myklemykle/tweacman/pcb/mykle-com-wble-tw-htm.png

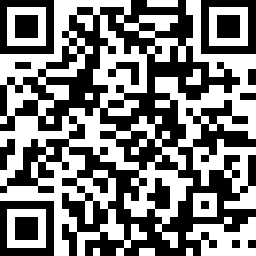
pcb/mykle-com-wble-tw-htm.png
