myklemykle/tweacman/pcb/cassette-carrier-bom.csv

References | Qty | Value | Buy (spec) | Manufacturer | MPN | Footprint | Notes | LCSC # | LCSC part | LCSC price (qty 1, USD) | LCSC stock | LCSC notes
C1, C2 | 2 | 6.8n | 6.8 nF, C0G/NP0 (or film), 50 V, radial, 5 mm lead pitch, 5% or better |  |  | C_Disc_D5.0mm_W2.5mm_P5.00mm | Sets the audio low-pass corner with R1/R2 (1k): tolerance and dielectric matter, avoid X7R here | C390177 | KYET PE682J2A0501 | 0.0437 | 2400 | Metallised polyester film 100 V 5%, 5 mm pitch. Only C0G found is C454391 (TORCH), stock 19, $0.454
C3, C4 | 2 | 2.2u | 2.2 uF non-polarised, film box (PET/PP) or radial MLCC, >=25 V, lead pitch 5.0-15.0 mm, under 10 mm tall |  |  | C_DCBlock_Dual | Audio DC blocker; the footprint takes 5.0/7.5/10.0/12.5/15.0 mm lead spacing. Film preferred for audio | C53070641 | DGCX MPE225J2AB070B200ZR | 0.35 | 750 | Polyester film 100 V 10%, 7.5 mm pitch. Alts: C3019042 KYET 5 mm $0.578; C46638925 WALSON 15 mm $0.203. Check height < 10 mm
C5, C6, C7, C8 | 4 | 100n | 100 nF, X7R, 50 V, radial, 5 mm lead pitch |  |  | C_Disc_D5.0mm_W2.5mm_P5.00mm | Pot wiper filter (4x) and general decoupling | C5632426 | KNSCHA 178MU0002 | 0.0138 | 5076 | X7R 50 V 10%, 5.08 mm pitch
C9 | 1 | 10u | 10 uF aluminium electrolytic, >=16 V, radial, 5 mm dia, 2.0 mm lead pitch |  |  | CP_Radial_D5.0mm_P2.00mm | Pot supply filter; watch the polarity (long lead = +) | C55265437 | TOPAZ ESS1V100M050700B | 0.0093 | 3244 | 35 V, 5 x 7 mm, 2 mm pitch
C10 | 1 | 10n | 10 nF, C0G/NP0 or X7R, 50 V, radial, 5 mm lead pitch, 10% or better |  |  | C_Disc_D5.0mm_W2.5mm_P5.00mm | CTSU TSCAP reference cap: needed for touch to work | C454414 | TORCH CC4-0805-CG-50V-0.01uF-J | 0.1285 | 6016 | C0G 5%, 5.08 mm pitch. Cheaper X7R: C5632432 KNSCHA $0.0196
J1 | 1 | STX-3120-3B | 3.5 mm stereo jack, right angle, all plastic | Kycon | STX-3120-3B | Kycon_STX-3120-3B | Colour variants exist; check the suffix at the vendor |  |  |  |  | not stocked at LCSC
J2 | 1 | LiPo JST-PH | JST PH 2-pin header, 2.0 mm, right angle (side entry), through hole | JST | S2B-PH-K-S(LF)(SN) | JST_PH_S2B-PH-K_1x02_P2.00mm_Horizontal | LiPo battery socket; rated 2 A | C173752 | JST S2B-PH-K-S(LF)(SN) | 0.0395 | 193766 | Looked up 2026-09-25
R1, R2 | 2 | 1k | 1 kOhm 1/8 W (or 1/4 W) axial, 1% metal film |  |  | R_Axial_DIN0204_L3.6mm_D1.6mm_P7.62mm_Horizontal | Audio low-pass resistor | C1371015 | YAGEO MFR-12FTF52-1K | 0.0045 | 3000 | 1% metal film, 1/6 W, 1.9 x 3.4 mm
R3 | 1 | 22 | 22 Ohm 1/8 W axial, 1% metal film |  |  | R_Axial_DIN0204_P7.62mm_CutJumper | Optional pot-supply filter resistor; the footprint's jumper shorts it until you cut it | C2848542 | VO MF1/8W-22R-1%-OT52 | 0.0066 | 2805 | 1% metal film, 1/8 W, 2.3 x 3.7 mm
R4, R5 | 2 | 560 | 560 Ohm 1/8 W (or 1/4 W) axial, 1% metal film |  |  | R_Axial_DIN0204_L3.6mm_D1.6mm_P7.62mm_Horizontal | Series resistor for each touch pad (CTSU) |  |  |  |  | No 1/8 W metal film in stock. 1/4 W bodies are ~6.3 mm long (tight on 7.62 pitch): C2848609 VO $0.0065, C1369978 YAGEO $0.0183
RV1, RV2 | 2 | RV112FF-40-25A-0B10K | Dual 10 kOhm endless rotary potentiometer, 25 mm plastic shaft | Taiwan Alpha | RV112FF-40-25A-0B10K | RV112FF-40 | Shaft length is in the part number; the footprint is the same for other lengths |  |  |  |  | not stocked at LCSC
SW1 | 1 | EG1224 | Slide switch, SPDT, right angle, 0.1 in pin pitch | E-Switch | EG1224 | SW_E-Switch_EG1224_SPDT_Angled | Power switch in the battery line (J2 to the Thing Plus's VBAT pin) | C273395 | E-Switch EG1224 | 1.7269 | 157
U1 | 1 | Thing Plus RA6M5 | SparkFun Thing Plus RA6M5, long variant, with male headers fitted | SparkFun |  | ThingPlus | The MCU board; not made by this project. Male-header pin tails must suit a 3 mm socket
XS1 | 1 | 1x12 socket | 1x12 female header, 2.54 mm, 3 mm insulation height (low profile), round-hole turned pin | HCTL | PM254-1-12-Z-3.0-C | None | LCSC C5156451; carries the Thing Plus left column | C5156451 | HCTL PM254-1-12-Z-3.0-C | 0.4265 | 496 | $0.3337 at 10+
XS2 | 1 | 1x16 socket | 1x16 female header, 2.54 mm, 3 mm insulation height (low profile), round-hole turned pin | HCTL | PM254-1-16-Z-3.0-C | None | LCSC C5159943; carries the Thing Plus right column | C5159943 | HCTL PM254-1-16-Z-3.0-C | 0.4704 | 223 | $0.3728 at 10+
RV1, RV2 | 2 |  | Knob, black, 24.1 mm dia x 10.3 mm tall, round, with a white indicator notch | Same Sky | SPK-013A |  | Check that the bore matches the RV112FF-40 shaft |  |  |  |  | not checked
U1 mounting | 4 |  | Screws + spacers/bushings for the Thing Plus mounting holes (3.05 mm holes), standoff about 5.5 mm |  |  |  | Your choice: spacer height = 3 mm socket + 2.5 mm header body
MH1-MH4 | 4 |  | M3 screws/standoffs for the case-mounting holes |  |  |  | Length depends on your case
