myklemykle/tweacman/hardware/scrub_knob.stl

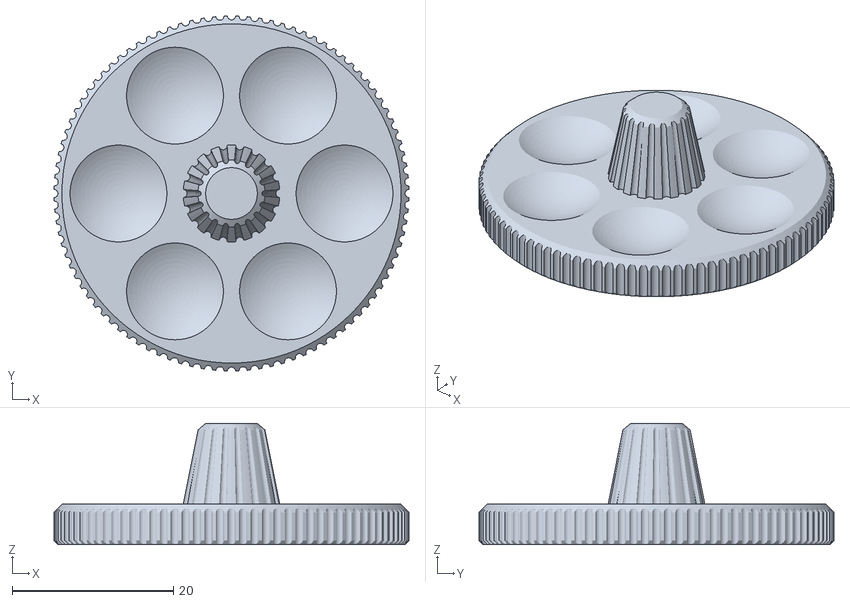
[picture p2: CAD file, 2026-10-06]
hardware/scrub_knob.stl
44.0 x 44.0 x 15.0
