myklemykle/tweacman/pcb/cassette-carrier.kicad_pcb

## KiCad design pcb/cassette-carrier.kicad_pcb (2026-10-10)

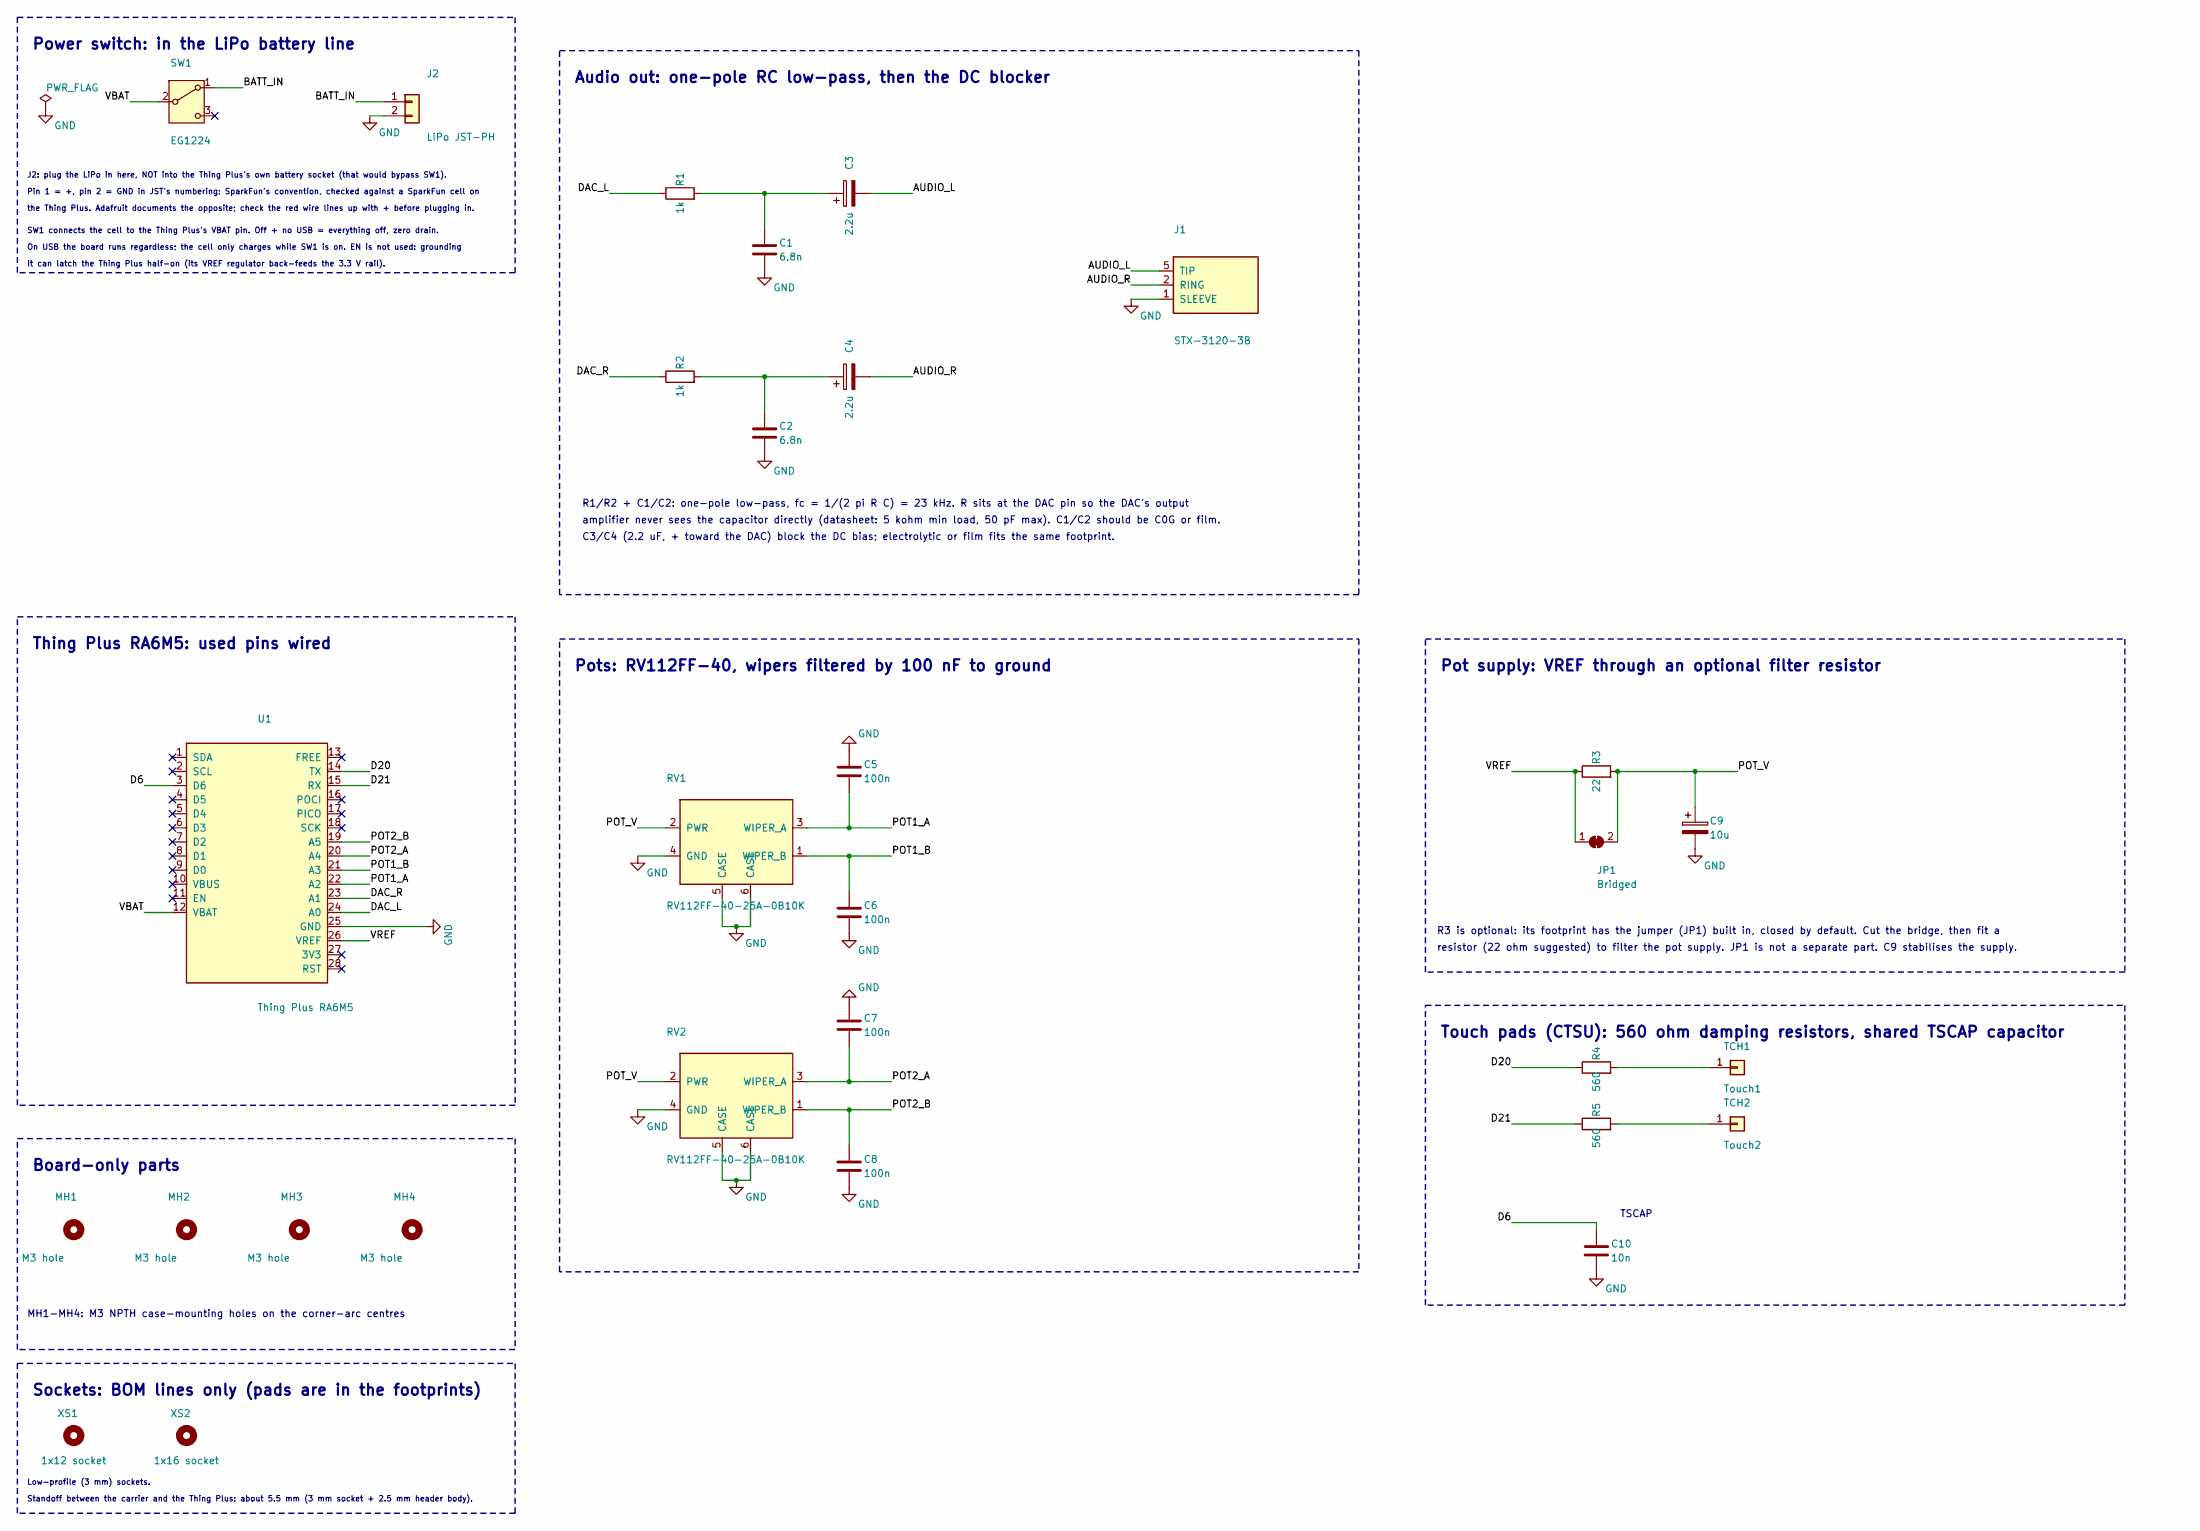
[picture p3: schematic cassette-carrier.kicad_sch, Cassette carrier]

Parts:
C1, C2: 6.8n; C_Disc_D5.0mm_W2.5mm_P5.00mm
C3, C4: 2.2u; C_DCBlock_Dual
C5, C6, C7, C8: 100n; C_Disc_D5.0mm_W2.5mm_P5.00mm
C9: 10u; CP_Radial_D5.0mm_P2.00mm
C10: 10n; C_Disc_D5.0mm_W2.5mm_P5.00mm
J1: STX-3120-3B; Kycon_STX-3120-3B
J2: LiPo JST-PH; JST_PH_S2B-PH-K_1x02_P2.00mm_Horizontal
JP1: Bridged; SolderJumper-2_P1.3mm_Bridged_RoundedPad1.0x1.5mm
MH1, MH2, MH3, MH4: M3 hole; MountingHole_M3_NPTH
R1, R2: 1k; R_Axial_DIN0204_L3.6mm_D1.6mm_P7.62mm_Horizontal
R3: 22; R_Axial_DIN0204_P7.62mm_CutJumper
R4, R5: 560; R_Axial_DIN0204_L3.6mm_D1.6mm_P7.62mm_Horizontal
RV1, RV2: RV112FF-40-25A-0B10K; RV112FF-40
SW1: EG1224; SW_E-Switch_EG1224_SPDT_Angled
TCH1: Touch1; TouchPad_33.6x16.8
TCH2: Touch2; TouchPad_33.6x16.8
U1: Thing Plus RA6M5; ThingPlus
XS1: 1x12 socket; MPN PM254-1-12-Z-3.0-C; LCSC C5156451
XS2: 1x16 socket; MPN PM254-1-16-Z-3.0-C; LCSC C5159943

Connections:
/AUDIO_L: C3.2, J1.5 (TIP)
/AUDIO_R: C4.2, J1.2 (RING)
/BATT_IN: J2.1, SW1.1 (A)
/D6: C10.1, U1.3 (D6)
/D20: R4.1, U1.14 (TX)
/D21: R5.1, U1.15 (RX)
/DAC_L: R1.1, U1.24 (A0)
/DAC_R: R2.1, U1.23 (A1)
/POT1_A: C5.1, RV1.3 (WIPER_A), U1.22 (A2)
/POT1_B: C6.1, RV1.1 (WIPER_B), U1.21 (A3)
/POT2_A: C7.1, RV2.3 (WIPER_A), U1.20 (A4)
/POT2_B: C8.1, RV2.1 (WIPER_B), U1.19 (A5)
/POT_V: C9.1, JP1.2 (B), R3.2, RV1.2 (PWR), RV2.2 (PWR)
/VBAT: SW1.2 (B), U1.12 (VBAT)
/VREF: JP1.1 (A), R3.1, U1.26 (VREF)
GND: C1.2, C2.2, C5.2, C6.2, C7.2, C8.2, C9.2, C10.2, J1.1 (SLEEVE), J2.2, RV1.4 (GND), RV1.5 (CASE), RV1.6 (CASE), RV2.4 (GND), RV2.5 (CASE), RV2.6 (CASE), U1.25 (GND)
unnamed: C1.1, C3.1, R1.2
unnamed: C2.1, C4.1, R2.2
unnamed: R4.2, TCH1.1
unnamed: R5.2, TCH2.1

Notes on the sheet:
Thing Plus RA6M5: used pins wired
Audio out: one-pole RC low-pass, then the DC blocker
R1/R2 + C1/C2: one-pole low-pass, fc = 1/(2 pi R C) = 23 kHz. R sits at the DAC pin so the DAC's output
amplifier never sees the capacitor directly (datasheet: 5 kohm min load, 50 pF max). C1/C2 should be C0G or film.
C3/C4 (2.2 uF, + toward the DAC) block the DC bias; electrolytic or film fits the same footprint.
Pots: RV112FF-40, wipers filtered by 100 nF to ground
Pot supply: VREF through an optional filter resistor
R3 is optional: its footprint has the jumper (JP1) built in, closed by default. Cut the bridge, then fit a
resistor (22 ohm suggested) to filter the pot supply. JP1 is not a separate part. C9 stabilises the supply.
Touch pads (CTSU): 560 ohm damping resistors, shared TSCAP capacitor
TSCAP
Power switch: in the LiPo battery line
J2: plug the LiPo in here, NOT into the Thing Plus's own battery socket (that would bypass SW1).
Pin 1 = +, pin 2 = GND in JST's numbering: SparkFun's convention, checked against a SparkFun cell on
the Thing Plus. Adafruit documents the opposite; check the red wire lines up with + before plugging in.
SW1 connects the cell to the Thing Plus's VBAT pin. Off + no USB = everything off, zero drain.
On USB the board runs regardless; the cell only charges while SW1 is on. EN is not used: grounding
it can latch the Thing Plus half-on (its VREF regulator back-feeds the 3.3 V rail).
Sockets: BOM lines only (pads are in the footprints)
Low-profile (3 mm) sockets.
Standoff between the carrier and the Thing Plus: about 5.5 mm (3 mm socket + 2.5 mm header body).
Board-only parts
MH1-MH4: M3 NPTH case-mounting holes on the corner-arc centres

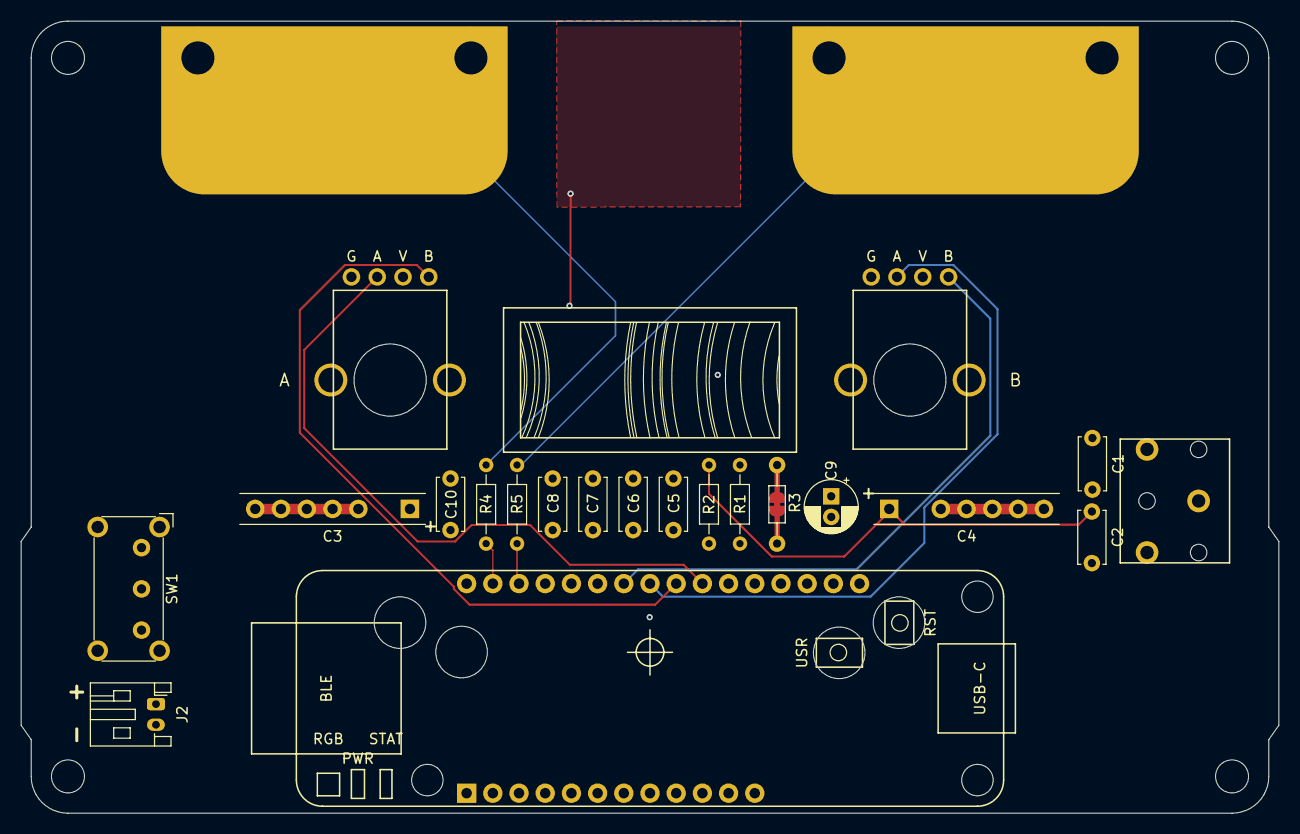
[picture p4: board cassette-carrier.kicad_pcb from above]

Board: 4 copper layers, 122.0 x 76.8 mm, 27 parts (0 on the bottom side), 20 nets.
