myklemykle/tweacman/RV112FF/src/RV112FF.h

// SPDX-License-Identifier: LGPL-3.0-or-later
// Copyright (C) 2026 Mykle Hansen
// Specified by Mykle Hansen, implemented by Claude (Anthropic).

/*
  RV112FF.h - Taiwan Alpha RV112FF-40 dual 360-degree potentiometer

  The RV112FF-40 is a single-turn potentiometer with two independent
  wipers, mechanically offset 90 degrees from each other on the same
  shaft. Wire its two track ends to a supply and ground, and its two
  wipers to two analog input pins: as the shaft turns, each wiper's
  voltage traces a triangle wave, and the two waves are 90 degrees out
  of phase with each other - like a pair of quadrature signals, just
  triangular rather than sinusoidal. That's enough to reconstruct an
  absolute shaft angle with plain trigonometry, no moving reference
  point and no interrupts required.

  API style follows PJRC's Encoder library - read() returns the current
  position, polled from loop() rather than interrupt-driven - with two
  differences that follow from the hardware itself rather than taste:

    - read() returns a float in degrees [0, 360), not an accumulating
      integer count. This pot has no multi-turn memory: it's a single-
      turn absolute sensor, so "position" means "where the shaft is
      right now," not "how far it's been turned since power-on."

    - There's no write(). An encoder's count is arbitrary and needs an
      external reference to mean anything, so write() lets you set that
      reference. This pot's angle is read directly off where the shaft
      physically is; there's nothing meaningful to set it to.

  Self-calibrating: each wiper's real-world voltage range varies with
  the individual pot and its wiring, so this tracks the observed
  min/max of each wiper as the shaft turns and uses that instead of
  assuming a fixed range. read() returns -1 until calibration is
  complete: the shaft has turned one full revolution since either
  wiper's observed range last grew. A full turn carries each wiper
  through both of its extremes, so a turn that finds nothing new means
  the whole range has been seen - in practice, about two turns from
  power-on. To skip that at every boot, save the calibration once with
  getCalibration() and restore it in setup() with setCalibration().

  Takes every bit the board's ADC has: on first use it calls
  analogReadResolution(16), regardless of what the rest of the sketch
  has set it to - that setting is board-wide, so other analogRead()s
  get 16-bit values too. Arduino's convention is that this only scales
  the result, padding a 12-bit reading with zeros, so it's right
  whatever the ADC's real resolution: exact on a 12-bit ADC, all 14
  bits of a 14-bit one. Two exceptions are handled below
  (RV112FF_ADC_BITS): Teensy 4 stays at 12 bits if asked for more, and
  classic AVR boards (Uno R3, Mega, Teensy 2) have no
  analogReadResolution() at all - their ADC is always 10 bits. On AVR,
  expect each read() to take about half a millisecond: two or more
  ~112us conversions, and atan2() and exp() in software floating point.
  AVR support compiles but is untested on real hardware.

  A note on NVM wear, if you're persisting getCalibration()'s result
  (e.g. with the EEPROM library, which on many boards is emulated in
  flash): that storage often doesn't wear-level, and EEPROM.put() only
  skips a write when the new bytes are byte-for-byte identical to
  what's already there. That's no help here, since the calibration
  envelope legitimately changes a little on almost every read() while a
  shaft is actively being calibrated. Call getCalibration() and save its result
  deliberately - once calibration completes, on a button press, rate-
  limited - not on every read().
*/

#ifndef RV112FF_h
#define RV112FF_h

#include <Arduino.h>

// The resolution this library asks analogReadResolution() for, and so the
// full scale it divides each reading by - see the class comment.
#if defined(__AVR__)
#define RV112FF_ADC_BITS 10  // classic AVR: always 10 bits, can't be set (untested)
#define RV112FF_FIXED_ADC_RESOLUTION
#elif defined(__IMXRT1062__)
#define RV112FF_ADC_BITS 12  // Teensy 4: stays at 12 bits if asked for more
#else
#define RV112FF_ADC_BITS 16
#endif

// Snapshot of a pot's calibration state, for storing in NVM (e.g. via
// EEPROM.put()/EEPROM.get() - see getCalibration()/setCalibration() below)
// and restoring after a reboot, so the sketch doesn't need the user to
// sweep the shaft through a full rotation again every power-on.
//
// magic and version aren't meant to be inspected by sketches - they let
// setCalibration() tell "this really is calibration data, written by a
// version of this library that laid it out the way I expect" apart from
// "this is erased flash, garbage, or an incompatible version" and refuse
// it rather than trust something it can't verify. checksum catches a
// write that got interrupted partway (e.g. power loss mid-save) -
// deliberately a plain byte sum rather than a real CRC, since the
// failure modes worth guarding against here are "garbage" and "partial
// write," not subtle single-bit corruption.
struct RV112FFCalibration {
  uint32_t magic;
  uint8_t version;
  uint8_t checksum;
  uint8_t complete;  // 1 if this snapshot was taken after calibration completed
  float minVal[2];
  float maxVal[2];
};

class RV112FF {
  public:
    // wiperPinA, wiperPinB: the two analog pins wired to the pot's wipers.
    // smoothTau: time constant (seconds) of the lowpass filter smoothing
    //   each wiper's raw reading - the main defense against ADC noise.
    // rpmSmoothTau: time constant (seconds) of rpm()'s own separate
    //   smoothing filter (see that method's comment). The default
    //   (0.15s) was tuned for using this pot as a position control,
    //   where rpm() is a secondary signal - a use that's read directly
    //   as an audio-rate control input (e.g. a tape-scrub effect) will
    //   likely want this much smaller, since a 150ms decay reads as
    //   noticeable "momentum" once rpm() itself is driving something
    //   audibly in real time.
    RV112FF(uint8_t wiperPinA, uint8_t wiperPinB,
            float smoothTau = 0.02, float rpmSmoothTau = 0.15);

    // Samples both wipers, updates calibration and the speed estimate,
    // and returns the current shaft angle in degrees [0, 360). Returns
    // -1 if not yet calibrated (see the class comment above). Call this
    // once per loop() pass; rpm() reports the speed computed as of the
    // most recent call here rather than sampling on its own.
    float read();

    // Rotational speed in RPM, signed: positive and negative indicate
    // opposite directions of rotation. Reflects the state as of the
    // last read() call. Lightly smoothed on its own, separately from
    // the position filter - speed is a derivative and amplifies noise
    // more than position does. Returns 0 before calibration.
    float rpm();

    // One wiper's reading as of the last read(), 0.0 to 1.0 of the ADC's
    // range: channel 0 is wiperPinA, 1 is wiperPinB. These are the
    // smoothed values the angle is decoded from, available even before
    // calibration completes - handy for plotting, to see what the pot
    // itself is doing.
    float wiper(uint8_t channel) const { return _smooth[channel ? 1 : 0]; }

    // True once calibration is complete - the shaft has turned a full
    // revolution since either wiper's observed range last grew (see the
    // class comment) - or a complete calibration has been restored with
    // setCalibration(). Until then read() returns -1 and rpm() returns 0.
    // Once true it stays true until resetCalibration(). The observed
    // range can still widen a little after that, and read() uses it.
    bool isCalibrated() const { return _calibrated; }

    // Forgets the observed min/max range and starts calibrating again
    // from the next read(). Not needed in normal use - the shaft only
    // has one range to learn - but useful if you suspect a bad reading
    // latched into the envelope before the pot had settled (e.g. right
    // after a noisy power-on).
    void resetCalibration();

    // Returns a snapshot of the current calibration, ready to hand to
    // something like EEPROM.put() for storage across a reboot. Save it
    // once isCalibrated() is true. A snapshot taken earlier is still
    // valid, but restoring it just resumes calibrating from that point,
    // with read() returning -1 until another full turn completes it.
    RV112FFCalibration getCalibration() const;

    // Restores a previously-saved calibration (see getCalibration()).
    // Returns true and adopts it if it passes validation (magic, version,
    // checksum, and a basic sanity check on the ranges); otherwise leaves
    // the current calibration state untouched and returns false. Safe to
    // call with anything - freshly-erased flash, a different pot's data,
    // data from an incompatible future version of this library - it will
    // simply refuse rather than trust something it can't verify. Deciding
    // *when* to call this, and when to call getCalibration() to persist
    // one, is left to the sketch - see the class comment's note on NVM
    // wear if you're saving what this returns.
    bool setCalibration(const RV112FFCalibration &cal);

    // How many extra conversions to make, and throw away, before each
    // wiper reading that counts. Default 1.
    //
    // Why: most microcontrollers' ADCs measure a pin by charging one small
    // internal capacitor shared by every analog pin, and a pot's wiper is a
    // high-impedance source that charges it slowly - so a reading can come
    // out pulled toward whichever pin was measured just before it. With
    // two pots on neighbouring pins, turning one then makes the other seem
    // to move. A throwaway conversion first is the standard portable
    // remedy, and costs a few microseconds per wiper.
    //
    // Set it to 0 if your board fixes this properly in hardware - e.g. by
    // lengthening the ADC's sampling time, on chips that allow it, which
    // can remove it outright and make the extra conversion pure overhead.
    // Raise it if you measure crosstalk left over on a board without such
    // an option.
    void setSettlingReads(uint8_t reads) { _settlingReads = reads; }
    uint8_t getSettlingReads() const { return _settlingReads; }

    // How many readings of each wiper to average into one, taken back to
    // back. Default 1 (no averaging). Averaging N readings cuts fast,
    // random ADC noise by about the square root of N - 4 halves it - at
    // the cost of N conversions instead of one, a few microseconds each on
    // most boards. It adds no lag, since all N are taken at once: unlike
    // raising smoothTau, it doesn't make the knob respond more slowly.
    // It can't reduce slow noise such as mains hum, which looks the same
    // in all N readings. Worth raising when rpm() drives something that
    // needs to sit perfectly still at rest.
    void setOversampling(uint8_t readings) { _oversampling = (readings < 1) ? 1 : readings; }
    uint8_t getOversampling() const { return _oversampling; }

    // How much of the ADC's full scale (0.0-1.0) each wiper must have swept
    // before the pot starts working out an angle at all. Default 0.15.
    //
    // Why: the angle comes from each wiper's reading as a fraction of the
    // range it has swept so far. Over a tiny range, ADC noise alone would
    // turn into wild swings of angle, and spoil the count of the full turn
    // that completes calibration (see isCalibrated()) - so nothing is
    // decoded until the range is big enough to trust. It doesn't set when
    // calibration completes; that's the full turn. setCalibration() also
    // refuses a saved range smaller than this, as bad data.
    //
    // You'd only lower it if a wiper can't swing that far on your wiring -
    // say a series resistor in the track, or track ends on a voltage well
    // below the ADC's reference. Then the pot never calibrates at all, and
    // nothing says why: plot each wiper() while turning the knob to see
    // its real swing, and set this comfortably below it. Set it before
    // setCalibration(), which checks against it.
    void setMinCalibrationRange(float fraction) { _minCalibrationRange = fraction; }
    float getMinCalibrationRange() const { return _minCalibrationRange; }

  private:
    uint8_t _pinA, _pinB;
    float _smoothTau;
    float _minCalibrationRange = 0.15;
    float _rpmSmoothTau;
    uint8_t _settlingReads = 1;
    uint8_t _oversampling = 1;

    float _smooth[2];
    float _minVal[2];
    float _maxVal[2];

    float _angle = -1;
    float _prevAngle = -1;
    float _rpm = 0;
    bool _calibrated = false;

    // Progress toward a complete calibration: the observed range as it
    // stood when the current turn started counting, and the lowest and
    // highest unwrapped angle reached since then. See read().
    float _markMin[2];
    float _markMax[2];
    float _turnPos = 0;
    float _turnLow = 0;
    float _turnHigh = 0;

    // How far, as a fraction of full scale, a wiper's observed range may
    // grow without restarting the turn count. The smoothed signal creeps
    // up on a peak in tiny steps, and noise can nudge it, so any growth
    // at all would make a turn that finds nothing new hard to finish.
    static constexpr float RANGE_GROWTH_TOLERANCE = 0.005;
    bool _begun = false;
    unsigned long _lastMicros = 0;

    static constexpr float ADC_MAX_VALUE = (1UL << RV112FF_ADC_BITS) - 1;

    static constexpr uint32_t CALIBRATION_MAGIC = 0x52563132;  // ASCII "RV12"
    static constexpr uint8_t CALIBRATION_VERSION = 2;

    float readWiper(uint8_t pin, uint8_t channel, float dtSeconds);
    bool rangeGrewSinceMark() const;
    void restartTurnCount();

    static uint8_t sumBytes(const void *data, size_t len, uint8_t sum);
    uint8_t calibrationChecksum(const RV112FFCalibration &cal) const;
};

#endif
