myklemykle/tweacman/SDResampleDemo/SDResampleDemo.ino

// SPDX-License-Identifier: GPL-3.0-or-later
// Copyright (C) 2026 Mykle Hansen
// Specified by Mykle Hansen, implemented by Claude (Anthropic).

/*
  SDResampleDemo - SparkFun Thing Plus RA6M5

  Streams a WAV file off the onboard SD card and plays it out the DAC,
  with one pot controlling a completely smooth, arbitrary, BIDIRECTIONAL
  playback-speed ratio - not discrete multiples, and slowing down (in
  either direction) genuinely interpolates new sample values rather than
  just repeating or stepping through existing ones. The pot sweeps from
  -MAX_RATIO smoothly through zero at the middle up to +MAX_RATIO;
  negative plays the file backward. A second pot scrubs, like a hand
  on the reel - see "Tape scrub" below. A phone/browser can also pick
  which file plays and watch the same live stats over BLE - see "BLE
  control" below.

  Wiring: an SD card (FAT32, any SDHC card - see the SD note in
  CLAUDE.md, this board's slot is wired to the RA6M5's native SDHI
  peripheral, not SPI) with WAV files on it - at its root, or sorted into
  folders, one per set (see "Sets" below) - use
  tools/make_test_wav.py to generate a simple one, a slow sine sweep
  that makes speed changes and any resampling artifacts obvious by ear.
  Otherwise same as DACAudioTest (3.5mm jack on A0/A1/GND) plus two pots
  (RV112FF wipers on A2/A3 for speed or pitch, A4/A5 for tape scrub or
  time-stretch, both pots' track ends on 3.3V/GND) and two CapTouch pads
  (D20 steps through the knob modes, and chorded with D21 latches the
  transport;
  D21 is the transport itself - hold it to run, release to stop; both
  share the TSCAP capacitor on D6 - see RA6M5CapTouch.h). The onboard WS2812
  on D13 shows the knob mode and the blue STAT LED the transport - no extra
  wiring. The DA14531MOD Bluetooth
  module used for BLE control is already onboard -
  no extra wiring for that part.

  Why the DAC runs at a fixed 48kHz: an earlier version of this idea
  just changed the DAC's own output clock to change speed, tape-style -
  simple, but it directly couples "how fast can we go" to the DAC
  hardware's own conversion-time ceiling (~333kHz per the RA6M5
  datasheet, Table 53.48). This version fixes the DAC at a constant,
  comfortable 48kHz always, and does real-time resampling from whatever
  rate the source is actually being read at. That decouples the speed
  knob from the DAC entirely.

  How the resampling works: RingBuffer.h holds raw samples read from SD,
  as a window that can slide in EITHER direction; Resampler.h tracks a
  signed fractional read position into that window and advances it by a
  continuously-variable, signed amount (`step`) once per 48kHz tick,
  interpolating a fresh output value with a windowed-sinc kernel each
  time (SincInterpolator.h) - one that low-passes as it goes when reading
  faster than real time, so speeding up never aliases. The same mechanism handles speeding up, slowing down,
  reversing direction, and pausing (step == 0, which freezes the
  position exactly with no special-casing needed) with no separate code
  path for any of them - see both of those files' own comments for more
  detail, and loop()'s refill comment for how the SD-reading side stays
  in sync with whichever direction is currently active.

  Very high speeds - cached copies: the speed range runs to MAX_RATIO,
  1024x, which is enough to sweep a 20Hz tone right up past 20kHz. Read
  straight from the WAV, that would be hopeless on two counts. The card
  can't deliver it - reading a 44.1kHz file at 20x already means reading
  20 seconds of audio every second, and that's where this demo used to
  hit its wall (~20x forward, ~13x backward). And it would sound wrong
  long before that: content pushed above what the DAC can reproduce
  doesn't vanish, it folds back down as aliasing - tones that move the
  wrong way as the speed rises, with a ring-modulator sound to them.

  So MipCache.h builds a ladder of filtered copies of each file on the
  card, in a cache/ folder - at 1/2, 1/4 ... 1/1024 of its sample rate,
  each holding only what will still be audible at the speeds it serves.
  At any speed, playback reads whichever copy keeps it stepping through
  about one sample per output sample (see chooseLevel()), so the card is
  never asked for much more than real time, whatever the speed, and
  aliasing stays out of the way. Changing copies is a straight swap
  between two playback voices, one playing while the other is readied
  (see "Playback voices" below, and startLevelChange()). Copies are built in the background the first time
  a file is cued - a few seconds for a short sample - and until they're
  ready the fastest speeds are capped; the Serial status and the BLE
  CACHE: field show progress. The copies live as long as their WAV and
  are rebuilt if it changes - see "BLE control" below for what happens to
  them when the web page uploads, renames or deletes a file.

  The copies alone don't make changing between them seamless, though.
  Each copy is free of aliasing only up to one sample per tick, so reading
  one any faster - which happens just below every switch - used to alias,
  and the switch made it suddenly vanish. What fixes that is the interpolator: it
  low-passes as it reads (SincInterpolator.h), so every copy is band-
  limited the same way on both sides of a switch. That costs CPU in the
  audio interrupt - the Serial status line reports how much ("isr avg/max",
  roughly 20-30% for mono and 30-40% for stereo normally, up to about 45%
  and 60% with the pitch shifter on, and about 12% more while the filter
  is in use - see "Filter"), along with "dropped", a count of audio ticks that never ran because
  something held interrupts off for longer than a tick (it restarts at
  each file load and transport start, which pause the audio on purpose).
  It should stay at zero; if it climbs, something is blocking too long.

  Tape scrub: turning the second pot takes over the playback cursor
  outright, like grabbing the reel - the transport waits underneath, and
  when the knob has been still for SCRUB_RELEASE_MS (150ms) playback
  carries on from wherever the knob left the tape. It works the same
  whether the transport runs or not. The knob's change in angle, not its
  speed, sets where the cursor should be, and the cursor is steered onto
  that target - so the knob's position maps exactly onto the file, and a
  small backlash (SCRUB_BACKLASH_DEGREES) keeps a resting knob silent
  without losing any of a long turn. How much of the file a turn covers
  is fitted to each file as it loads: about one second of audio, moved
  to the nearest power-of-two fraction or multiple of the file's length,
  so whole turns line up with the file's loop - see
  SCRUB_SECONDS_PER_TURN and scrubKnob().

  Relative speed control: the first pot is RELATIVE (like a DJ jog wheel
  or a DAW's jog control), not ABSOLUTE (like a normal volume knob, where
  a given shaft position always means the same value). Each file starts
  at its own saved speed - native (1.0x) for a file played for the first
  time, see "Per-file settings" below - regardless of wherever the
  physical pot happens to be sitting; only turning the pot moves speed
  from there, and by however much you turn it, not to wherever the pot's
  absolute position would otherwise map. This matters because the pot
  has no mechanical center detent or home position (see RV112FF.h - it's
  an endless-rotation part with no absolute "zero" a hobbyist could
  return it to), so an absolute mapping would make "start every file at
  native speed" impossible to hit reliably by hand. See knobForSpeed()/resetVirtualKnobToNative() and
  the control-rate block in loop() for the implementation - a small
  virtual position that starts anchored at native speed and accumulates
  the pot's own physical deltas from then on, the same idea as a
  relative/incremental encoder even though the underlying sensor is an
  absolute one.

  Per-file settings: each WAV keeps its own speed, pitch, window (see
  "Start and end points"), echo and filter, in a small text file under the card's settings/ folder (see FileSettings.h), so
  picking it again - or rebooting - brings them back. They're saved two
  seconds after the last change, and at once when another file is picked.
  The same folder remembers which file was cued, and the board cues it
  again at boot instead of the first file on the card. Settings follow a
  file when it's renamed, go when it's deleted, and survive uploading a
  new version of it.

  Underrun policy: if the ring buffer can't supply what the resampler
  needs, the DAC ISR holds the last good sample rather than dropping to
  silence - that's what a real buffer-starved device actually sounds
  like (a stuck stutter), and it avoids an extra click on both entering
  and leaving the underrun. The resampler's position is frozen too, so
  playback resumes exactly where it left off with no skipped content.
  underrunTicks (printed periodically over Serial, along with live ring
  buffer occupancy) should stay at zero at any speed once a file's
  copies are built - if it climbs, something is starving playback. It counts underruns for the *current file only*, resetting on every
  load, and does not tick at all while no file is loaded: with nothing
  playing there is no producer to fall behind, so idling is not an
  underrun. Before that distinction existed the counter accumulated
  48000 phantom underruns a second while the board sat idle at boot,
  which made the real figure meaningless.

  BLE control: connect with web/wav-remote.html (self-hosted with real
  HTTPS - can't be a Claude Artifact, see CLAUDE.md's Bluetooth section)
  to list the WAV files on the card, pick one, see and change everything
  the knobs set (a card per knob mode, the current one highlighted), and
  watch the same buffer/underrun stats live instead of over USB Serial.
  Reuses the
  CodeLess Binary mode/DSPS bidirectional protocol already validated in
  AudioKnobsWebBLEDemo - see that sketch and the codeless-binary-mode-
  dsps-protocol memory for the handshake itself. On top of that
  transport, this sketch speaks a small plain-text line protocol:
  `LIST` requests a `SETS:BEGIN`/one-`<set>|<gap>`-per-line/`SETS:END`
  block - the card's sets, see "Sets" below, "/" being the WAVs at its
  root - and then a `FILES:BEGIN:<set>`/one-name-per-line/`FILES:END:<n>`
  block (n being how many names were sent) for the current file's set, in the order the file knob steps
  through them (natural, case-blind - see WavList.h), so a client shows
  them as they come; `LIST:<set>` is the same with another set's names.
  A file is named everywhere else by its path, `<set>/<name>` (just
  `<name>` at the root). `PLAY:<path>` requests a switch, answered with `PLAYING:<name>` on
  success or `ERR:<name>:<reason>` on failure - a bad or unsupported
  file is a normal, reported failure, not a hang. The periodic stats line
  carries `RUN:0|1` alongside `SPD:`/`BUF:`/`UND:`, so a client can show
  whether the transport is running. `SPD:` is the effective ratio, so it
  reads 0.00 while stopped and follows the scrub knob while it's turning; `REQ:` is the
  speed knob's requested ratio, which survives being stopped, so a client
  can show what the transport *would* run at; `PIT:` is the pitch ratio,
  1.000 meaning unshifted; `ECT:` and `ECA:` are the echo's delay in seconds
  and its amount; `FLC:` and `FLW:` the filter's centre in Hz and its width
  in octaves, 0 to 10 (10.00 is wide open, no filter; see setFilterBand()); `LAT:0|1` is whether the transport is latched;
  `LVL:` is which copy is playing (0 the original, k the cached copy at
  1/2^k its rate); `CACHE:` is how far building those copies has got, in
  percent. For the page's tweaks tab there are also `MODE:`, the knob mode
  (0 for the first row of MODES); `HRD:`, the pitch you hear (the shift
  times the speed, which is what the pitch knob sets); and `WS:`, `WE:` and
  `LEN:`, the window's start and end and the file's length, in seconds, and
  `CUR:`, where the cursor is. For the page's set tab, `SET:0|1` is whether
  a set is playing through; `GAP:`, the current set's gap in seconds;
  `GL:`, only during a gap, the seconds left in it; and `PREP:<n>/<total>`,
  only while a set is being prepared, how far that's got; and `HLD:1`,
  only while the setlist's track is looping, latched by hand.
  If the board's fuel gauge answers (see FuelGauge.h) there are also
  `BAT:`, the battery's charge in percent; `BV:`, its voltage; and `BCR:`,
  the rate the charge is changing in percent per hour, negative while
  discharging - the page divides one by the other for the time left.

  The page can also drive the transport and manage the card:
    `LATCH:<name>`       load a file and latch the transport on - plays from
                         the top and keeps playing, answered like PLAY:
    `STOP`               clear the latch, as a touch2 press would
    `SETPLAY:<path>`     start the setlist of the set that file is in,
                         from that file - see "Sets"; `SETSTOP` turns it off
    `SETNEXT`, `SETPREV` the set's next track, or the one before, now
    `GAP:<set>|<s>`      set a set's gap between tracks, in seconds
    `PREP:<set>`         build the cached copies of every file in a set,
                         in the background - see "Preparing a set"
    `RESET:SPEED`        speed back to 1.0x
    `RESET:ALL`          everything saved per file back to its default, as
                         the triple tap does - see "Reset"
    `MODE:<n>`           select a knob mode, 0 for the first, as stepping
                         to it with D20 would
    `HEARD:<ratio>`      set the pitch you hear, as the pitch knob does:
                         the shift becomes whatever makes the current
                         speed sound at it
    `STRETCH:<ratio>`    set the speed with the pitch you hear held, as
                         the time-stretch knob does
    `TAPE:<ratio>`       set the speed and let the pitch follow, as the
                         speed knob does. (`SPEED:` is one or the other,
                         depending on the knob mode; these two say which.)
    `RESET:PITCH`        pitch back to unshifted
    `SPEED:<ratio>`      jump to an exact speed (negative is backward, 0
                         pauses); the knob carries on from there
    `PITCH:<ratio>`      set an exact pitch ratio (1 is unshifted)
    `WINDOW:<s>,<e>`     play only from <s> to <e> seconds into the file -
                         see "Start and end points"; `RESET:WINDOW` goes
                         back to the whole file
    `ECHO:<s>,<amount>`  set the echo: a delay of <s> seconds, and an amount
                         from 0 (none) to 0.95 - see "Echo"; `RESET:ECHO`
                         turns it off
    `FILTER:<low>,<high>` set the filter's bottom and top cutoffs, in Hz,
                         from 20 to 20480 (both at the ends is wide open,
                         no filter; both together, it screams) - see
                         "Filter"; `RESET:FILTER` opens it
    `BAND:<centre>,<oct>` the same, as the knobs set it: the band's centre
                         in Hz and its width in octaves, 0 to 10 (10 is
                         wide open)
    `RESET:CACHE`        throw away the current file's cached copies and
                         build them again - for a copy suspected of being
                         damaged, since they're otherwise kept up to date
                         on their own
    `PROFILE`            print, over USB Serial, how often each stage of
                         loop() did work since the last PROFILE and how long
                         it took - see "loop() profiling" further down
    `PUT:<bytes>:<name>` upload a file, creating or replacing <name> -
                         answered `READY:<name>`, then raw data flows with
                         `ACK:<bytes so far>` coming back, then
                         `SAVED:<name>`; see startUpload() for the flow
                         control, which is the tricky part
    `REN:<old>|<new>`    rename, answered `RENAMED:<old>|<new>` - into
                         another set, if the new path says so
    `DEL:<name>`         delete, answered `DELETED:<name>`
    `CAL`                print, over USB Serial, each knob's saved and live
                         calibration - see "Knob calibration" further down
    `RECAL`              forget both knobs' saved calibration and learn it
                         again
    `DISK:ON`            make the card a USB disk on the computer the board
                         is plugged into - answered `DISKMODE:ON`, repeated
                         in place of the status line until it's ejected
                         there, then `DISKMODE:OFF`; see "USB disk mode".
                         (Not DISK:ON back: in command mode the module
                         echoes everything, and the board would take its
                         own reply for the command again)
    `DISK:OFF`           take the card back without waiting for the eject -
                         an emergency exit only: the computer isn't told,
                         keeps the disk mounted with its own (soon stale)
                         copy of the file table, and could corrupt the card
                         with it the next time DISK:ON opens it up. Eject
                         it on the computer first, or unplug the cable
  Any of them can fail with the same `ERR:<name>:<reason>` as PLAY:. Names
  the page creates must end in .WAV, since those are the only files LIST
  shows. A command can arrive in several Bluetooth writes - the page splits
  one naming a long path - see pumpBLEInput(). Touching the file that is playing closes it first (FatFs can't
  change an open file) and then reloads it, or cues the next playable file
  if it's gone, restarting playback from the top. Each also keeps the
  file's cached copies in step: an upload that replaces a file deletes its
  old copies (they're rebuilt when it's next cued), a rename moves them to
  the new name rather than rebuilding, and a delete removes them. Copies
  whose WAV has vanished some other way - deleted from a computer, say -
  are cleared out at boot, and if the cache/ folder is deleted outright it
  is simply rebuilt.

  Every one of these commands also works typed into the USB serial
  monitor, one per line, which makes for easy testing without a phone:
  LATCH:<name> then SPEED:500, for instance.

  Transport: touch pad D21 held runs the tape, released stops it. Pressing
  D20 while D21 is held - or D21 while D20 is held, the chord works in
  either order - latches it on, so playback continues after the fingers
  lift; the next press of D21 on its own clears the latch, without interrupting
  playback, since that press is holding the transport up by itself. Starting
  rewinds to the top of the file, so each start plays from the beginning
  rather than resuming where scrubbing left off - engaging or clearing the
  latch mid-playback does not rewind, because playback never stops. Scrubbing
  still works while stopped - that is the point of expressing "stopped" as a
  speed of zero.

  Sets: each folder at the card's root is a set, and the WAVs at the root
  itself are one more, the default set - so a card is organised for a
  performance by dragging files into folders on a computer. Only one level
  deep: folders inside a set are ignored, as are the sketch's own cache/
  and settings/. A set's tracks are in the same order as everywhere else,
  so number the names to choose it ("01 - intro.wav"). The file knob steps
  through the current file's set only.

  The web page's Set tab plays a set through (SETPLAY:). Two things are
  going on then, named the same here and on the page: the deck - the
  transport, which plays the cued track - and the setlist, which waits its
  turn and cues the next. Each track plays once, from the start of its
  window to the end (or end to start, if its speed is backward), and the
  deck stops. Whenever the deck is stopped and nobody is playing - no pad
  touched, nothing being scrubbed - the setlist counts down its gap (10
  seconds unless changed, saved per set, see FileSettings.h), and when it
  runs out the next track starts, latched. Playing - the deck running,
  latched or looping, a pad touched, a scrub - has the setlist stand by
  and start its count over. After the last track the setlist is off. Each
  track keeps its own saved speed, pitch, window, echo and filter, and the
  knobs and pads work as ever meanwhile: scrubbing never ends a track, nor
  does holding D21 - pressing it takes the deck from the setlist's latch,
  and the track goes round for as long as the finger stays - and pressing
  D21 after a track has played out plays it again from the top.
  Latching by hand - the D20+D21 chord, or the page's play button on the
  cued track - sets the track looping: round its window, as outside a set,
  until it's stopped (D21, or the page's stop). Next and Prev on the page
  change track straight away, whatever's happening. The Set tab's Stop
  setlist (SETSTOP), or picking a single file, turns the setlist off. The
  echo and filter ring out into the gap, since the next file isn't loaded
  until the gap is over. The end of a track is caught in the audio
  interrupt, so not a sample of its start is heard again - see setlistOn.

  Reset: tapping both pads together three times in a row puts the current
  file's speed, pitch, start and end points, echo and filter back to their
  defaults, and the RGB LED flashes white to say so. The first of the
  three taps latches the transport like any other chord, and it stays
  latched. The taps have to be taps - each under 0.4 seconds, and no more
  than that apart - so latching and holding never counts toward one. See
  "Triple tap" in the code.

  Knob modes: tapping D20 on its own (not chorded with D21, which latches)
  steps to the next knob mode, round and round. Holding it turns the knobs
  into selectors: knob1 steps through the modes, forward or back, one every
  60 degrees, so any mode is one gesture away; knob2 steps through the WAVs
  in the current file's set, one every 30 degrees, and plays each one it lands on from
  its start, until D20 is released - or on past that, if the transport was
  already latched on. Each mode gives the two
  knobs a different job, and is one row of the MODES table - see "Knob
  modes" further down. Five are built so far. In speed mode knob1 sets the
  speed, tape-style (any pitch shift stays a ratio on top), and knob2
  scrubs. In pitch mode knob1 sets the pitch you hear and knob2 stretches
  time - see below. Switching never changes the sound by itself. Pitch is saved per file, like
  speed (see "Per-file settings"). The pitch knob is relative, at
  PITCH_OCTAVES_PER_TURN octaves per turn from wherever the pitch is, out to
  PITCH_OCTAVE_LIMIT octaves either way, where it stops. Speed
  and pitch are genuinely independent: the nominal playback position still
  advances at the speed ratio alone - which is what the SD refill is built
  around - while a two-tap granular shifter reads around it at speed * pitch.
  See the pitch shifting comment further down for how that works and what
  it costs.

  Time-stretch: in pitch mode, knob2 turns the same speed dial knob1 does in
  speed mode - the full range, through zero and backward - while the pitch
  you hear stays where knob1 set it. The pitch shifter's grains read at that
  pitch whatever the speed (see grainTapRate), which also works at a speed of
  zero: the grains keep playing in place, a granular freeze. To keep the
  treble, the cached copy is chosen by the grains' read rate rather than the
  speed (see the copy change in loop()), which keeps full quality up to about
  8x; beyond that the copies take over and the treble drops away. Expect a
  sound rather than a studio stretcher: clean around 0.5x-2x, more grainy
  further out.

  Start and end points: in the third mode (purple), knob1 moves the start of
  the stretch of file that plays and knob2 its end - the "window". The other
  modes then treat the window as the whole tape: it loops, the transport
  rewinds to its start (so tapping D21 auditions the start point), and the
  scrub goes round it. Both knobs are relative, at the scrub knob's rate.
  The two ends can't come closer than WINDOW_MIN_SECONDS (20ms): push one
  into the other and both move, so at that width either knob slides the
  window along the file. An end stops at the end of the file, rather than
  carrying on round it. The join from the window's end back to its start is
  crossfaded over a few milliseconds, so it doesn't click (the whole file,
  with nothing either side to fade with, loops as it always did). If an end
  is moved past the playing position,
  playback carries on from the window's start. Moving the window never
  interrupts the sound - see "The window" further down for how, given that
  audio is read from the card well ahead of where it's playing.

  Echo: in the fourth mode (pink), knob1 sets an echo's delay time and
  knob2 how much of it there is - one amount for both its level and its
  feedback, so more means louder repeats and more of them. It's off until
  knob2 is turned up. The delay runs from a millisecond (not an echo at that
  length but a metallic ring) to 2.7 seconds, three octaves per turn, and
  turning it bends the pitch of the echoes already on their way, as moving
  the head of a tape echo would. The echoes are mono and duller than the
  sound itself, increasingly so as they repeat: the delay is kept in RAM,
  and making 2.7 seconds of it fit meant keeping less of the signal - see
  EchoDelay.h, which explains all of this. The echo applies to whatever
  comes out, in every mode. When the transport stops, the echoes neither
  ring on for ever nor are cut dead: they carry on repeating while fading
  out smoothly over three delay times (half a second at least), and then the
  feedback is taken away. Scrubbing a stopped tape brings the echo back for
  as long as the knob keeps moving, and it fades the same way when the knob
  comes to rest. Both settings are saved per file.

  Filter: in the fifth mode (orange), the knobs play a resonant band-pass
  filter, in the spirit of a Korg MS-20's: knob1 sets the band's width, from
  ten octaves - wide open, the whole audible range, no filter at all - down
  to nothing, and knob2 its centre - five octaves per turn round the
  middle, 640Hz, faster further out, two turns each way. Wide open is the
  top of a hill for knob1: turning either way from it narrows the band,
  quickly at first, so a quarter turn
  is plain to hear, then more slowly, over a turn and a half in all;
  turning back stops at wide open. Narrowing the band, the sound thins to
  it, with a bump at each edge, and over the last couple of octaves the
  resonance rises until the filter screams by itself, as an analog one
  does - and knob2 then plays the scream's pitch. Moving the centre slides
  both edges of the band together, keeping the width; even wide open, that
  brings one edge into hearing. At the ends of its travel the whole band
  has slid out past what you can hear - which a digital filter can't
  really do, so the sound is faded instead as the filter's own slope would
  fade it - and it's silent - see setFilterBand() and BandFilter.h. The
  scream is kept in
  hand by soft clipping, as the MS-20's is by diodes, so it settles at a
  steady level rather than running away. When the transport stops it fades
  out with the echo, over three echo delay times - otherwise someone outside
  filter mode could be left with a scream they couldn't find the knob for -
  and it comes back when the tape plays again. The filter comes before the
  echo, so the echoes are filtered too. It costs about 12% of the audio
  interrupt's time while in use, and nothing wide open. See BandFilter.h,
  which explains how, and tools/filter_render.cpp, which runs the same
  filter on a computer for measuring and listening. Both settings are saved
  per file.

  Two LEDs show the state. The onboard WS2812 on D13 is always lit, in the
  colour of the knob mode: green for speed mode, aqua for pitch mode, purple
  for the window, pink for the echo, orange for the filter (no red or blue, which the board's other LEDs already use) - at RGBLED_BRIGHTNESS or a little
  less, 10% of what the LED can actually do, since it is startlingly bright
  otherwise. The blue STAT LED shows the transport: dark when stopped,
  blinking while running from a held finger, steady when latched. (One LED used to do both jobs, by colour and by blinking, which
  left the mode invisible whenever the transport was stopped.)

  USB disk mode: DISK:ON (the web page's "USB disk" button) hands the SD
  card to the computer at the other end of the USB cable, where it appears
  as a drive - far quicker than uploading over BLE for moving WAVs on and
  off. The board stops playing, saves the file's settings, unmounts the
  card and then opens UsbDiskGate (UsbDiskGate.h), which until then has
  told the computer there's no card in the drive. Ejecting the drive on the
  computer, or unplugging the cable (or the computer going to sleep - see
  watchUsbHost()), closes the gate again; the sketch
  mounts the card, tidies up after any files deleted or renamed there (as
  at boot) and cues the remembered file. (DISK:OFF also takes it back, but
  the computer isn't told, so it's an emergency exit only. Dropping off USB
  and reconnecting, to make the computer look again, was tried - with
  tud_disconnect()/tud_connect() - and hung the board.) Only one side may
  ever have the card: each keeps its own copy of the file table in memory,
  and two writers would corrupt it. The USB serial port keeps working
  throughout. It needs the core's UsbMsd
  library plus a workaround for a bug in it on this board's full-speed USB
  port, without which the board doesn't come up on USB at all - see
  fixUsbDiskPacketSize(). macOS leaves a hidden "._" file beside every file
  it copies onto a FAT card; names starting with a dot are never listed.

  File formats: mono or stereo, at any sample rate, in 8-, 16-, 24- or
  32-bit PCM or 32- or 64-bit float, with plain or WAVE_FORMAT_EXTENSIBLE
  headers - see WavReader.h, which converts each to the 16 bits everything
  else here works in. Stereo plays left out of A0 (the jack's tip) and right
  out of A1 (its ring); mono plays the same signal out of both. Files with
  more channels, and compressed ones (ADPCM, A-law...), are refused with a
  clear ERR: over BLE. tools/make_format_test_wavs.py writes a set of test
  files covering all of it, each playing the same three notes (an octave
  lower on the right, for the stereo ones), so at 1x they should all sound
  alike.

  Nothing is loaded or played until a BLE PLAY: command asks for it -
  the board boots silent, with no SD reads happening in loop() at all.
  At boot the first playable file on the card is cued automatically, so the
  board works standing on its own: hold the transport pad and it makes a
  sound, with no phone or BLE connection involved. Files this demo cannot
  open are skipped rather than stopping the search, which matters on a real
  sample card. Nothing is read from the card after that until the transport
  actually runs.

  This started as a fix for a bug it turned out not to cause. Inbound BLE
  commands were never reaching the board, and loop()'s greedy, unthrottled
  SD refill was the prime suspect - the one thing structurally different
  from AudioKnobsWebBLEDemo, which never touches SD. The theory was that a
  `wav.readSamples()` call could take long enough to let Serial2's RX
  buffer overflow before the next ble.available() check, silently dropping
  exactly this kind of small, rare inbound write.

  The handshake described as "confirmed clean" at the time was not clean.
  The sketch set its Binary mode flag on faith, while the module was still
  in AT-command mode for the whole session - so inbound data was being fed
  to a command parser rather than a pipe, and outbound data was echoed
  straight back. See the BLE section below and AudioKnobsWebBLEDemo.ino's
  header comment for what was actually happening.

  Staying off the SD card until a file is wanted is kept anyway: it is
  still the right shape for a demo whose whole point is to measure the
  card's sustained throughput honestly, and it removes one variable from
  the always-important connect/LIST moment. It just isn't a bug fix.

  Switching files: audioCallback() runs on a hardware interrupt totally
  independent of loop(), so swapping the WavReader/ring buffer/resampler
  state under it isn't safe to do casually. loadFile() below validates
  a candidate file completely (into a throwaway WavReader) before
  touching anything shared - a bad PLAY: request never disturbs whatever
  is already playing - then masks just the audio timer's own interrupt
  vector (FspTimer::disable_overflow_irq(), confirmed to touch nothing
  but that one NVIC vector) for the brief swap, rather than a checked
  flag the ISR has to branch around. The DAC output freezes for that
  handful of milliseconds - a deliberate, acceptable click on switch,
  not a bug.

  How to test: bring this up in stages rather than expecting it to work
  end-to-end on the first try.
    1. Flash the stock Storage/examples/TestSDCARD sketch from the core
       first, unmodified, to confirm the card mounts and lists files at
       all before any of this sketch's code is involved.
    2. With this sketch, confirm the board boots silent and idle - it no
       longer auto-loads anything at boot (see "BLE control" below for
       why); it just sits there doing no SD reads at all until a BLE
       PLAY: command picks a file. A WAV file not being exactly 48000Hz
       already means the resampler is doing real, non-trivial
       interpolation from the very first sample, even before the knob
       is touched.
    3. Turn the pot slowly across its full range once a file is playing;
       confirm smooth, continuous pitch/tempo tracking with no
       zippering or clicks, symmetric behavior above/below 1x forward,
       and that touching the pad switches between fast/coarse and
       slow/fine sweep rates.
    4. Turn the pot slowly through the middle of its range - confirm the
       speed slows smoothly right down to a standstill, with no jump to
       silence, and that continuing past it carries on smoothly in
       reverse, from the same place in the file, with no gap or glitch. Then spin the pot past either
       physical extreme - confirm an instant speed/direction hop there
       (not a slow fold-back through the range) - that seam is the only
       place a discontinuity is expected.
    5. Cue a file and watch Serial: "Cache: building ... copies" then
       "ready ... built in Nms". While it builds, speed is capped; once
       it's ready, push the ratio hard in both directions, all the way
       to 1024x - underrunTicks should stay at zero, and "Switched to
       copy N" lines should appear as the speed passes each power of two.
       Listen at those moments for anything untoward.
       Then reboot and confirm the copies are reused ("building" doesn't
       appear again), and delete the card's cache/ folder from a computer
       to confirm it's rebuilt.
    6. Open web/wav-remote.html, connect, confirm LIST populates real
       filenames from the card, PLAY: on a supported file switches
       cleanly, and PLAY: on anything else (a stereo file, say) returns a
       clean ERR: instead of hanging. Play each of the
       make_format_test_wavs.py files at 1x and confirm they all sound
       the same - the same notes, at the same tempo - and that the stereo
       ones (t2_...) are an octave lower in the right ear.
    7. With the transport stopped (pad released), twist the second pot
       back and forth - confirm it sounds like manually scrubbing tape
       (pitch and direction tracking the twist, silent when you stop), and
       that a knob left alone makes no sound at all. Serial says how much
       of the file one turn covers ("Scrub: one turn = ..."); turn that
       many turns and confirm you land back on the same sound. Then play
       at some steady speed and twist it again: it takes over completely,
       and playback carries on from where you left the tape once the knob
       has been still for a moment.
    8. Confirm relative control: with the first pot sitting anywhere at
       all, load a file that has never been played and confirm playback
       starts at native (1.0x) speed regardless of the pot's physical
       position. Then turn the pot a small amount
       and confirm speed changes by a correspondingly small amount from
       wherever it just was - not by jumping to whatever an absolute
       mapping of the pot's new position would imply.
    9. From the page: play a file with its play button and confirm it
       latches (steady STAT LED, keeps playing with no pad touched), and
       that Stop releases it; the status line says which, with the file's
       name. On the Tweaks tab, tap each mode's card and confirm the RGB
       LED changes colour to match, then step the mode with D20 and
       confirm the page's highlight follows. Drag each slider and confirm
       you hear it (and that Speed bends the pitch where Stretch doesn't);
       turn a knob and confirm its slider follows. Tap a value, type a
       number, and confirm it's set. Reset all tweaks (two taps) puts
       everything back.
    10. Upload a short WAV, then upload it again to confirm the overwrite
       prompt, rename it, and delete it - each time checking the list
       updates. Repeat the overwrite, rename and delete on the file that is
       playing, and cancel an upload halfway to confirm the old file
       survives. Watch the underrun count while uploading during playback.
       Check the card's cache/ folder follows along: the renamed file's
       folder renamed, the deleted file's gone, and the overwritten
       file's copies rebuilt (Serial says so) the next time it's cued.
    11. Knob calibration: send RECAL, then reset the board. Serial says
       neither knob has a saved calibration, and neither knob does
       anything yet. Turn each about two full turns until it responds,
       then play and stop - Serial reports each calibration saved. Reset
       again: Serial says both were loaded, and the knobs respond at once.
       CAL shows the saved ranges alongside the live ones.
    12. Per-file settings: set a file's speed and pitch with the knobs,
       wait two seconds (Serial says "Settings saved"), pick another file
       and then the first again - its speed and pitch come back. Reboot:
       the same file is cued, with the same settings. In pitch mode, turn
       knob 1 and confirm pitch carries on from the restored value rather
       than jumping back to unshifted.
    13. Time-stretch: play a file, switch to pitch mode (D20), and turn
       knob 2 - the tempo changes and the pitch doesn't. Through zero it
       freezes into a granular drone, and past it plays backward, still at
       the same pitch. Turn knob 1 meanwhile: pitch moves, tempo doesn't,
       at two octaves per turn from wherever it is - even at hundreds of
       times real speed, where the pitch you hear starts octaves up.
       Switch back to speed mode: nothing changes until a knob is turned.
    14. Start and end points: latch a file playing, press D20 until the LED
       is purple, and turn knob 2 - the loop gets shorter from its end.
       Turn knob 1 - it gets shorter from its start. Push either end into
       the other and the 20ms window slides along the file as a buzz.
       None of it should click or drop out beyond the loop's own seam, and
       the underrun count should stay put. Serial prints the window on
       entering the mode; WINDOW:1,2 sets one exactly and RESET:WINDOW
       gives the whole file back. Tap D21 unlatched: it plays from the
       window's start each time. In speed mode the scrub stays inside the
       window. Pick another file and come back, or reboot: the window is
       restored.
    15. Selecting with the knobs: tap D20 - the mode steps on as the finger
       lifts. Hold D20 alone and turn knob 1 - the LED steps through the
       mode colours, one every 60 degrees, forward and back, and letting go
       doesn't step it again. Still holding it, turn knob 2 - each 30
       degrees cues the next or previous WAV on the card and plays it
       (Serial says "Loaded"). Holding D20 without turning plays nothing.
       Release it: playback stops, and both knobs do their jobs in the mode
       shown, with no jump. Latch the transport first and do the same: the
       file picked keeps playing after D20 is released.
    16. Echo: latch a file playing, press D20 until the LED is pink, and
       turn knob 2 forward - echoes appear and, further round, take longer
       to die away, without ever building up. Turn knob 1: the echoes move
       apart or together, bending in pitch as they go. All the way back on
       knob 1 they close up into a metallic ring. Stop the transport: the
       echoes keep repeating as they fade smoothly away over three delay
       times, and the output doesn't thump or stick. Back in speed mode,
       scrub the stopped tape with knob 2: it echoes in full, and when the
       knob comes to rest the echoes fade away the same way.
       ECHO:0.5,0.6 sets one exactly (Serial prints it, and the status line
       shows it) and RESET:ECHO turns it off. The "isr" figures on the
       status line should be only a few percent higher than before. Pick
       another file and come back, or reboot: the echo is restored.
    17. Reset: change the speed, pitch, window, echo and filter of a test file,
       then tap both pads together three times, about as fast as knocking
       on a door. The RGB LED flashes white, Serial prints "Reset: ...",
       the file plays as it did when new, and the transport is latched.
       Then confirm what doesn't reset: two taps; three slow ones (a
       second apart); three presses each held for a second; and a chord
       held while the other hand does anything at all. RESET:ALL does the
       same from Serial.
    18. Filter: latch a file playing, press D20 until the LED is orange,
       and turn knob 1 a quarter turn either way - the bass and treble go,
       leaving a band around 640Hz (PINK.WAV, from tools/make_test_wav.py
       --pink, makes it easiest to hear). Turn knob 2 either way and the
       band moves; the width the page shows doesn't change. Turn knob 2 two
       turns either way and the sound fades away to nothing; bring it back
       to 640Hz (RESET:FILTER, or tap Centre's reset on the page). Keep turning
       knob 1 the same way: the band rings, then screams by itself, and knob
       2 plays the scream's pitch.
       Stop the transport: the scream fades away over three
       echo delay times (with the echo off, its delay is still set: 0.3
       seconds by default, so about a second); play again and it comes
       back. Turn knob 1 back until it stops at wide open and the sound is
       untouched, wherever knob 2 is. FILTER:500,1000 sets one exactly and RESET:FILTER opens
       it again; the "isr" figures
       rise about 12% while the filter is narrowed, and drop back a moment
       after it's wide open. Pick another file and come back, or reboot:
       the filter is restored.
    19. USB disk mode: with the board's USB cable in a computer, tap "USB
       disk" on the web page's Files tab (or type DISK:ON in the Serial
       Monitor). Playback stops, the LED goes a dim white, and within a
       few seconds the card appears as a drive. Copy a WAV onto it and
       eject it: the LED comes back in the mode's colour, the remembered
       file is cued again, and the new WAV is in the page's file list
       (but no "._" twin of it). Do it again and unplug the cable instead
       of ejecting: about two seconds later the board comes back the
       same way. DISK:ON with no
       computer on the USB port is refused.
    20. Sets: make a TEST folder on the card with a few short WAVs in it
       (tools/make_test_wav.py --sine 440 --seconds 3, --pink --seconds 4
       and so on). The page's set picker lists it, and the default set if
       there are WAVs at the root. On the Set tab, set the gap to 2 and
       Start setlist: each file plays once and stops dead at its end, with no
       blip of its start; the panel counts the gap down, and the next file
       starts by itself. Release nothing and touch nothing: after the last
       file the setlist turns off. Start it again and press Next mid-file: the next
       one starts at once. Stop a file partway with D21 (press it once to
       clear the deck's latch, and lift): the gap counts down from there.
       Keep a finger on a pad: the count waits, and starts over when you
       let go. Chord D20+D21 mid-file: it loops on past its end (the
       panel says Deck looping); press D21
       and lift, and the gap counts down to the next. In the
       gap, press D21: the file that ended plays again. Set SPEED:-1 on one
       and start the setlist from there: it plays once backward, end to start.
       Prepare builds every file's copies while PREP: counts up; then each
       one plays at 1000x straight away.
*/

#include <RV112FF.h>
#include <MultiTurnKnob.h>
#include <RA6M5AnalogTuning.h>
#include <RA6M5CapTouch.h>
#include <FastLED.h>
#include <codelessBLEPeripheral.h>
#include <EEPROM.h>       // the Data Flash, for saving the knobs' calibration
#include <RA6M5FastSD.h>  // the core's SD driver, but reading and writing many sectors per command
#include "FATFileSystem.h"
#include "UsbMsd.h"
#include "tusb.h"  // tud_mounted(), tud_suspended()
#include "UsbDiskGate.h"
#include "bsp_api.h"   // for R_DAC - the audio ISR writes it directly, same as DACAudioTest
#include "FspTimer.h"  // for the audio-rate interrupt driving that ISR
#include "RingBuffer.h"
#include "Resampler.h"
#include "WavReader.h"
#include "MipCache.h"
#include "FileSettings.h"
#include "Voice.h"
#include "SincInterpolator.h"
#include "EchoDelay.h"
#include "BandFilter.h"
#include "WavList.h"  // the card's WAVs, in the order the page and the file knob share
#include "FuelGauge.h"  // the board's MAX17048, for the battery readout
#include <utility>  // for std::move in loadFile()

// -- Speed range and knob mapping ----------------------------------------
// The speed dial: a virtual dial the speed knob turns (see "Relative speed
// control" in the header comment), running from +MAX_RATIO at one end,
// smoothly through zero (stopped) in the middle, to -MAX_RATIO (full speed
// backward) at the other. It's a loop - turning on past either end hops
// straight to the other - which is the only discontinuity anywhere on it.
// Positions on it are measured in degrees of knob rotation out from the
// middle: positive forward, negative backward.

const float MAX_RATIO = 1024.0f;  // magnitude at both extremes - enough to sweep a 20Hz tone up
                                  // past 20kHz, which the cached copies make possible (MipCache.h)

// The curve has two pieces, meeting at 1x.
//
// Above 1x the speed doubles every SPEED_DEGREES_PER_DOUBLING of rotation:
// from 1x, half a turn reaches 2x, a turn 4x, two turns 16x, and five turns
// MAX_RATIO. It used to climb about three and a half times as steeply
// (roughly 7 octaves a turn, so one turn from 1x was already about 140x),
// which was confirmed live to be too twitchy at high speeds.
//
// Below 1x: ratio = SPEED_CURVE_R0 * (e^(SPEED_CURVE_K * degrees) - 1).
// Mostly exponential - a linear version was tried and confirmed live to
// feel too twitchy below 1x, since a linear mapping spends the same
// rotation on every equal-sized ratio step, leaving only a sliver of the
// knob's travel for everything under 1x. An exponential spends equal
// rotation on equal *ratios* instead, which is what fine control at low
// speed needs.
//
// But a pure exponential never reaches zero, which is why this used to need
// a dead band in the middle: a flat "paused" stretch filling the gap between
// -0.1x and +0.1x, with a jump from 0 straight to 0.1x at its edges. The
// "- 1" fixes that: near the middle the curve flattens into a straight line
// through zero, so the speed slows smoothly through 0.05x, 0.01x, 0.001x...
// to exactly 0 in the middle and on into reverse, with no jump anywhere.
// (Stopping outright is the transport's job now - release the touch pad.)
// SPEED_CURVE_K sets how sharply it bends (it's the value an older,
// single-curve dial used, kept because it felt right); SPEED_CURVE_R0 is
// whatever puts 1x at NATIVE_SPEED_DEGREES, worked out by initSpeedCurve().
const float NATIVE_SPEED_DEGREES = 194.4f;       // how far out from the middle 1x sits
const float SPEED_DEGREES_PER_DOUBLING = 180.0f;
const float SPEED_CURVE_K = 0.01303f;            // per degree
float SPEED_CURVE_R0 = 1.0f;
// How far out from the middle each end of the dial is, also worked out by
// initSpeedCurve(): 194.4 + 10 doublings * 180 = 1994.4 degrees, about 5.5
// turns.
float speedDialEndDegrees = 1.0f;

void initSpeedCurve() {
  SPEED_CURVE_R0 = 1.0f / (expf(SPEED_CURVE_K * NATIVE_SPEED_DEGREES) - 1.0f);
  speedDialEndDegrees = NATIVE_SPEED_DEGREES + log2f(MAX_RATIO) * SPEED_DEGREES_PER_DOUBLING;
}

// The speed at a position on the dial, in degrees from the middle.
float speedForDial(float degrees) {
  float d = fabsf(degrees);
  float magnitude = (d <= NATIVE_SPEED_DEGREES)
      ? SPEED_CURVE_R0 * (expf(SPEED_CURVE_K * d) - 1.0f)
      : exp2f((d - NATIVE_SPEED_DEGREES) / SPEED_DEGREES_PER_DOUBLING);
  return copysignf(fminf(magnitude, MAX_RATIO), degrees);
}

// The inverse - where a given speed lives on the dial, so the virtual knob
// below can (re-)anchor itself there: native speed on every file load, or
// whatever SPEED: asked for.
float dialForSpeed(float ratio) {
  float r = fminf(fabsf(ratio), MAX_RATIO);
  float d = (r <= 1.0f)
      ? logf(1.0f + r / SPEED_CURVE_R0) / SPEED_CURVE_K
      : NATIVE_SPEED_DEGREES + log2f(r) * SPEED_DEGREES_PER_DOUBLING;
  return copysignf(d, ratio);
}

// The virtual knob below keeps an unbounded running total of degrees turned;
// this folds that onto the dial's loop. A total of 0 is the +MAX_RATIO end,
// and turning the knob up (a growing total) lowers the speed - confirmed
// live that the opposite sense spun the wrong way.
float dialForKnob(float knobDegrees) {
  float loop = 2.0f * speedDialEndDegrees;
  float wrapped = fmodf(knobDegrees, loop);
  if (wrapped < 0) wrapped += loop;
  return speedDialEndDegrees - wrapped;
}

// The knob total that puts the dial at a given speed.
float knobForSpeed(float ratio) {
  return speedDialEndDegrees - dialForSpeed(ratio);
}

// The pitch knob is relative, like the speed and scrub knobs: each turn
// moves the pitch you hear by PITCH_OCTAVES_PER_TURN octaves from wherever
// it is, in whatever range. It used to be a dial covering 5 octaves either
// side of the file's own pitch, at one octave per turn - but at high speeds
// the pitch you hear is far outside that (200x is 7.6 octaves up), so the
// dial anchored at its end, snapped there on the first turn, and took many
// turns to come back.
const float PITCH_OCTAVES_PER_TURN = 2.0f;

// How far the pitch you hear can go, either way, in octaves from the file's
// own - as far as the speed dial goes (1024x is 10 octaves). Nothing in the
// signal path limits it: both grain taps trail the cursor by at most a
// grain, whatever the pitch, so the buffer, the card and the CPU don't care.
// What changes is the character: shifting far up moves most of the sound
// above hearing (the copy is chosen to suit the grains' rate, so it's
// filtered out rather than aliased - see levelRateFor()), and as the shift
// grows the grains splice faster, until the crossfade seam is audible and
// it behaves like a ring modulator. That's a musical effect rather than a
// malfunction, so the limit is taste.
const float PITCH_OCTAVE_LIMIT = 10.0f;

// -- Relative ("virtual knob") speed control -------------------------------
// The physical knob is absolute (its position directly maps to a
// point on the dial) but the speed control is relative: pot1's
// MOVEMENT, not its position, is what moves a separate virtual dial
// position - speedKnobDegrees below - through the speed dial above.
// This means the real knob's physical position at any moment is
// meaningless on its own; only how far it's turned since the last tick
// matters. speedKnobAnchored tracks "no baseline yet" explicitly,
// rather than reading it off lastPhysicalKnobDegrees - unlike a
// single-turn [0,360) reading, MultiTurnKnob::read()'s accumulated
// multi-turn position legitimately goes negative during perfectly
// ordinary counterclockwise turns, so no value of it can mean "none yet"
// (a real bug caught on the bench: testing its sign silently froze the
// ratio the moment the accumulator crossed zero). "No baseline yet" is true at boot
// before pot1 first calibrates, and again briefly after every
// resetVirtualKnobToNative() call (see loadFile()), which is what makes
// native speed on every fresh sample and at boot come for free: the
// control-rate block below establishes the virtual knob fresh, right at
// the ratio-1.0 point, the moment it next finds no baseline to diff
// against.
// One virtual knob per mode, so switching between speed and pitch leaves
// each setting exactly where it was. lastPhysicalKnobDegrees is shared and
// updated every tick regardless of mode, which is what makes a mode switch
// seamless: the first delta after switching is measured from the knob's
// position now, not from wherever it was when this mode was last active, so
// nothing jumps.
float speedKnobDegrees = 0.0f;
bool speedKnobAnchored = false;
// In pitch mode, the pitch you hear (relative to the file's own), which
// knob1 sets and knob2's time-stretch holds steady - see "Time-stretch" in
// the header comment. Kept in step with pitchRatio and the speed by
// holdPitch() and syncHeldPitch().
float heldPitch = 1.0f;
float lastPhysicalKnobDegrees = 0.0f;

// knob1's position after a small backlash - see the control-rate block.
float knob1Degrees = 0.0f;
const float KNOB1_BACKLASH_DEGREES = 0.3f;

// The ratio the speed knob re-anchors at the next time it finds no
// baseline - native speed, except after a SPEED: command picks another.
float speedAnchorRatio = 1.0f;

// Doesn't touch speedKnobDegrees directly - just clears the baseline
// so the control-rate block re-anchors it at native speed on its very
// next tick. Safe to call from anywhere, at any time.
void resetVirtualKnobToNative() {
  // Speed only. Pitch deliberately survives a file change: it is a setting
  // the player has dialled in, not a property of the file.
  speedAnchorRatio = 1.0f;
  speedKnobAnchored = false;
}

// -- SD card and WAV source -----------------------------------------------
// Declared at file scope, not inside setup(): FATFileSystem keeps a
// reference to the block device for as long as any file on it stays
// open, which for this sketch is the entire runtime.

// The faster drop-in for the core's SDCardBlockDevice - see RA6M5FastSD.h.
// What this sketch mostly needs it for is writing the cached copies (see
// MipCache.cpp): the core writes one sector per command, which made building
// a file's copies take about as long as the file plays.
FastSDCardBlockDevice sdBlockDevice(PIN_SDHI_CLK, PIN_SDHI_CMD, PIN_SDHI_D0, PIN_SDHI_D1,
                                    PIN_SDHI_D2, PIN_SDHI_D3, PIN_SDHI_CD, PIN_SDHI_WP);
FATFileSystem sdFs("sd");

// The card as a USB disk, behind a gate that keeps it hidden from the
// computer except in USB disk mode - see "USB disk mode" and UsbDiskGate.h.
// (The list form of USBMSD's constructor: its single-device one writes past
// the end of a zero-length array.)
UsbDiskGate usbDiskGate(sdBlockDevice);
USBMSD usbDisk({&usbDiskGate});
// Runs fixUsbDiskPacketSize() before main() starts USB - see UsbDiskGate.h.
struct UsbDiskPacketSizeFix {
  UsbDiskPacketSizeFix() { fixUsbDiskPacketSize(); }
} usbDiskPacketSizeFix;
bool usbDiskMode = false;
volatile bool usbDiskEjected = false;  // set by the USB interrupt
MipCache cache;  // builds and tracks the current file's lower-rate copies - see MipCache.h

// volatile because audioCallback() reads it - see the idle branch there.
// Only ever written by loadFile() and unloadFile(), which both disable the
// audio interrupt around the whole state swap, so no further guarding is
// needed.
volatile bool fileLoaded = false;
String currentFilename = "NONE";
float rateFactor = 1.0f;  // wav's native sample rate / 48000 - recomputed on every file load
uint32_t fileFrames = 1;  // the WAV's length in frames, at its own rate - set on every file load
uint32_t nativeRate = 0;  // the WAV's own sample rate, in Hz

// The window: the stretch of the file that plays, round and round, in
// frames of the WAV - the whole file unless mode 3's knobs have moved its
// ends. See "The window" further down. Fractional, so that slow turns of a
// knob add up.
double windowStart = 0.0;
double windowEnd = 1.0;  // one past the last frame played
uint8_t fileChannels = 1; // 1 for mono, 2 for stereo

// -- Playback voices ----------------------------------------------------------
// A voice plays one copy of the current file - the WAV itself, or one of the
// filtered, lower-rate copies MipCache keeps on the card - through its own
// ring buffer, at its own position. Only one ever plays. When the speed moves
// far enough that a different copy would serve better, the idle voice is
// opened on that copy and primed at the matching position while the active
// one keeps playing, and then the two simply swap - see chooseLevel() and
// startLevelChange().
//
// The swap is a hard cut, no crossfade. It used to be a 20ms crossfade, back
// when each copy was read in a way that aliased just below a change and not
// just above it, so the change was audible and needed smoothing over. Now
// both sides of a change are filtered the same way (SincInterpolator.h), and
// measured on the board the two copies differ by -60dB or less at the
// moment of a change - and no artifact was audible with a hard cut on pure
// tones, a bright sawtooth, a sine sweep or a drum loop. Dropping the fade
// means the audio interrupt only ever renders one voice, which roughly
// halves its worst case.
//
// Positions are kept per voice, in that voice's own copy's samples rather
// than the original file's. That's not just tidiness: at 1000x, a position
// counted in the original file's samples would overflow a 32-bit counter in
// under a minute, but a voice only ever steps through its own copy at
// around one sample per tick, so its counter lasts for hours.

// The Voice struct itself lives in Voice.h - only so Arduino's automatic
// function prototypes, which land near the top of this file, can name it.
const size_t CHUNK_FRAMES = 1024;      // frames per SD read when refilling a voice

// Where each chunk lands on its way from the card into a ring buffer -
// room for a stereo chunk. Static rather than on the stack, which a 4KB
// buffer would strain; only loop() ever reads the card, one chunk at a time.
alignas(4) int16_t chunkBuffer[CHUNK_FRAMES * 2];
const int32_t REVERSAL_MARGIN = 4096;  // frames, ~93ms at 44.1kHz; must stay well under
                                       // a ring's frameCapacity()

Voice voices[2];

// Which voice is playing. loop() changes it only with interrupts masked.
volatile uint8_t activeVoice = 0;

// The step the audio interrupt is using right now, in samples of the
// original file per output tick. loop() works out a new step 100 times a
// second, at control rate. While the scrub knob is driving, the interrupt
// glides to each new step in a straight line over the next control
// interval rather than jumping: targetStep is where it's headed and
// stepSlope how far it moves each tick. Jumping made a scrub a staircase of
// tiny pitch steps a hundred times a second, heard as a warble. The glide
// costs at most one control interval (10ms, about 5ms on average) before a
// change fully arrives - noticeable as lag on the speed knob, which didn't
// warble to begin with, so its steps still jump. Set through rampStepTo()
// or setStepNow(), never directly, so the three always agree.
volatile float currentStep = 1.0f;
volatile float targetStep = 1.0f;
volatile float stepSlope = 0.0f;
const float STEP_RAMP_TICKS = 480.0f;  // one control interval, CONTROL_INTERVAL, at 48kHz
volatile int16_t lastGoodLeft = 0;   // the last frame played, held through an underrun
volatile int16_t lastGoodRight = 0;

// Rounds toward zero and clips to the 16-bit range.
AUDIO_HOT inline int16_t clampToSample(float x) {
  if (x > 32767.0f) return 32767;
  if (x < -32768.0f) return -32768;
  return (int16_t)x;
}
volatile uint32_t underrunTicks = 0;

// -- Pitch shifting -------------------------------------------------------
//
// Speed and pitch are coupled by resampling alone: play a file faster and it
// gets higher, exactly like a tape. Decoupling them needs one extra
// primitive, time-stretching, and then:
//
//   pitch shift = resample by r  +  time-stretch by 1/r
//   speed change = time-stretch alone
//
// The resampler already does the first half. What is added here is the
// second: a two-tap crossfading granular shifter, the cheapest useful
// time-stretcher there is. No FFT, no correlation search - the read position
// is simply held at a slowly-ramping offset behind the nominal playback
// position, and when that offset has ramped a whole grain it wraps, with a
// second tap half a grain out of phase crossfading over the seam.
//
// Effective read rate = speed * pitchRatio, while the nominal position (and
// so the duration, and so everything the SD refill is built around) still
// advances at speed alone. Concretely, with offset o and nominal rate v:
//
//   d(read)/dt = v - d(o)/dt  ==>  d(o)/dt = (1 - pitchRatio) * |v|
//
// Both taps therefore read *behind* the nominal position in the direction of
// travel, never ahead, whichever way the tape is running - which matters,
// because it means the shifter needs history the ring buffer already keeps
// (REVERSAL_MARGIN) and no lookahead the refill would have to be taught.
//
// The artifact is a periodic warble, worst on sustained tones, getting more
// obvious the further pitchRatio is from 1. That is the price of skipping
// the correlation search; WSOLA is the upgrade path if it grates.
const float PITCH_MIN_RATIO = 0.5f;   // one octave down
const float PITCH_MAX_RATIO = 2.0f;   // one octave up

// Grain length, in source samples. ~46ms at 44.1kHz: long enough that the
// grain rate stays below the audible range at moderate shifts, short enough
// to avoid obvious flanging. MUST stay well under REVERSAL_MARGIN (4096 in
// loop()), since that is what guarantees the samples a tap reaches back for
// are still in the ring.
const float GRAIN_LENGTH_SAMPLES = 2048.0f;

// Below this distance from unity the shifter is bypassed entirely and the
// single-tap path runs instead. Not just an optimisation: with the offset
// ramp stopped, the two taps sit at fixed different delays and sum into a
// comb filter, so unity pitch has to be a special case rather than a limit.
const float PITCH_BYPASS_EPSILON = 0.001f;

// The shifter doesn't switch in and out of that bypass instantly: the grains
// trail the cursor while the single tap reads right at it, so an instant
// switch jumps the sound back or forward by up to a grain - a glitch heard
// every time a time-stretch passed through the held pitch (1x, unless the
// pitch knob has moved it). shiftMix glides between the two over
// SHIFT_FADE_TICKS instead - 0 the single tap, 1 the grains - reading both
// only while it's in between.
const float SHIFT_FADE_TICKS = 480.0f;  // 10ms at 48kHz
float shiftMix = 0.0f;                  // ISR-owned

volatile float pitchRatio = 1.0f;   // written by loop(), read by the audio ISR

// For time-stretch: when zero or more, the grains read at exactly this many
// source samples per tick - a fixed pitch - whatever the step is, instead
// of at pitchRatio times the step. -1 when not time-stretching. Written by
// loop() each control tick.
volatile float grainTapRate = -1.0f;
volatile float grainOffset = 0.0f;  // ISR-owned; source samples behind nominal

// Hann window, precomputed. At 50% overlap two Hann windows sum to exactly
// 1.0, so the crossfade is unity-gain with no correction term - and each tap
// is silent exactly where its own grain wraps, which is what hides the seam.
const uint16_t HANN_LUT_SIZE = 512;  // power of two, so the index masks
float hannLut[HANN_LUT_SIZE];

inline float hannAt(float phase01) {
  uint16_t i = (uint16_t)(phase01 * (float)HANN_LUT_SIZE) & (HANN_LUT_SIZE - 1);
  return hannLut[i];
}

// Which knob mode is selected: a row of MODES - see "Knob modes". Advanced
// by touch1 (pressed on its own - chorded with touch2 it latches the
// transport instead).
uint8_t knobMode = 0;

// Transport state, as of the last control tick. Only loop() touches it -
// the audio ISR has no opinion about it, since stopping is expressed purely
// as a step of zero. Reported over BLE as RUN: so the web page can show it.
bool transportRunning = false;

// Latched transport. Set by pressing touch1 while touch2 is held (or by a
// BLE LATCH: command), cleared by the next press of touch2 (or BLE STOP) -
// at which point playback carries on uninterrupted if touch2 is what cleared
// it, because that same press is also holding the transport up. So the latch
// is engaged and released without playback ever stopping, which is the point.
bool transportLatched = false;

// The setlist - see "Sets". While setlistOn, each track plays once, from
// one end of its window to the other, and then the deck stops; and
// whenever the deck has been stopped and left alone for the set's gap, the
// next one starts. loop() arms stopAtTrackEnd whenever
// the tape is running under the transport (not scrubbed), and the audio
// interrupt stops it right at the window's edge and says so in
// reachedTrackEnd - not loop(), which only looks every CONTROL_INTERVAL and
// would hear the start of the track again first.
bool setlistOn = false;
volatile bool stopAtTrackEnd = false;
volatile bool reachedTrackEnd = false;
bool trackEnded = false;          // the track played out, and stays stopped
bool looping = false;             // latched by hand: loops until stopped, then the gap
unsigned long gapStartMillis = 0;
bool gapCounting = false;
float setGapSeconds = FileSettings::DEFAULT_GAP_SECONDS;  // the current file's set's gap
String gapSet = "-";              // which set that was loaded for ("-": none yet)

// The knob-requested ratio as of the last control-rate tick, kept
// outside that block too: loadFile() runs on its own schedule (whenever
// a BLE PLAY: command arrives, not at CONTROL_INTERVAL), and needs this
// to recompute currentStep for the newly-loaded file's rateFactor
// without waiting for the next knob tick.
float lastKnownRatio = 1.0f;

// Diagnostic only: the min/max ratio actually computed at control rate
// since the last status print, to check whether currentStep is
// spiking between prints (which only show a single 500ms snapshot) or
// whether the buffer wobble seen at "steady" knob positions has some
// other cause entirely.
float minRatioSeen = 1e9f;
float maxRatioSeen = -1e9f;

// -- Audio-rate interrupt ---------------------------------------------

FspTimer audioTimer;

// The interpolation kernel's lookup table - see SincInterpolator.h.
float sincTable[SINC_TABLE_LEN];

// The fastest read the kernel stretches itself to filter properly for, in
// samples per tick. Normal playback never reads a copy much faster than
// LEVEL_UP_STEP (2), but for the few milliseconds after a sudden jump in
// speed, before the right copy has faded in, it can be asked for up to
// MAX_VOICE_RATE; past this it aliases rather than grow ever more taps
// and run the audio interrupt out of time.
const float MAX_KERNEL_STRETCH = 3.0f;

// The fastest a voice is allowed to step through its copy - see the comment
// where it's applied in audioCallback().
const float MAX_VOICE_RATE = 8.0f;

// The bandwidth to read at when moving through a copy at `samplesPerTick`:
// the full band at or below one sample per tick, 1/s of it above - see
// SincInterpolator.h for why.
AUDIO_HOT inline float bandwidthFor(float samplesPerTick) {
  float s = __builtin_fabsf(samplesPerTick);
  if (s <= 1.0f) return 1.0f;
  if (s >= MAX_KERNEL_STRETCH) return 1.0f / MAX_KERNEL_STRETCH;
  return 1.0f / s;
}

// Reads one interpolated frame from a voice - out[0] left, out[1] right,
// the same for mono - at whole frame idx plus fraction frac of its copy,
// plus an offset in frames (which may be fractional or negative). Kept as a
// whole/fraction pair rather than one float position, since a float can't
// hold a large frame index exactly.
AUDIO_HOT inline bool readAt(Voice &v, int32_t idx, float frac, float offset, float bandwidth,
                             float out[2]) {
  float rel = frac + offset;
  float whole = __builtin_floorf(rel);
  return readSinc(v.ring, idx + (int32_t)whole, rel - whole, bandwidth, out);
}

// Two-tap granular read - see the pitch shifting comment above for the
// derivation. Both taps sit behind the nominal position in the direction of
// travel; their Hann envelopes are driven by the same ramp that moves them,
// so each tap is silent exactly where its own grain wraps. grainOffset is
// counted in the original file's samples, so it's scaled into this voice's
// copy - which keeps the grains in step when playback moves to another copy.
AUDIO_HOT inline bool readGrains(Voice &v, int32_t idx, float frac, float step, float bandwidth,
                                 float out[2]) {
  float dir = (step < 0.0f) ? -1.0f : 1.0f;

  float offsetA = grainOffset;
  float offsetB = offsetA + GRAIN_LENGTH_SAMPLES * 0.5f;
  if (offsetB >= GRAIN_LENGTH_SAMPLES) offsetB -= GRAIN_LENGTH_SAMPLES;

  float a[2], b[2];
  if (!readAt(v, idx, frac, -dir * offsetA * v.levelScale, bandwidth, a)) return false;
  if (!readAt(v, idx, frac, -dir * offsetB * v.levelScale, bandwidth, b)) return false;

  float gainA = hannAt(offsetA / GRAIN_LENGTH_SAMPLES);
  float gainB = hannAt(offsetB / GRAIN_LENGTH_SAMPLES);
  out[0] = a[0] * gainA + b[0] * gainB;
  out[1] = a[1] * gainA + b[1] * gainB;
  return true;
}

// One voice's output for this tick: the single tap, the pitch shifter's
// grains, or a blend of the two by `mix` while gliding between them (see
// shiftMix).
//
// The pitch shifter's grain taps move through the copy at speed x pitch,
// but they're read at full bandwidth regardless. The copy is chosen to keep
// that rate under about 2 samples per tick (see levelRateFor()), so only
// the top octave can alias, between 1 and 2. Band-limiting them properly
// would mean two stretched-kernel reads a tick, each up to twice the cost of
// an ordinary one - and the audio interrupt's budget is being kept free for
// other processing. The shifter is a lo-fi effect with its own warble anyway.
AUDIO_HOT inline bool renderVoice(Voice &v, float step, float mix, float out[2]) {
  int32_t idx = v.resampler.index;
  float frac = v.resampler.frac;
  float rate = step * v.levelScale;  // samples of this copy per tick
  if (mix <= 0.0f) return readAt(v, idx, frac, 0.0f, bandwidthFor(rate), out);

  // A tap can reach past the start of the buffer in the moments right
  // after a rewind, when there is little history behind position 0 yet.
  // Falling back to the unpitched read costs a brief pitch glitch there
  // and nothing else, which beats reporting an underrun that isn't one.
  if (!readGrains(v, idx, frac, step, 1.0f, out)) {
    return readAt(v, idx, frac, 0.0f, bandwidthFor(rate), out);
  }
  if (mix >= 1.0f) return true;

  float plain[2];
  if (!readAt(v, idx, frac, 0.0f, bandwidthFor(rate), plain)) return true;
  out[0] = plain[0] + mix * (out[0] - plain[0]);
  out[1] = plain[1] + mix * (out[1] - plain[1]);
  return true;
}

// -- Echo --------------------------------------------------------------------
// A feedback echo on the output, set by the fourth knob mode - see
// EchoDelay.h for how it works and why it sounds as it does. It runs in the
// audio interrupt on every tick, whatever the mode and whether or not
// anything is playing. With the amount at zero, as it is until that knob is
// turned, it adds nothing to the sound.
//
// When the sound stops, the tail doesn't ring on for ever: loop() fades it
// out (EchoDelay's setFade()) over a few delay times (ECHO_TAIL_REPEATS) -
// long enough for the last thing played to come round that many times, each
// quieter - and then damps it (setDamped()), taking the feedback away. The
// fade follows (1 - t) cubed rather than a straight line: a straight line
// in level is only 30dB down at 97% of the way, and drops to nothing over
// the last 3% - which is heard as a cut. The cube is 60dB down by 90% and
// arrives at nothing gently. "The sound" is the transport running, or the scrub
// knob moving a stopped tape; the fade starts when the transport stops or
// that knob comes to rest. A very short delay still gets
// ECHO_TAIL_MIN_SECONDS, so a stop is never an abrupt cut.
EchoDelay echo;
float echoSeconds = 0.3f;  // the delay time; loop()'s copy of what `echo` was told
float echoAmount = 0.0f;   // level and feedback, 0 (off) to ECHO_MAX_AMOUNT
const float ECHO_TAIL_REPEATS = 3.0f;
const float ECHO_TAIL_MIN_SECONDS = 0.5f;
bool echoTailing = false;            // whether the echo is fading out after the sound...
unsigned long soundStoppedMillis = 0;  // ...and when that sound was last heard

// The delay knob is relative and exponential, like the pitch knob: a turn
// multiplies or divides the delay by 2 to the power of this, wherever it
// is. All the way from ECHO_MIN_SECONDS to ECHO_MAX_SECONDS is a little
// under four turns.
const float ECHO_OCTAVES_PER_TURN = 3.0f;
// The amount knob goes from nothing to ECHO_MAX_AMOUNT in this many turns.
const float ECHO_AMOUNT_TURNS = 1.0f;

// -- Filter ------------------------------------------------------------------
// A resonant band-pass filter, set by the fifth knob mode - see BandFilter.h
// for how it works and how it's played. It runs in the audio interrupt just
// before the echo, so the echoes are of the filtered sound. Wide open, as it
// is until a knob is turned, it's out of the circuit and costs nothing.
//
// Narrowed far enough it oscillates by itself, and an oscillating filter
// would carry on screaming when the sound stops - hard to silence for anyone
// not in filter mode. So loop() fades it out along with the echo's tail,
// over a few echo delay times - see "Echo". Playing again brings the scream
// back.
//
// How the knobs play it was settled by trying the alternatives on the bench:
//   - Width and centre, not bottom and top. The first version had one knob
//     per cutoff, as the MiniKorg 700's Traveler does, each pushing the
//     other along where they met. Width on knob1 and centre on knob2 plays
//     better: one knob for how much you hear, one for where - and with the
//     band narrowed to a scream, the centre knob plays its pitch.
//   - Two shelves with a space between. The band is half its width either
//     side of the centre, and the centre slides both edges together. The
//     width is a setting of its own, kept as set, shown as set and saved as
//     set - even when the centre has pushed an edge out of hearing. Tried
//     and dropped: showing the band's real width once an edge had stopped
//     at the end of the range (the reading changed under the centre knob,
//     which was confusing), and having each edge cover the same fraction
//     of the way to its end (the band went lopsided round the centre).
//   - The width knob is the top of a hill at wide open, closing either way
//     and stopping there on the way back - so wide open is always one easy
//     place to find, whichever way the knob was turned last. And it's on a
//     squared curve: in a straight line it took most of a turn before
//     narrowing could be heard, where now a quarter turn does it.
//   - The centre goes far past hearing both ways, on a curve, so even the
//     widest band can be slid right out of hearing to silence. A digital
//     filter can't put a cutoff out there; the filter fades the sound as
//     its own slope would instead - see BandFilter.h. In the middle the
//     curve keeps the plain five octaves a turn, for playing the scream.
BandFilter filter;
float filterLowHz = FILTER_MIN_HZ;   // the band's bottom; loop()'s copy of what `filter` was told
float filterHighHz = FILTER_MAX_HZ;  // and its top: both at the ends is wide open, no filter

// The knobs play the band by its centre and width - see setFilterBand().
// The centre starts in the middle of the range, in octaves: 640Hz.
const float FILTER_CENTRE_HZ = 640.0f;
float filterCentreHz = FILTER_CENTRE_HZ;
float filterWidthOctaves = FILTER_OPEN_OCTAVES;  // 0 to 10, and 10 is wide open

// The centre reaches this many octaves either way from FILTER_CENTRE_HZ:
// far enough that even the widest band slides out past the end of what you
// can hear, and fades away to silence - see BandFilter.h. That's from a
// fiftieth of a Hz to 21MHz, which only means anything as a place to put
// the band where it can't be heard.
const float FILTER_CENTRE_REACH_OCTAVES = 15.0f;
const float FILTER_CENTRE_LOWEST_HZ = FILTER_CENTRE_HZ / 32768.0f;   // 2^15
const float FILTER_CENTRE_HIGHEST_HZ = FILTER_CENTRE_HZ * 32768.0f;

// The centre knob is relative, on a curve: FILTER_OCTAVES_PER_TURN in the
// middle, speeding up toward the ends, so the reach takes
// FILTER_CENTRE_REACH_TURNS either way - see filterCentreOctaves().
const float FILTER_OCTAVES_PER_TURN = 5.0f;
const float FILTER_CENTRE_REACH_TURNS = 2.0f;

// The width knob runs from wide open to closed in this many turns, either
// way from open, on a curve - see turnFilterWidth().
const float FILTER_WIDTH_TURNS = 1.5f;
int8_t filterWidthSide = 1;  // which way from open the width knob was last turned

// -- Audio interrupt timing (diagnostic) -------------------------------------
// The audio interrupt should fire every 1/48000s exactly. If anything keeps
// interrupts masked for longer than a tick, a tick is skipped outright and
// the DAC holds one sample twice - a tiny click. The Serial status line
// reports how many ticks have been dropped, and how much of each tick the
// interrupt itself takes.
//
// Dropped ticks are found by counting: the interrupt counts every tick it
// runs, and loop() compares that with how many there should have been by
// now according to micros(). Timing each gap from inside the interrupt
// doesn't work here, for two reasons found the hard way: FastLED's driver
// for this chip zeroes the CPU's cycle counter on every LED update, and
// micros() itself depends on a lower-priority interrupt, so read from
// inside this one it occasionally jumps by a millisecond. (The interrupt's
// own run time is still safe on the cycle counter - nothing can reset it
// partway through an interrupt.)
uint32_t cyclesPerTick = 0;          // set in setup()
volatile uint32_t audioTicks = 0;    // every tick the interrupt has run
uint32_t dropCountTicks = 0;         // audioTicks when counting (re)started
uint32_t dropCountMicros = 0;        // micros() then
uint64_t dropCountElapsed = 0;       // microseconds counted since
uint32_t dropCountLastMicros = 0;
// The timer's real rate is its clock divided by a whole number of counts
// per tick - about 48008Hz rather than exactly 48000 - which is enough to
// look like 8 ticks a second going missing, so the count uses the real one.
uint64_t tickClockHz = 48000;        // set in setup(), from the timer itself
uint64_t tickClockCountsPerTick = 1;

// Starts counting dropped ticks afresh - after loading a file or rewinding,
// which pause the audio on purpose and so would swamp the count.
void restartDropCount() {
  dropCountTicks = audioTicks;
  dropCountMicros = dropCountLastMicros = micros();
  dropCountElapsed = 0;
}

// Ticks that should have run since restartDropCount() but didn't.
int32_t droppedTicks() {
  uint32_t now = micros();
  dropCountElapsed += (uint32_t)(now - dropCountLastMicros);
  dropCountLastMicros = now;
  uint32_t expected =
      (uint32_t)(dropCountElapsed * tickClockHz / (tickClockCountsPerTick * 1000000));
  return (int32_t)(expected - (audioTicks - dropCountTicks));
}
volatile uint32_t isrCyclesMax = 0;  // since the last status line
volatile uint32_t isrCyclesSum = 0;
volatile uint32_t isrCount = 0;

// Starts the audio interrupt gliding from its current step to `target`
// over the next control interval - see currentStep.
void rampStepTo(float target) {
  noInterrupts();
  targetStep = target;
  stepSlope = (target - currentStep) / STEP_RAMP_TICKS;
  if (stepSlope == 0.0f) currentStep = target;  // no glide would ever get there
  interrupts();
}

// Jumps straight to a step, with no glide - for the speed knob, and for a
// new file, where there's nothing to glide from.
void setStepNow(float step) {
  noInterrupts();
  currentStep = targetStep = step;
  stepSlope = 0.0f;
  interrupts();
}

// Playing a set, a track ends at the edge of its window - see setlistOn. The
// voice's position runs on round the window, lap after lap (see
// fileOffsetFor()), so crossing an edge is the lap number changing: forward
// into the next lap is the end, backward into the one before the start.
// Either way the position is put back on the edge, inside, and stopped.
AUDIO_HOT inline int32_t lapOf(const Voice &v, int32_t position) {
  int32_t length = (int32_t)v.window.length;
  int32_t from = position - v.windowBase;
  return (from >= 0) ? from / length : -((length - 1 - from) / length);
}

AUDIO_HOT inline void stopAtWindowEdge(Voice &v, int32_t before) {
  int32_t lapBefore = lapOf(v, before);
  int32_t lapAfter = lapOf(v, v.resampler.index);
  if (lapAfter == lapBefore) return;
  int32_t edge = v.windowBase + (int32_t)v.window.length * (lapAfter > lapBefore ? lapAfter : lapBefore);
  if (lapAfter > lapBefore) {
    v.resampler.index = edge - 1;  // the window's last frame...
    v.resampler.frac = 0.999f;     // ...as near its end as it goes
  } else {
    v.resampler.index = edge;      // its first
    v.resampler.frac = 0.0f;
  }
  currentStep = targetStep = 0.0f;
  stepSlope = 0.0f;
  stopAtTrackEnd = false;
  reachedTrackEnd = true;
}

AUDIO_HOT void audioCallback(timer_callback_args_t *args) {
  uint32_t tickStart = DWT->CYCCNT;
  audioTicks++;

  int16_t outLeft, outRight;

  if (!fileLoaded) {
    // Nothing loaded: idle, not starved. An underrun means the producer
    // could not keep up with the consumer, and with no file there is no
    // producer and nothing is expected - counting these would (and did)
    // bury the real measurement under 48000 phantom underruns per second
    // for as long as the board sat at the menu. Hold the output steady and
    // leave the resampler alone.
    outLeft = lastGoodLeft;
    outRight = lastGoodRight;
  } else {
    // Glide toward loop()'s latest step - see currentStep.
    float step = currentStep;
    float target = targetStep;
    if (step != target) {
      step += stepSlope;
      if ((stepSlope > 0.0f) ? (step > target) : (step < target)) step = target;
      currentStep = step;
    }
    float p = pitchRatio;
    float tapRate = grainTapRate;
    bool stretching = tapRate >= 0.0f;
    float stepSize = __builtin_fabsf(step);
    bool shifting = stretching
        ? __builtin_fabsf(tapRate - stepSize) >= PITCH_BYPASS_EPSILON * tapRate
        : __builtin_fabsf(p - 1.0f) >= PITCH_BYPASS_EPSILON;

    float mix = shiftMix;
    if (shifting ? mix < 1.0f : mix > 0.0f) {
      mix += (shifting ? 1.0f : -1.0f) / SHIFT_FADE_TICKS;
      mix = (mix > 1.0f) ? 1.0f : (mix < 0.0f) ? 0.0f : mix;
      shiftMix = mix;
    }

    Voice &active = voices[activeVoice];

    float frame[2];
    bool ok = renderVoice(active, step, mix, frame);

    if (ok) {
      outLeft = clampToSample(frame[0]);
      outRight = clampToSample(frame[1]);
      lastGoodLeft = outLeft;
      lastGoodRight = outRight;

      // Ramp the grain offset and wrap it into one grain - the wrap is the
      // splice the crossfade exists to hide. The grains trail the cursor by
      // the offset, so they read at |step| minus its rate of growth: at
      // pitchRatio times the step, or at a fixed rate when time-stretching -
      // which works even at a step of zero, where the grains keep playing in
      // place (a freeze). Kept moving while the grains fade out too.
      if (mix > 0.0f) {
        float o = grainOffset + (stretching ? stepSize - tapRate : (1.0f - p) * stepSize);
        if (o >= GRAIN_LENGTH_SAMPLES) o -= GRAIN_LENGTH_SAMPLES;
        else if (o < 0.0f) o += GRAIN_LENGTH_SAMPLES;
        grainOffset = o;
      }
      // No ring.release() anymore: the consumer no longer publishes
      // anything back through the ring buffer at all - the producer
      // (loop()) decides reclaim policy itself, based on direction. See
      // RingBuffer.h's header comment and loop()'s refill logic.
      // The voice steps through its own copy, scaled to that copy's rate -
      // but no faster than MAX_VOICE_RATE samples of it per tick. Normally a
      // voice reads its copy at no more than 2, but when the speed jumps -
      // SPEED:1000 from 1x, or a fast flick of the knob - the playing voice
      // would suddenly be asked for hundreds, and drain its ring buffer in a
      // few ticks while loop() is still preparing the right copy. So it lags
      // behind for those few milliseconds instead, and catches up when the
      // right copy takes over.
      float activeRate = step * active.levelScale;
      if (__builtin_fabsf(activeRate) > MAX_VOICE_RATE) {
        activeRate = __builtin_copysignf(MAX_VOICE_RATE, activeRate);
      }
      if (!reachedTrackEnd) {  // a track that has ended stays put until loop() notices
        int32_t before = active.resampler.index;
        active.resampler.advance(activeRate);
        if (stopAtTrackEnd) stopAtWindowEdge(active, before);
      }
    } else {
      outLeft = lastGoodLeft;  // hold the last good frame - see header comment
      outRight = lastGoodRight;
      underrunTicks++;
    }
  }

  // The filter and then the echo, last: they hear exactly what goes out,
  // including a held frame. (lastGoodLeft/Right above stay as they were,
  // without them.)
  float effected[2] = {(float)outLeft, (float)outRight};
  filter.process(effected);
  echo.process(effected);
  outLeft = clampToSample(effected[0]);
  outRight = clampToSample(effected[1]);

  // 16-bit signed -> 12-bit unsigned, same shift-based rescale used
  // throughout this pipeline for cheapness; a few LSBs of resolution
  // given up is inaudible against this DAC's own ~24-LSB absolute
  // accuracy (RA6M5 datasheet, Table 53.48). Left to DAC0 (A0, the jack's
  // tip), right to DAC1 (A1, its ring) - a mono file's frames carry the
  // same value in both.
  R_DAC->DADR[0] = (uint16_t)(((int32_t)outLeft + 32768) >> 4);
  R_DAC->DADR[1] = (uint16_t)(((int32_t)outRight + 32768) >> 4);

  uint32_t used = DWT->CYCCNT - tickStart;
  if (used > isrCyclesMax) isrCyclesMax = used;
  isrCyclesSum += used;
  isrCount++;
}

// -- File switching (BLE PLAY: command, and the boot-time default) -------

// The crossfade that joins the end of the window to its start - see "The
// window" further down. This long, though never more than a quarter of the
// window, nor than fits the buffer it's worked out in.
const float WINDOW_FADE_SECONDS = 0.005f;
const uint32_t WINDOW_FADE_MAX_FRAMES = 256;
alignas(4) int16_t fadeBuffer[WINDOW_FADE_MAX_FRAMES * 2];  // room for stereo

// The window (windowStart/windowEnd), in frames of one voice's copy. Never
// empty, however small the window or coarse the copy.
CopyWindow windowInCopy(const Voice &v) {
  uint32_t total = v.reader.totalFrames();
  uint32_t start = (uint32_t)windowStart >> v.level;
  uint32_t end = (uint32_t)windowEnd >> v.level;
  if (end > total) end = total;
  if (start >= end) {
    start = (end > 0) ? end - 1 : 0;
    end = start + 1;
  }
  CopyWindow w;
  w.start = start;
  w.length = end - start;

  // The crossfade needs the same length of audio from outside the window:
  // the lead-in before its start, or failing that what follows its end.
  // The whole file has neither, and loops as it always did.
  uint32_t fade = (uint32_t)(WINDOW_FADE_SECONDS * (nativeRate >> v.level));
  if (fade > WINDOW_FADE_MAX_FRAMES) fade = WINDOW_FADE_MAX_FRAMES;
  if (fade > w.length / 4) fade = w.length / 4;
  w.fadeAtEnd = start >= fade;
  if (!w.fadeAtEnd && end + fade > total) fade = 0;
  w.fade = fade;
  return w;
}

// Gives a voice the window afresh, with its position `window.start` at the
// start of the window - for a voice that's about to be primed from
// scratch. moveVoiceWindow() is the one for a voice that's playing.
void resetVoiceWindow(Voice &v) {
  v.window = windowInCopy(v);
  v.windowBase = (int32_t)v.window.start;
}

// The only place a virtual (signed, possibly-wrapped-many-times-over)
// sample position gets mapped onto a real, in-range file sample offset:
// round and round the voice's window, with position windowBase at its
// start. AudioRingBuffer and the audio interrupt stay ignorant of
// wraparound in either direction - the buffer simply holds the window end
// to end, as many times over as fit.
uint32_t fileOffsetFor(const Voice &v, int32_t virtualPos) {
  int32_t m = (virtualPos - v.windowBase) % (int32_t)v.window.length;
  if (m < 0) m += (int32_t)v.window.length;
  return v.window.start + (uint32_t)m;
}

// Crossfades a run of frames just read from the card - `frames` of them
// in dst, from file offset `pos` - wherever it overlaps the window's fade:
// see "The window". Each frame there is mixed with the one a whole window
// away, outside the window, which is read into fadeBuffer.
void fadeSeam(Voice &v, uint32_t pos, int16_t *dst, size_t frames) {
  const CopyWindow &w = v.window;
  if (w.fade == 0) return;
  uint32_t zone = w.fadeAtEnd ? w.start + w.length - w.fade : w.start;
  uint32_t from = (pos > zone) ? pos : zone;
  uint32_t to = (pos + frames < zone + w.fade) ? pos + frames : zone + w.fade;
  if (from >= to) return;

  uint32_t other = w.fadeAtEnd ? from - w.length : from + w.length;
  if (v.reader.readFramesAt(other, fadeBuffer, to - from) != to - from) return;

  uint8_t channels = v.reader.channels();
  int16_t *mine = dst + (from - pos) * channels;
  for (uint32_t i = 0; i < to - from; i++) {
    // How much of the other audio: rising to all of it by the window's last
    // frame, or falling from all of it at the window's first.
    uint32_t n = from + i - zone;
    float mix = w.fadeAtEnd ? (float)(n + 1) / w.fade : (float)(w.fade - n) / w.fade;
    for (uint8_t c = 0; c < channels; c++) {
      int16_t &sample = mine[i * channels + c];
      sample = (int16_t)lroundf(sample + mix * (fadeBuffer[i * channels + c] - sample));
    }
  }
}

// Reads `frames` frames of a voice's copy into dst, starting at file offset
// `offset` (which must be inside its window) and carrying on round the
// window from its end back to its start, crossfaded there.
//
// A window can be much shorter than what's asked for - the minimum is a few
// frames of a low-rate copy - so once one whole lap is in dst, the rest is
// copied from there rather than read from the card again and again.
size_t readLooped(Voice &v, uint32_t offset, int16_t *dst, size_t frames) {
  uint8_t channels = v.reader.channels();
  uint32_t end = v.window.start + v.window.length;
  uint32_t pos = offset;
  size_t done = 0;
  while (done < frames) {
    if (pos >= end) pos = v.window.start;
    size_t n = frames - done;
    if (n > end - pos) n = end - pos;
    if (done >= v.window.length) {
      memcpy(dst + done * channels, dst + (done - v.window.length) * channels,
             n * channels * sizeof(int16_t));
    } else {
      n = v.reader.readFramesAt(pos, dst + done * channels, n);
      if (n == 0) break;  // shouldn't happen, but avoid spinning forever
      fadeSeam(v, pos, dst + done * channels, n);
    }
    done += n;
    pos += n;
  }
  return done;
}

// Points a voice at one copy of the named file: level 0 is the WAV itself,
// anything higher one of its cached copies. Leaves the voice untouched if
// the file can't be opened.
bool openVoice(Voice &v, const String &name, uint8_t level) {
  WavReader reader;
  bool ok = (level == 0)
                ? reader.open(("/sd/" + name).c_str())
                : reader.openRaw(MipCache::levelPath(name, level).c_str(), nativeRate >> level,
                                 fileChannels);
  if (!ok) return false;
  v.reader = std::move(reader);  // closes whatever the voice had open before
  v.ring.setChannels(v.reader.channels());
  v.level = level;
  v.levelScale = ldexpf(1.0f, -(int)level);
  resetVoiceWindow(v);
  return true;
}

// Empties a voice's ring buffer to start at virtual position `from`, then
// fills it forward until it holds `frames` (or is full).
void primeVoice(Voice &v, int32_t from, uint32_t frames) {
  v.ring.reset(from);
  while (v.ring.usedSpace() < frames && v.ring.freeSpace() >= CHUNK_FRAMES) {
    size_t got = readLooped(v, fileOffsetFor(v, v.ring.validHigh()), chunkBuffer, CHUNK_FRAMES);
    if (got == 0) break;
    v.ring.pushHigh(chunkBuffer, got);
  }
}

// The current file's copies, as they were when the builder last left it to
// prepare another file (see "Preparing a set") - which it only does once
// it's finished with this one.
uint8_t currentFileLevelsReady = 0;
uint8_t currentFileLevelCount = 0;

// How many of the current file's cached copies are ready to play, and how
// many it gets in all.
uint8_t readyLevels() {
  if (!fileLoaded) return 0;
  return (cache.name() == currentFilename) ? cache.readyLevels() : currentFileLevelsReady;
}
uint8_t levelCount() {
  if (!fileLoaded) return 0;
  return (cache.name() == currentFilename) ? cache.levelCount() : currentFileLevelCount;
}
int cachePercent() {
  if (!fileLoaded) return 0;
  if (cache.name() == currentFilename) return cache.percentDone();
  return currentFileLevelsReady == currentFileLevelCount ? 100 : 0;
}

// -- Preparing a set ----------------------------------------------------------
// A file's copies are built the first time it's cued, which takes a few
// seconds, and until then the fastest speeds are held back. Fine at home,
// not on stage. So a set can be prepared - every file in it built in turn,
// in the background, while the current file's copies are complete - by the
// web page's Prepare button (PREP:<set>), and whenever a set starts playing
// through. A file that's already built costs a quick check, no more.
std::vector<String> prepQueue;
size_t prepNext = 0;  // the next file in it to build

bool preparing() { return prepNext < prepQueue.size() || (cache.building() && cache.name() != currentFilename); }

void prepareSet(const String &set) {
  prepQueue = sortedWavPaths(set);
  prepNext = 0;
  Serial.print("Preparing set ");
  Serial.print(set.length() ? set : String("(card root)"));
  Serial.print(": ");
  Serial.print(prepQueue.size());
  Serial.println(" files");
}

// Starts building the next file in the queue - from loop(), when the
// builder has nothing to do.
void prepareNextFile() {
  if (prepNext >= prepQueue.size()) {
    if (!prepQueue.empty()) {
      prepQueue.clear();
      prepQueue.shrink_to_fit();
      Serial.println("Set prepared.");
    }
    return;
  }
  if (fileLoaded && cache.name() == currentFilename) {
    currentFileLevelsReady = cache.readyLevels();
    currentFileLevelCount = cache.levelCount();
  }
  cache.start(prepQueue[prepNext++]);
}

// The builder is about to be taken off whatever it's doing: if that's a
// file being prepared, it goes back in the queue, to be finished later.
void requeueInterruptedPrep() {
  if (cache.building() && prepNext > 0 && prepNext <= prepQueue.size() &&
      prepQueue[prepNext - 1] == cache.name()) {
    prepNext--;
  }
}

// -- Choosing a copy ----------------------------------------------------------
// A voice steps through its copy |step| * levelScale samples per tick. The
// interpolator low-passes as it reads (SincInterpolator.h), so any step is
// alias-free - but its cost grows with the step, since a read at 2 samples
// per tick needs twice the taps of one at 1. So the aim is a step between
// about 1 and 2, with hysteresis so that hovering right at a boundary
// doesn't bounce between copies:
//   - above LEVEL_UP_STEP, move to a higher (lower-rate) copy;
//   - below LEVEL_DOWN_STEP, move to a lower one.
// The two must be more than a factor of two apart, or a move one way would
// immediately qualify for a move straight back. Since both sides of a
// switch are band-limited the same way, the switch itself is inaudible
// wherever it happens (see "Playback voices" above).
const float LEVEL_UP_STEP = 2.0f;
const float LEVEL_DOWN_STEP = 0.85f;

uint8_t chooseLevel(float stepMagnitude, uint8_t current, uint8_t maxLevel) {
  if (current > maxLevel) current = maxLevel;
  float s = stepMagnitude * ldexpf(1.0f, -(int)current);
  if (s <= LEVEL_UP_STEP && (s >= LEVEL_DOWN_STEP || current == 0)) return current;
  // Out of range: jump straight to the copy that suits this speed, however
  // many levels away it is - one switch, not one per level.
  uint8_t k = 0;
  while (k < maxLevel && stepMagnitude * ldexpf(1.0f, -(int)k) > LEVEL_UP_STEP) k++;
  return k;
}

// The rate to choose a copy by, for a step through the original file.
//
// Unshifted, that's just the step. But the pitch shifter's grains read at
// their own rate - the step times pitchRatio, or grainTapRate when
// time-stretching - and readGrains() doesn't low-pass them, so it's the copy
// that has to: one filtered for the step alone would alias when the pitch is
// shifted far up, and lose its treble when it's shifted far down. So choose
// by the grains' rate instead - as long as the cursor stays within the
// voice's MAX_VOICE_RATE through it (the level choice keeps a step of up to
// LEVEL_UP_STEP, so a quarter of the step keeps it within 4x that).
//
// The same rule in both knob modes, so the same speed and pitch sound the
// same in either: it used to apply only while time-stretching, and
// switching modes at a large shift switched the aliasing on and off.
float levelRateFor(float step) {
  float s = fabsf(step);
  float grains = (grainTapRate >= 0.0f) ? grainTapRate : s * pitchRatio;
  return fmaxf(grains, s / 4.0f);
}

// Where voice `from` is right now, as a position in voice `to`'s copy.
// Integer arithmetic for the whole-sample part, since this runs with the
// audio interrupt masked and has to be quick - this chip has no hardware
// double precision - and since a float can't hold a large sample position
// exactly anyway.
void positionInCopy(Voice &from, Voice &to, int32_t &idx, float &frac) {
  uint64_t whole = fileOffsetFor(from, from.resampler.index);
  float part = from.resampler.frac;
  int shift = (int)from.level - (int)to.level;
  if (shift >= 0) {
    // To a higher-rate copy: every sample of `from` spans 2^shift of `to`'s.
    whole <<= shift;
    part = ldexpf(part, shift);
    float extra = floorf(part);
    whole += (uint64_t)extra;
    part -= extra;
  } else {
    // To a lower-rate copy: 2^-shift of `from`'s samples make one of `to`'s.
    int down = -shift;
    uint32_t remainder = (uint32_t)(whole & ((1u << down) - 1));
    whole >>= down;
    part = ldexpf((float)remainder + part, -down);
  }
  // A file offset in `to`'s copy, which is also a position in it: a freshly
  // opened voice's positions start out equal to its file offsets (see
  // resetVoiceWindow()).
  idx = (int32_t)whole;
  frac = part;
}

// How far each side of a voice's starting position to read before it
// plays: enough history behind it for the pitch shifter's grains (a grain's
// length, plus the interpolator's reach) and for playing backward, and
// enough ahead to cover how far the playing voice moves while this reads.
const int32_t PRIME_BEHIND = (int32_t)GRAIN_LENGTH_SAMPLES + 64;
const int32_t PRIME_AHEAD = 4096;

// Puts a voice at the top of the file - the start of its window - ready to
// be primed: where loadFile() and rewindToStart() begin. Except when a set
// is playing through backward: then a track starts at the window's end, so
// that it plays once through backward and ends at its start, rather than
// ending straight away. Returns where to prime the voice from, which is
// mostly behind it in the direction it's going.
int32_t cueAtTrackStart(Voice &v) {
  resetVoiceWindow(v);
  bool backward = setlistOn && lastKnownRatio < 0.0f;
  v.resampler.index = (int32_t)(backward ? v.window.start + v.window.length - 1 : v.window.start);
  v.resampler.frac = backward ? 0.999f : 0.0f;
  // PRIME_BEHIND is history for the interpolator and the pitch shifter's
  // grains, which trail the cursor - from the far side, going backward.
  return backward ? v.resampler.index + PRIME_BEHIND + CHUNK_FRAMES - (int32_t)v.ring.frameCapacity()
                  : v.resampler.index - PRIME_BEHIND;
}

// After a failed attempt to open a copy, don't retry on every control tick.
unsigned long levelChangeFailedMillis = 0;
const unsigned long LEVEL_CHANGE_RETRY_MS = 1000;

// Switches playback to the idle voice, opened on copy `target`. Everything
// slow - opening the copy, reading it from the card - happens on the idle
// voice while the active one keeps playing; interrupts are only masked for
// the microsecond or two it takes to hand over.
//
// That mask is noInterrupts(), not audioTimer.disable_overflow_irq() as
// elsewhere in this sketch. The difference matters here: re-enabling the
// timer's own interrupt (R_BSP_IrqEnable) also *clears* any tick that came
// due while it was off, so even a brief mask that way loses a tick - the
// DAC holds one sample twice, a tiny click - about one time in twenty.
// That's fine around loadFile()'s deliberate pause, but not on every copy
// change. noInterrupts() just delays a pending tick until interrupts()
// lets it through.
void startLevelChange(uint8_t target) {
  uint8_t idle = 1 - activeVoice;
  Voice &playing = voices[activeVoice];
  Voice &incoming = voices[idle];
  if (!openVoice(incoming, currentFilename, target)) {
    levelChangeFailedMillis = millis();
    return;
  }

  // Arrive at the new step now rather than gliding to it (see currentStep),
  // before priming: the new copy is primed only so far around where the
  // cursor will be, which assumes the cursor moves at the speed the copy
  // was chosen for while it's read. Gliding down from 200x instead carried
  // it through several more loops of a short file meanwhile, far from the
  // primed stretch, and playback never recovered.
  noInterrupts();
  currentStep = targetStep;
  stepSlope = 0.0f;
  interrupts();

  int32_t idx;
  float frac;
  positionInCopy(playing, incoming, idx, frac);
  int32_t primedAt = idx;
  primeVoice(incoming, idx - PRIME_BEHIND, PRIME_BEHIND + PRIME_AHEAD);

  noInterrupts();
  // Again, now: the playing voice moved on while the copy was being read.
  positionInCopy(playing, incoming, idx, frac);
  // If it crossed the end of the window meanwhile, the fresh position will
  // have wrapped round to the start - but the ring was primed in one
  // continuous stretch, so unwrap it back alongside where priming began.
  int32_t len = (int32_t)incoming.window.length;
  if (idx < primedAt - len / 2) idx += len;
  if (idx > primedAt + len / 2) idx -= len;
  incoming.resampler.index = idx;
  incoming.resampler.frac = frac;
  activeVoice = idle;  // the old voice goes idle, ready for the next change
  interrupts();

  Serial.print("Switched to ");
  if (target == 0) {
    Serial.println("the original file");
  } else {
    Serial.print("copy ");
    Serial.print(target);
    Serial.print(" (1/");
    Serial.print(1 << target);
    Serial.println(" rate)");
  }
}

// Tops up one voice's ring buffer by at most one chunk, in whichever
// direction it's playing - see the refill comment in loop() for the
// direction-aware margin this keeps.
// Normally the cursor can't leave the stretch of file held in its voice's
// ring buffer: when a read would reach past either end, the audio
// interrupt reports an underrun and stays put until the refill catches up.
// Only code that sets the position directly can strand it outside - a copy
// change, which hands the cursor to a copy that was read in around where
// the cursor was a moment earlier, is the one that can. If the cursor has
// moved further than that while the copy was read (a slow card, or a bug -
// see startLevelChange()), the refill can't recover: it grows the buffer
// from its edges, and once it's full there's nowhere left to grow toward
// the cursor. Playback would stay silent until a rewind or a new file. So
// loop() checks every pass, and reloads the buffer around the cursor if it
// ever finds it outside - a dropout of a few milliseconds instead.
//
// How far past an edge the cursor can legitimately be: an advance only
// happens after a successful read, so at most one step's worth beyond.
const int32_t STRANDED_SLACK = 64;  // frames
uint32_t strandedRepairs = 0;

void repairStrandedCursor(Voice &v, float step) {
  int32_t pos = v.resampler.index;
  if (pos >= v.ring.validLow() - STRANDED_SLACK && pos < v.ring.validHigh() + STRANDED_SLACK) return;

  // Same care as rewindToStart(): the interrupt reads the position and the
  // buffer, so it's held off across the reload.
  audioTimer.disable_overflow_irq();
  pos = v.resampler.index;
  // More runway on whichever side the cursor is heading toward.
  int32_t from = (step < 0.0f) ? pos - PRIME_AHEAD : pos - PRIME_BEHIND;
  primeVoice(v, from, PRIME_BEHIND + PRIME_AHEAD);
  audioTimer.enable_overflow_irq();
  restartDropCount();

  strandedRepairs++;
  Serial.print("Playback cursor was stranded outside its buffer - reloaded it there (");
  Serial.print(strandedRepairs);
  Serial.println(" so far). This shouldn't happen; please report it.");
}

void refillVoice(Voice &v, float step) {
  if (!v.reader.isOpen()) return;
  int32_t pos = v.resampler.index;

  if (step > 0.0f) {
    int32_t wantLow = pos - REVERSAL_MARGIN;
    if (wantLow > v.ring.validLow()) v.ring.releaseLow(wantLow);
    if (v.ring.freeSpace() >= CHUNK_FRAMES) {
      size_t got = readLooped(v, fileOffsetFor(v, v.ring.validHigh()), chunkBuffer, CHUNK_FRAMES);
      if (got > 0) v.ring.pushHigh(chunkBuffer, got);
    }
  } else if (step < 0.0f) {
    int32_t wantHigh = pos + REVERSAL_MARGIN;
    if (wantHigh < v.ring.validHigh()) v.ring.releaseHigh(wantHigh);
    if (v.ring.freeSpace() >= CHUNK_FRAMES) {
      // A "backward" chunk needs no in-memory reversal: it's an
      // ordinary forward read starting earlier in the file, which
      // lands in exactly the ascending order pushLow() expects.
      int32_t startVirtual = v.ring.validLow() - (int32_t)CHUNK_FRAMES;
      size_t got = readLooped(v, fileOffsetFor(v, startVirtual), chunkBuffer, CHUNK_FRAMES);
      if (got == CHUNK_FRAMES) v.ring.pushLow(chunkBuffer, got);
    }
  }
  // step == 0: paused - deliberately untouched. See Resampler.h's
  // advance() and audioCallback() above: this needs no special case
  // here either, since the consumer's position simply stops moving.
}

// -- The window ---------------------------------------------------------------
// Mode 3's two knobs move the start and the end of the stretch of file that
// plays. Everything else then treats that stretch as the whole tape: it
// loops, the transport rewinds to its start, and the scrub goes round it.
//
// That takes very little, because looping only ever happened in one place:
// fileOffsetFor(), which maps a voice's ever-advancing position onto the
// file, and now maps it onto the voice's window instead. The audio
// interrupt knows nothing about it.
//
// The catch is that a voice reads ahead - its ring buffer holds a third of
// a second at 1x, and many laps of the whole file at high speeds - and
// whatever is already buffered was read for the old window. So when the
// window moves under a playing voice (moveVoiceWindow()), the buffer is cut
// back to a short runway ahead of the cursor, and the window's mapping is
// re-anchored so that reading carries on seamlessly from there, round the
// new window. No dropout, and the change is heard within the runway's
// length.
//
// The join from the window's end back to its start is crossfaded, or it
// would click on every lap - the audio either side of it has nothing to do
// with each other. Over the window's last few milliseconds its own audio
// fades out while the lead-in to its start (the audio just before the
// window) fades in, so that by the last frame the signal is exactly what
// comes before the first, and carries straight on into it. A window at the
// very start of the file has no lead-in, so it's done the other way round
// there: the window's first few milliseconds fade in from the audio that
// follows its end. It's worked into the audio as it's read from the card
// (readLooped() and fadeSeam()), so it costs the audio interrupt nothing,
// and it's as smooth played backward or scrubbed across. It can't change
// what a short window is, though: a 20ms loop is a 50Hz buzz however
// neatly it's joined - only the click goes.
//
// If the cut would land outside the new window - an end has been
// moved past the playing position - reading carries on from the window's
// start instead (or from its end, playing backward).
//
// An end stops at the end of the file rather than carrying on round it,
// and the two ends can't come closer than WINDOW_MIN_SECONDS: push one
// into the other and both move.
const float WINDOW_MIN_SECONDS = 0.02f;

// How much already-buffered audio is left ahead of the cursor when the
// window moves, in frames of the voice's copy - around 5-10ms. Long enough
// that loop() refills it well before the cursor gets there.
const int32_t WINDOW_RUNWAY = 512;

double windowMinFrames() {
  return fmin((double)fileFrames, fmax(1.0, (double)WINDOW_MIN_SECONDS * nativeRate));
}

// Wraps a position in frames of the WAV into the window.
double wrapToWindow(double frames) {
  double length = windowEnd - windowStart;
  double wrapped = fmod(frames - windowStart, length);
  return windowStart + ((wrapped < 0.0) ? wrapped + length : wrapped);
}

// Brings a playing voice into line with a window that has just moved - see
// above. `step` only says which way it's playing.
void moveVoiceWindow(Voice &v, float step) {
  CopyWindow was = v.window;
  CopyWindow now = windowInCopy(v);
  if (now.start == was.start && now.length == was.length) return;

  // If everything buffered in the direction of travel lies inside both the
  // old window and the new one, in one piece and clear of both crossfades,
  // it's all still right and nothing need be thrown away. Otherwise keep
  // only a runway.
  int32_t cursor = v.resampler.index;
  int32_t limit = (step >= 0.0f) ? v.ring.validHigh() : v.ring.validLow();
  int64_t at = fileOffsetFor(v, cursor);
  int64_t reach = at + (limit - cursor);  // the far end of what's buffered that way
  int64_t lowest = (reach < at) ? reach : at;
  int64_t highest = (reach < at) ? at : reach;
  int64_t safeLow = was.start + was.fade;
  if (safeLow < now.start + now.fade) safeLow = now.start + now.fade;
  int64_t safeHigh = was.start + was.length - was.fade;
  if (safeHigh > now.start + now.length - now.fade) safeHigh = now.start + now.length - now.fade;
  bool stillGood = lowest >= safeLow && highest <= safeHigh;

  int32_t edge = cursor;  // the position the next read will join on to
  if (!stillGood && step >= 0.0f) {
    edge = cursor + WINDOW_RUNWAY;
    if (edge < limit) v.ring.releaseHigh(edge);
    else edge = limit;
  } else if (!stillGood) {
    edge = cursor - WINDOW_RUNWAY;
    if (edge > limit) v.ring.releaseLow(edge);
    else edge = limit;
  }

  // Re-anchor: the edge keeps the file offset it had if that's still in
  // the window, and otherwise becomes the window's start.
  uint32_t edgeAt = fileOffsetFor(v, edge);  // by the old window
  bool inside = edgeAt >= now.start && edgeAt < now.start + now.length;
  v.window = now;
  v.windowBase = inside ? edge - (int32_t)(edgeAt - now.start) : edge;
}

// Keeps a window legal: inside the file, and no shorter than the minimum.
void clampWindow(double &start, double &end) {
  double minimum = windowMinFrames();
  end = constrain(end, minimum, (double)fileFrames);
  start = constrain(start, 0.0, end - minimum);
}

// Sets the window, in frames of the WAV, and brings playback into line.
void setWindow(double start, double end) {
  clampWindow(start, end);
  windowStart = start;
  windowEnd = end;
  if (fileLoaded) moveVoiceWindow(voices[activeVoice], currentStep);
}

// WINDOW:<start>,<end>, in seconds - an exact window, mostly for testing.
void setWindowSeconds(const String &args) {
  int comma = args.indexOf(',');
  if (comma == -1 || !fileLoaded) return;
  setWindow(args.substring(0, comma).toFloat() * (double)nativeRate,
            args.substring(comma + 1).toFloat() * (double)nativeRate);
  printWindow();
}

void resetWindowToWholeFile() {
  setWindow(0.0, (double)fileFrames);
}

void printWindow() {
  Serial.print("Window: ");
  Serial.print(windowStart / nativeRate, 3);
  Serial.print("s to ");
  Serial.print(windowEnd / nativeRate, 3);
  Serial.print("s of ");
  Serial.print((double)fileFrames / nativeRate, 3);
  Serial.println("s");
}

// Whether the playing voice has all the data it wants for now - the cache
// builder only runs then, so a slow SD write never comes at the expense of
// playback.
bool voiceToppedUp(float step) {
  if (step == 0.0f) return true;
  return voices[activeVoice].ring.freeSpace() < CHUNK_FRAMES;
}

// Validates and switches to a new file. On failure, errorOut is set and
// whatever was already playing (if anything) is left completely
// untouched - a bad request never disturbs current playback. See the
// header comment for why the swap itself masks the audio timer's IRQ
// rather than using a checked pause flag.
bool loadFile(const String &filename, String &errorOut) {
  if (!isTrackPath(filename)) {
    errorOut = "invalid filename";
    return false;
  }
  String fullPath = "/sd/" + filename;

  WavReader candidate;
  if (!candidate.open(fullPath.c_str())) {
    errorOut = candidate.lastError();
    return false;
  }

  flushSettings();  // the outgoing file's, before it's replaced

  audioTimer.disable_overflow_irq();

  // Every file starts on its original WAV, in voice 0; the other voice is
  // closed until a copy change needs it.
  activeVoice = 0;
  voices[1].reader.close();
  voices[1].ring.reset();
  Voice &v = voices[0];
  v.reader = std::move(candidate);  // closes the old file (if any), adopts the new one
  v.level = 0;
  v.levelScale = 1.0f;
  endScrub();
  lastGoodLeft = lastGoodRight = 0;  // don't carry a stale frame into the new file
  grainOffset = 0.0f;
  // Per-file, not cumulative: the interesting number is how badly *this*
  // file underruns at the ratio being asked for, which is not comparable
  // across files with different native sample rates anyway. Safe to write
  // bare here - the audio interrupt is disabled for this whole block.
  underrunTicks = 0;
  nativeRate = v.reader.nativeSampleRate();
  fileChannels = v.reader.channels();
  v.ring.setChannels(fileChannels);
  voices[1].ring.setChannels(fileChannels);
  rateFactor = nativeRate / 48000.0f;
  fileFrames = v.reader.totalFrames();
  fitScrubToFile();
  // Each file starts at its own saved speed, pitch and window (native speed,
  // unshifted and the whole file if it has none), regardless of wherever
  // the (relative, not absolute - see resetVirtualKnobToNative()'s comment)
  // knobs currently sit: set directly rather than waiting for the next
  // control-rate tick to catch up, so there's no gap where the previous
  // file's settings apply.
  applySettings(FileSettings::load(filename));
  // And cued at the start of its window.
  int32_t primeFrom = cueAtTrackStart(v);
  stopAtTrackEnd = false;  // a new track hasn't ended - see setlistOn
  reachedTrackEnd = false;
  // Only moving if the transport is running. Starting at 1x regardless
  // played a fragment of every file picked while stopped: the audio comes
  // back on below, and cache.start() can take tens of milliseconds before
  // the next control tick notices the transport is stopped.
  setStepNow(transportRunning ? lastKnownRatio * rateFactor : 0.0f);

  // Prime the buffer before resuming, same as the original boot-time
  // pre-fill, so playback doesn't wake into an instant underrun. Always
  // fills forward from the start of the window regardless of which direction
  // the knob currently requests - if it's already parked at a negative
  // ratio the instant a file loads, a brief low-side underrun is
  // possible for a fraction of a second until loop()'s normal backward
  // refill catches up. Same accepted trade-off as the file-switch click
  // this function already causes - see the header comment.
  //
  // Starts PRIME_BEHIND samples before the start of the window - i.e. from
  // the end of it, since the window plays as a loop - so the interpolator
  // has history to reach back into from the very first sample. (See
  // cueAtTrackStart() for a set playing backward.)
  primeVoice(v, primeFrom, v.ring.frameCapacity());

  audioTimer.enable_overflow_irq();
  restartDropCount();

  currentFilename = filename;
  fileLoaded = true;
  rememberCurrentFile();
  Serial.print("Loaded ");
  Serial.print(filename);
  Serial.print(": ");
  Serial.print(nativeRate);
  Serial.print(" Hz, ");
  Serial.print(v.reader.formatName());
  Serial.print(fileChannels == 2 ? " stereo, " : " mono, ");
  Serial.print(v.reader.totalFrames());
  Serial.println(" frames");
  // Its set's gap, if it's a different set - see "Sets".
  String set = setOf(filename);
  if (set != gapSet) {
    setGapSeconds = FileSettings::loadGap(set);
    gapSet = set;
  }
  // Check this file's cached copies, and build whatever's missing - in the
  // background, a step per loop() pass. Until they're ready, high speeds are
  // capped (see the control block in loop()).
  requeueInterruptedPrep();
  cache.start(filename);
  return true;
}
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
