myklemykle/tweacman/MultiTurnKnob/examples/MultiTurnPlotter/MultiTurnPlotter.ino

// SPDX-License-Identifier: LGPL-3.0-or-later
// Copyright (C) 2026 Mykle Hansen
// Specified by Mykle Hansen, implemented by Claude (Anthropic).

/*
  MultiTurnPlotter - MultiTurnKnob library

  Wraps one RV112FF-40 pot in a MultiTurnKnob and streams both its raw
  single-turn angle and the unbounded accumulated position to the Arduino
  Serial Plotter (Tools > Serial Plotter in the Arduino IDE - arduino-
  cli's `monitor` command shows the same raw text but won't draw the
  graph).

  Wiring (SparkFun Thing Plus RA6M5): pot wipers -> A2, A3; both track
  ends -> 3.3V and GND (same as RV112FF's own KnobAnglePlotter). On
  another board, use any two analog pins it has.

  Spin the knob past a full turn in either direction and watch
  accumulated keep counting past +-360, while angle keeps resetting to
  [0, 360) every revolution. Press USR_BTN to call write(0) and watch
  accumulated jump to wherever the shaft physically is right now, minus
  nothing - i.e. "here" becomes the new zero. (On a board without a
  USR_BTN, that part is simply left out.)
*/

#include <RV112FF.h>
#include <MultiTurnKnob.h>

RV112FF pot(A2, A3);
MultiTurnKnob knob(pot);

const unsigned long PLOT_INTERVAL = 20;  // milliseconds (~50 Hz)
unsigned long previousMillis = 0;

#ifdef USR_BTN
bool lastButtonState = HIGH;  // USR_BTN is active-low (INPUT_PULLUP)
#endif

void setup() {
  Serial.begin(115200);
#ifdef USR_BTN
  pinMode(USR_BTN, INPUT_PULLUP);
#endif
}

void loop() {
  // The usual non-blocking pattern: compare the clock instead of
  // delay().
  unsigned long currentMillis = millis();

#ifdef USR_BTN
  bool buttonState = digitalRead(USR_BTN);
  if (buttonState == LOW && lastButtonState == HIGH) {
    knob.write(0);
  }
  lastButtonState = buttonState;
#endif

  if (currentMillis - previousMillis >= PLOT_INTERVAL) {
    previousMillis = currentMillis;

    // knob.read() is what actually samples the wrapped pot - see
    // MultiTurnKnob.h - so pot.read() is never called directly here;
    // lastAngle() reports what that same read() just saw the pot's own
    // single-turn angle as, without sampling it again.
    float accumulated = knob.read();
    float angle = knob.lastAngle();

    // Serial Plotter format: comma-separated "label:value" pairs, one
    // line per sample.
    Serial.print("angle:");
    Serial.print(angle);
    Serial.print(",accumulated:");
    Serial.println(accumulated);
  }
}
