myklemykle/tweacman/(commit log)

2026-09-14 Initial commit: Hello World over USB serial
    Blinks the onboard LED and greets over USB serial. Includes the
    Arduino toolchain Makefile and its setup writeup.
2026-09-14 Add DAC audio test: alternating 220 Hz beeps on A0/A1
    Uses the analogWave library (hardware timer + DTC, no CPU bit-banging)
    to alternate a 220 Hz sine tone between the RA6M5's two on-chip DAC
    channels, one second at a time - a baseline hardware check before
    Faust enters the picture, and a way to A/B audio output circuits
    (e.g. a coupling capacitor on one channel but not the other).
    The DAC's internal output amplifier (lowers output impedance for
    driving an external load) is left off here, matching the Arduino
    core's default - a deliberate baseline to compare against later.
    Confirmed working on hardware: verified via Serial log (clean 1.00s
    alternation, no drift) and by listening to both c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
    [DACAudioTest.ino]
2026-09-14 Hack: enable DAC output amplifier on A0 via direct register access
    The Arduino core hardcodes the RA6M5's DAC output amplifier off
    (dac.cpp: output_amplifier_enabled = 0) with no exposed way to turn it
    on. This reaches directly into the DAC peripheral (R_DAC->DAAMPCR_b /
    DAASWCR_b / DACR_b) after analogWave has already opened and started
    the channel, replaying the same enable sequence Renesas' own driver
    uses internally in r_dac.c.
    Applied to A0 (left, no coupling cap) rather than A1, to isolate the
    amplifier as a variable on its own rather than conflating it with the
    capacitor already on the other channel.
    Confirmed on hardware: compiles and runs without a hang or crash
    (clean 1.00s L/R a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
    [DACAudioTest.ino]
2026-09-14 Toggle DAC output amplifier on both channels together
    Was applying the register-level amplifier hack to one channel only
    (AMP_HACK_CHANNEL); now setDacOutputAmplifiers() drives A0 and A1
    together every 4 seconds, alongside setDacOutputAmplifier() for the
    single-channel case it's built on.
    Confirmed on hardware: both timers (1s L/R alternation, 4s amp
    toggle) run independently without drift or interference, and
    confirmed by listening.
    [DACAudioTest.ino]
2026-09-14 Add RV112FF library: driver for the Taiwan Alpha RV112FF-40 dual pot
    Decodes an absolute shaft angle in degrees from the pot's two wiper
    signals (90 degrees out of phase), self-calibrating from the observed
    signal range. Polled from loop() rather than interrupt-driven, API
    styled after PJRC's Encoder library (read() returns the current
    value) with two deliberate departures that follow from the hardware:
    read() returns a float in degrees rather than an accumulating count,
    since this is a single-turn absolute sensor with no multi-turn memory;
    and there's no write(), since there's no external reference to set -
    the angle just reflects where the shaft physically is. Also reports
    rotational speed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
2026-09-14 Add getCalibration()/setCalibration() for persisting calibration to NVM
    Returns/accepts a small RV112FFCalibration struct (magic + version +
    a plain byte-sum checksum + the min/max envelope) so a sketch can
    save a completed calibration - e.g. via the board's built-in EEPROM
    library, backed by this board's dedicated 8KB data flash - and
    restore it after a reboot instead of re-sweeping the shaft every
    power-on. The library stays storage-agnostic; it only validates and
    adopts (or refuses) a calibration handed back to it.
    setCalibration() leaves the pot's current state untouched and returns
    false on any validation failure - wrong magic, wrong version, bad
    checksum, or a technically-intact but p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
    [RV112FF.cpp, RV112FF.h, SerialPlotterDemo.ino]
2026-09-14 Add AudioKnobsDemo: two Faust sine oscillators controlled by the pots
    Each RV112FF pot bends its own oscillator's pitch in real time: the
    pot's angle is folded around its 180-degree midpoint (so the sweep
    reverses there and at 0/360 instead of jumping discontinuously across
    the wrap) and mapped exponentially onto 50-10000 Hz, so equal angular
    steps feel like equal pitch steps rather than equal Hz steps. Mono
    output - the two oscillators mix together and the identical signal
    drives both DAC channels. Each oscillator stays silent until its pot
    finishes self-calibrating, fading in via Faust's own si.smoo rather
    than snapping on and clicking.
    First real use of Faust in this project (installed s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
    [AudioKnobsDemo.ino, faust_support.h, synth.h]
2026-09-14 Split Bluetooth LE demo out of HelloWorld.ino into its own sketch
    Every other feature in this repo (DAC audio, the RV112FF pot library,
    the audio+knobs demo) lives in its own top-level sketch folder, kept
    separate so they can be merged together without one feature's code
    displacing another's. Bluetooth was the one exception - it was added
    in place to HelloWorld.ino back when this repo had no history to be
    tidy about yet, rather than as a separate sketch.
    HelloWorld.ino reverted to its original USB-serial-only content
    (pulled from the initial commit, de2b189, and diffed byte-for-byte
    against it to confirm an exact match). The combined serial+BLE code
    that used to live there moves to a new He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
    [HelloWorld.ino, HelloWorldBLE.ino]
2026-09-14 Document hardware, peripherals, and project conventions in CLAUDE.md
    Summarizes everything learned so far: the RA6M5's memory layout and
    Data Flash characteristics, DAC/ADC pin mapping and resolution
    defaults, the DAC output amplifier hack, native-USB Serial's discard-
    before-attach behavior, the DA14531 BLE coprocessor and its wiring,
    the audio jack's coupling-capacitor setup, the two RV112FF-40 pots
    and their wiring, the fragile manually-overlaid Arduino core, Faust's
    integration pattern, and the one-sketch-per-feature / library-in-repo
    conventions this project has settled into.
2026-09-15 Add CapTouch library: RA6M5 CTSU capacitive touch sensing
    Clean-room implementation against the RA6M5 Hardware User's Manual
    (Chapter 46, CTSU), polled from loop() like this project's other
    peripheral libraries rather than interrupt-driven. Provides both a
    graduated readRaw() and a thresholded isTouched() per pin, across the
    board's three known touch-capable pins (D20/TS05, D21/TS04, D31/TS11).
    Confirmed working on real hardware (D20/D21 wired, ~10nF TSCAP
    capacitor on D6) after tracking down four register-level bugs via live
    tracing against the manual's initial-settings flow and status-counter
    state machine:
    - TSCAP was never routed to the CTSU peripheral function (left as a
    plain digit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
    [CapTouch.cpp, CapTouch.h, SerialPlotterDemo.ino]
2026-09-15 CapTouch: track an adapting baseline instead of a fixed threshold
    The CTSU hardware only reports a raw graduated count - it has no
    concept of "touched" and no ability to recalibrate itself, so a fixed
    absolute threshold drifts out of calibration with temperature,
    humidity, or (as found testing this) touching an entirely different
    object like produce instead of a finger.
    Each scan() now nudges a per-pin, slowly-adapting baseline toward the
    raw reading (a first-order low-pass filter, ~2s time constant, using
    millis() so it isn't tied to how often scan() gets called) - but only
    while the pin isn't currently touched, so a genuine touch-and-hold
    doesn't get absorbed into the baseline while it's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
    [CapTouch.cpp, CapTouch.h, SerialPlotterDemo.ino]
2026-09-15 CapTouch: fix misattributed results for the last channel in a scan
    CTSUMCH0 was being re-read at the point CTSUDTSR fires, to identify
    which channel a just-finished result belongs to. For the last channel
    in a multi-channel scan, that read was racing against the hardware
    resetting CTSUMCH0 back to an idle/invalid value (0x1F) as part of
    wrapping the scan up - confirmed by tracing every (channel, raw) pair
    live, which showed the last channel's results consistently attributed
    to "channel 31" (not a real channel) instead of its actual number.
    The practical symptom: with two pins registered, the second-scanned
    pin's readRaw()/isTouched() only updated on the rare cycle CTSUMCH0
    hadn't yet been r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
    [CapTouch.cpp]
2026-09-15 Add MultiTurnKnob: multi-turn counting on top of RV112FF
    The RV112FF-40 is confirmed (manufacturer datasheet) to be an "endless
    rotary" pot with no mechanical stop, rated for 15,000 rotation cycles
    - but RV112FF's own read() only reports the absolute single-turn angle
    [0, 360), with no memory of how many times the shaft has been spun.
    MultiTurnKnob wraps an RV112FF instance and adds that memory: each
    read() compares the pot's new angle to its previous one, and treats a
    jump of more than 180 degrees as having crossed the 0/360 seam rather
    than an implausible half-turn-plus single-sample motion, crediting or
    debiting a full revolution to land on the correct short-way delta.
    Accumulates into a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
    [SerialPlotterDemo.ino]
2026-09-15 AudioKnobsDemo: touch-gated fast/slow knob speed
    Each knob now has a CapTouch pad next to it (D20 for knob1, D21 for
    knob2, sharing D6/TSCAP). Touching the pad while turning gets "fast" -
    half a turn sweeps the whole 50-10000Hz range, the same rate this demo
    always used. Released, it's "slow" - a 4x reduction in sensitivity,
    taking two full turns per sweep - for finer control than a single-turn
    mapping could ever give.
    This is exactly why MultiTurnKnob exists: each pot is now wrapped in
    one, whose unbounded accumulated position (rather than RV112FF's own
    single-turn [0,360) angle) is scaled by how many physical turns should
    cover one sweep, then fed through the same fold-and-exponential-map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
2026-09-15 Add WS2812TouchDemo: onboard RGB LED layered with CapTouch pads
    Drives the board's onboard WS2812 (D13/P105) via FastLED. Green
    breathes continuously on a 2-second cycle as a liveness indicator;
    touching touch1 (D20) blends in red and touch2 (D21) blends in blue,
    both riding the same shared brightness envelope as green rather than
    each running their own pulse, so a color blending in or out mid-breath
    reads as one coherent light rather than colliding rhythms.
    Brightness scaled to 25% via FastLED.setBrightness() - the LED is
    uncomfortably bright at full output - applied globally so the 0-255
    color/pulse math elsewhere stays in terms of full scale.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
    [WS2812TouchDemo.ino]
2026-09-15 Add AudioKnobsWebBLEDemo: WebBLE remote for the audio-knobs synth
    Extends AudioKnobsDemo (unchanged pitch mapping, touch-gated speed,
    Faust audio engine) with a companion web page that talks to the board
    over the onboard DA14531MOD's existing CodeLess BLE link - the same
    GATT service and pipe convention HelloWorldBLE already uses, now used
    bidirectionally for the first time in this project:
    - Outbound (board -> phone), every 200ms while connected: a "|F1:...,
    F2:...,T1:...,T2:..." telemetry line with both oscillators' current
    frequency and effective touched state.
    - Inbound (phone -> board): plain "T1:1"/"T1:0"/"T2:1"/"T2:0" commands,
    press-and-hold semantics matching the physical pad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
    [AudioKnobsWebBLEDemo.ino, faust_support.h, synth.h]
2026-09-15 AudioKnobsWebBLEDemo: switch to CodeLess Binary mode for real inbound data
    The previous commit's own header comment flagged this as untested, and
    it wasn't - confirmed live that CodeLess's AT-command link genuinely
    has no inbound equivalent of its outbound "|" pipe convention. Writing
    plain text to the Inbound Command characteristic gets parsed as an AT
    command and rejected outright ("EC06: Non AT command"), so touch-pad
    commands from the web page never reached the board at all.
    The real mechanism is CodeLess's separate "Binary mode" / DSPS (Direct
    Serial Port Service) - documented in Renesas' UM-140 manual section
    8.6 specifically for a "Generic GATT Client" (a plain web page, not
    another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
2026-09-15 Update CLAUDE.md for today's additions
    Catches the project reference doc up with everything built and merged
    today: the CapTouch and MultiTurnKnob libraries, CTSU/touch-pad wiring,
    the WS2812 LED now actually in use, and the DA14531's CodeLess Binary
    mode/DSPS path for real bidirectional BLE data (plus its phone-side
    WebBLE-app gotchas). None of this was reflected here before, even
    though it was all committed - this is the document a fresh session
    reads first, so letting it go stale defeats the point of keeping it.
    Claude-Session: https://claude.ai/code/session_019iNCcNd5hSLCZLP9Uc6GXv
2026-09-16 Add SDResampleDemo: SD-streamed WAV playback with arbitrary-ratio resampling
    Streams a mono 16-bit WAV off the SD card and plays it at a fixed 48kHz
    DAC output, with a pot driving a continuously-variable speed ratio via a
    phase-accumulator/Catmull-Rom resampler - decoupling playback speed from
    the DAC's own hardware ceiling so the demo actually probes SD read
    throughput instead. Bench-tested: underruns onset around a 23-25x speed
    ratio (~2-2.2MB/s), unaffected by SD read chunk size or ring buffer size,
    pointing at the card's own sustained read speed rather than software
    overhead as the limiting factor - worth re-checking against other cards.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
    [Resampler.h, RingBuffer.h, SDResampleDemo.ino, WavReader.cpp, WavReader.h]
2026-09-17 SDResampleDemo: report min/max speed ratio seen between status prints
    Added while chasing a since-resolved buffer-occupancy anomaly - confirms
    knob/pot noise is negligible (ranges come back razor-tight, e.g.
    0.399-0.400), so it wasn't the cause. Kept since it's cheap and useful
    if similar buffer behavior needs diagnosing again later.
    [SDResampleDemo.ino]
2026-09-18 SDResampleDemo: add BLE file picker and live telemetry over WebBLE
    Lets a phone/browser list WAV files on the SD card, switch playback to
    one (validated before touching any shared state, swapped under a masked
    audio-timer IRQ rather than a checked pause flag), and watch live speed/
    buffer/underrun stats - reusing AudioKnobsWebBLEDemo's CodeLess Binary
    mode/DSPS handshake. Boot no longer auto-loads a file; playback starts
    only once a BLE PLAY: command picks one.
    Chased down two real bugs surfaced by this: WavReader leaked/never
    closed its file handle across repeated opens (harmless with the old
    one-file-at-boot design, real once files switch at runtime), and
    ble.sendCommand()'s blocking wait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
    [RingBuffer.h, SDResampleDemo.ino, WavReader.cpp, WavReader.h]
2026-09-18 SDResampleDemo: fix missing/garbled now-playing on fresh BLE connect
    A freshly-connected client had no way to learn what was already
    playing - the one-time sync used to be sent right after AT+BINREQACK,
    but that collided with the ack's own echo and got removed. Piggyback
    PLAYING:<name> onto the FILES:END response instead, since a client
    already reliably requests the file list once on connect - no new
    early-handshake message needed. Also add a UTF-8 charset declaration:
    the page's placeholder em-dash was rendering as a mojibake glitch
    character under python -m http.server, which doesn't always send a
    charset in its Content-Type header.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
    [SDResampleDemo.ino]
2026-09-18 SDResampleDemo: add bidirectional (forward + reverse) playback
    The knob now sweeps a bipolar speed ratio, -MAX_RATIO to +MAX_RATIO, with
    a real pause in the deadband around the middle and an instant direction
    hop only at the knob's own physical wrap-around seam - everywhere else,
    including straight through zero during ordinary turning, is smooth and
    click-free.
    The core change is AudioRingBuffer itself: its tail_/head_ counters were
    monotonically increasing "samples ever produced" counts, append-only at
    the high end, with no way to represent data *before* what's already been
    produced. Replaced with validLow_/validHigh_ marking a window in signed
    virtual-sample-position terms that can slide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
    [Resampler.h, RingBuffer.h, SDResampleDemo.ino, WavReader.cpp, WavReader.h]
2026-09-18 SDResampleDemo: reverse knob direction sense, keep exponential speed curve
    Confirmed live: the un-reversed mapping spun opposite the intuitive
    direction, so wrappedAngle now maps 0->+MAX_RATIO and (approaching)
    360->-MAX_RATIO instead of the other way around. Also tried a linear
    magnitude mapping instead of the exponential one, but that felt too
    twitchy below 100% - a linear mapping spends the same physical rotation
    on every equal-sized ratio step regardless of magnitude, leaving very
    little of the knob's travel for the sub-1x range. Reverted to
    exponential, which spends equal rotation on equal ratios instead.
    [SDResampleDemo.ino]
2026-09-18 SDResampleDemo: add tape-scrub effect on the second pot
    The second pot's rotational velocity (RV112FF::rpm(), not its absolute
    position) adds directly onto whatever the first pot already requests -
    with playback paused, this alone drives it, sounding like manually
    scrubbing a reel of tape; layered on top of ordinary playback it adds a
    wow/flutter-style warble; sitting still it contributes exactly nothing.
    All three fall out of one plain sum onto currentStep, no special-casing
    needed - the resampler/ring-buffer pipeline already handles arbitrary,
    rapidly-changing signed step values from the bidirectional work.
    RV112FF fix along the way: rpm() had its own separate exponential
    smoothing filter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
    [RV112FF.cpp, RV112FF.h, SDResampleDemo.ino]
2026-09-18 SDResampleDemo: make speed knob relative, anchored to native speed
    Speed always starts at 1.0x on boot and on every file switch, regardless
    of the physical pot's absolute position - only turning it moves speed
    away from native, by however much it's turned. Necessary because the
    pot is an endless-rotation part with no home position to return to.
    Fixes a bug where MultiTurnKnob's legitimately-negative accumulated
    angle was mistaken for its "not calibrated yet" sentinel, freezing the
    virtual knob the moment a turn crossed zero in one direction.
    [SDResampleDemo.ino]
2026-09-19 pcb: bootstrap cassette-shaped carrier board (KiCad 7)
    Outline traced from a 1:1 cassette model scaled so the hubs are 60mm apart,
    8mm hub cutouts with sprocket silkscreen, plated M3 holes, 40x20mm corner
    touch-pad footprints, Thing Plus footprint (rebuilt in KiCad 7 format from
    SparkFun's CC BY 4.0 library), and a copper-free/mask-free trapezoid window.
    tools/gen_board.py bootstraps the board; edit in KiCad afterwards.
    [cassette-carrier.kicad_pcb]
2026-09-19 pcb: add pots, jack, touch pads, tooling holes and the long Thing Plus footprint
    - RV112FF-40 footprint from the datasheet hole detail; pots placed on the hubs
    - Kycon STX-3120-3B jack footprint (built from Kycon's drawing), top-edge centred
    - 40x20mm touch pads moved 15mm in, two plated M3 antenna holes each
    - 1.152mm NPTH tooling holes in the corners
    - Thing Plus footprint rebuilt for the 2.70in long variant (antenna overhang),
    with silkscreen for the switches, LEDs, USB-C and BLE module
    - trapezoid window follows the Thing Plus edge; deterministic ids in gen_board.py
    [cassette-carrier.kicad_pcb]
2026-09-19 pcb: plated pot clip holes, tooling holes on corner-arc centres, Thing Plus 1mm lower
    [cassette-carrier.kicad_pcb]
2026-09-20 pcb: add the schematic, I2S mic, power switch and dual DC-blocker footprint
    - cassette-carrier.kicad_sch (generated by tools/gen_schematic.py) with custom
    symbols in cassette.kicad_sym: audio out with one-pole RC filter and DC
    blockers, filtered pots, pot supply with closed solder jumper, touch pads,
    Adafruit SPH0645LM4H I2S mic (BCLK/LRCLK/DATA on D4/D3/D1) and an EN-to-GND
    power switch
    - tools/check_netlist.py compares the exported netlist to the design table
    (KiCad 7's CLI has no ERC)
    - C_DCBlock_Dual footprint: one hole row for axial/radial electrolytic or film
    - regenerated board/footprints (deterministic ids) and KiCad's project file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
    [cassette-carrier.kicad_pcb, cassette-carrier.kicad_sch]
2026-09-20 pcb: add the optional SSD1306 OLED (DS1) and stop the generator clobbering the project file
    - DS1: 4-pin I2C SSD1306 module on the Thing Plus SDA/SCL (D15/D16), 3V3 and GND;
    footprint reuses the 0.91in 128x32 outline (origin at pin 1) and a 128x64
    module simply covers it
    - gen_board.py no longer rewrites cassette-carrier.kicad_pro; KiCad owns that
    file (design rules and settings), so it is only created if missing
    [cassette-carrier.kicad_sch]
2026-09-20 pcb: use the E-Switch EG1224 right-angle slide switch for SW1
    3 pins in a row at 4.0mm pitch (easier for beginners than the 2.0mm EG2208 or
    the placeholder), SPDT with pin 2 common, stock KiCad footprint.
    [cassette-carrier.kicad_sch]
2026-09-20 pcb: 3D model support for the custom footprints
    - tools/gen_3d.py (CadQuery) builds STEP models for the Thing Plus (long
    variant, from SparkFun's Eagle board), RV112FF pot, SPK-013A knob, SSD1306
    OLED and the Adafruit I2S mic, and re-orients Kycon's own STX-3120-3B STEP
    - footprints reference them via ${KIPRJMOD}/3dmodels/...; the models
    themselves are git-ignored (manufacturer files, local show-off use)
    - new I2S_Mic_SPH0645_Breakout footprint (socket pads, module outline, model);
    header order confirmed from Adafruit's board file
    - gen_board.py: --library-only rewrites just cassette.pretty so it can be used
    while the board is being placed by hand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
2026-09-20 pcb: snapshot of the hand-placed board (work in progress)
    Parts placed by hand in KiCad; not final, not yet routed or checked with DRC.
    [cassette-carrier.kicad_pcb]
2026-09-20 pcb: snapshot before the pot clip-hole and hub-hole change (MIC1 moved)
    [cassette-carrier.kicad_pcb]
2026-09-20 pcb: plated round 2.4mm pot case-clip holes at +-5.75mm, 7mm hub holes
    The datasheet's 13.0mm is outside-to-outside of two 2.0mm holes (11.0 centre
    spacing), not centre-to-centre as first assumed. Round 2.4mm holes centred at
    +-5.75 clear the 2.0mm-wide clip blades with play, and the hub holes shrink from
    8 to 7mm so the clip pads keep 0.65mm clearance to the board cut-out. Library,
    generators, 3D model and the placed board are updated to match.
    [cassette-carrier.kicad_pcb]
2026-09-20 pcb: touch pad keepouts, tap pads, Touch net class, cut-jumper resistor footprint
    - In1/In2 copper keepouts under each touch pad (+3mm) per Renesas R30AN0389
    - two B.Cu wire-tap pads in each pad's rounded bottom corners (patched into the
    board directly; the library update had not taken)
    - net class 'Touch' (0.15mm track, 1.0mm clearance) on the electrode nets
    - R_Axial_DIN0204_P7.62mm_CutJumper footprint: axial resistor with a bridged
    solder jumper centred between the holes (library only for now)
    - library footprints get per-footprint stable ids
    [cassette-carrier.kicad_pcb]
2026-09-20 pcb: R3 and JP1 become one footprint, R3 with a built-in cut jumper
    Schematic: R3 uses cassette:R_Axial_DIN0204_P7.62mm_CutJumper and JP1 is kept as
    documentation only (not in BOM, not on board). Board: R3 swapped in place
    (same position/rotation/nets), JP1 removed. Also includes the touch-wire
    tracks routed so far.
    [cassette-carrier.kicad_pcb, cassette-carrier.kicad_sch]
2026-09-20 pcb: snapshot of the board before the Thing Plus mounting-hole change
    [cassette-carrier.kicad_pcb]
2026-09-20 pcb: Thing Plus mounting holes, low-profile sockets, socket BOM lines
    - ThingPlus footprint gets four 3.048mm NPTH mounting holes at the Thing Plus's
    own hole positions (screws/bushings); U1 swapped into the board
    - 3D models: Thing Plus, OLED and mic all sit on 3mm low-profile sockets
    - schematic: XS1-XS4 BOM-only socket parts with LCSC part numbers (1x12, 1x16,
    1x4, 1x6, all 3mm round-hole turned-pin)
    [cassette-carrier.kicad_pcb, cassette-carrier.kicad_sch]
2026-09-20 pcb: remove I2S mic and OLED from rev 1 (preserved on feature/pcb-mic-oled)
    [cassette-carrier.kicad_pcb, cassette-carrier.kicad_sch]
2026-09-20 pcb: replace tooling holes with M3 NPTH case-mounting holes (MH1-MH4)
    [cassette-carrier.kicad_pcb, cassette-carrier.kicad_sch]
2026-09-20 pcb: routing, In2 GND plane, JLCPCB design rules, F.Cu strip joining DC-blocker cap negative holes
    [cassette-carrier.kicad_pcb]
2026-09-21 pcb: audio re-route, TCH1 re-route, In2 keepouts along touch traces, cleanup
    [cassette-carrier.kicad_pcb]
2026-09-21 pcb: pad edge setback, silk labels and text sizes, footprints refreshed from library, C3/C4 labels
    [cassette-carrier.kicad_pcb]
2026-09-21 pcb: BOM generator and CSV with purchasing specs and LCSC picks
    [cassette-carrier-bom.csv]
2026-09-21 AudioKnobsWebBLEDemo: fix the Binary mode handshake
    The link came up only intermittently, and when it failed the board's own
    telemetry came straight back at it as input. Traced on the wire from both
    ends; there were four separate bugs.
    The module answers AT+BINREQACK with neither OK nor ERROR - usually just
    an echo, after sendCommand() burns its full 2s timeout (it does sometimes
    answer OK, so neither outcome can be relied on). The sketch discarded that
    reply and latched binaryModeActive = true regardless, while the module
    stayed in command mode for the rest of the connection - echoing every
    telemetry line back, which is exactly the reported symptom. The grant only
    takes effect when that co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
    [AudioKnobsWebBLEDemo.ino]
2026-09-21 AudioKnobsWebBLEDemo: show only this board in the device picker
    The page listed every BLE device in range, which was useful while the
    handshake was being reverse-engineered and is just noise now.
    There is no class mask to filter on - Class of Device is a Bluetooth
    Classic concept with no BLE equivalent. Web Bluetooth does have a mask,
    but only inside a manufacturerData filter, and a scan confirms this board
    advertises no manufacturer data at all.
    It does advertise its name and the DSPS service UUID, so both are used as
    separate filter entries (Web Bluetooth ORs them). The DSPS UUID is the
    more meaningful test - it asks for a device offering this pipe rather than
    trusting a name string - bu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
2026-09-21 AudioKnobsWebBLEDemo: correct the AT+BINREQACK comments
    Three comments claimed the module answers AT+BINREQACK with neither OK
    nor ERROR. It does answer OK - it just holds the reply until the mode
    transition completes, which is at disconnect. Measured 481ms when the
    central hung up right after the ACK, and 14.3s when a test client stayed
    connected first, so what looked like an inconsistent reply was really one
    deferred event being observed at two different delays.
    Comments only, no behaviour change. Also notes why lengthening
    sendCommand()'s timeout is the wrong fix: it blocks, so waiting seconds
    there would stall the knob and touch loop.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
    [AudioKnobsWebBLEDemo.ino]
2026-09-21 AudioKnobsWebBLEDemo: turn BLE_TRACE off by default
    The Serial2 wire trace did its job; leaving it on narrates every byte to
    the USB monitor, which is noise for anyone reading this sketch as a demo.
    Flip the define back to 1 when the link needs investigating again.
    Compiles out cleanly - 94832 -> 94424 bytes.
    [AudioKnobsWebBLEDemo.ino]
2026-09-21 Add CodelessPipe design proposal
    Captures the DA14531 Binary mode / DSPS knowledge as a plan for a reusable
    library, before it decays into tribal knowledge spread across three sketches.
    Proposal only - nothing implemented. Records what the library must own, the
    argument for shipping the Arduino and browser halves together, four open
    decisions (probe payload, whether the mode transition can be forced, Stream
    vs a narrower API, and the wire trace), and the agreed sequencing: port the
    fixes into the remaining sketches first, then extract the library from three
    working call sites.
2026-09-21 SDResampleDemo: port the Binary mode fixes
    Brings this sketch in line with AudioKnobsWebBLEDemo: boot-time escape
    (+++ then ATR) so a module left wedged in Binary mode by a previous sketch
    is recovered, BleLinkMode with echo-probing in place of the binaryModeActive
    flag that was set on faith, Serial2 bursts split into lines before dispatch,
    traced bring-up in place of setupDefault(), and BLE_TRACE available but off.
    Outbound writes now go through blePrintLine(), which records the last line
    sent so the loop can recognise its own words echoed back - the measurement
    the whole mode detection rests on. The existing non-blocking direct writes
    for AT+BINREQACK and AT+ADVSTART are kept: blocking th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
    [AudioKnobsWebBLEDemo.ino, SDResampleDemo.ino]
2026-09-21 SDResampleDemo: non-blocking file list, and filter the device picker
    The connect-time LIST stalled playback. sendFileList() paced itself with
    delay(40) between names, and pacing is genuinely necessary - sending
    back-to-back outruns the module's relay rate and the periodic telemetry tick
    gets serialised into the middle of the client's list. But with 34 .WAV files
    on the card that is 1.4 seconds during which loop() does no SD refill at all,
    while the audio interrupt keeps draining the ring buffer. Clients request
    LIST as soon as they connect, so this was audible on every connection.
    Now the list is pumped one name per loop() pass at the same 40ms spacing,
    with the directory handle held open i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
    [SDResampleDemo.ino]
2026-09-21 SDResampleDemo: don't count idle as underrun; count per file
    audioCallback() had no notion of whether a file was loaded, so with nothing
    playing ring.peek4() failed every tick and counted an underrun. Measured from
    the boot log: 24003, 24006 and 24005 underruns per 500ms status tick against
    a 48000Hz timer - one per interrupt, 48000 phantom underruns a second for as
    long as the board sat idle. The counter was in the millions before anything
    was ever played, which made this demo's headline measurement meaningless.
    An underrun means the producer could not keep up with the consumer. With no
    file loaded there is no producer and nothing is expected, so idling is not an
    underrun: the ISR now hold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
    [SDResampleDemo.ino]
2026-09-22 SDResampleDemo: raise SCRUB_SCALE so scrubbing actually moves the cursor
    Scrubbing backwards over speech sounded like it moved the playback cursor
    back, but letting go resumed within a fraction of a second of where the
    gesture started. The cursor was moving - just not far enough to matter.
    Scrub is summed onto knob1's ratio rather than overriding it, so forward
    playback keeps running underneath a scrub. At 1/60, one full turn displaced
    the cursor by 48000 source samples (one second of a 48kHz file), while 1x
    playback on a 44.1kHz file eats 44100 samples every second. The two cancel
    at about 0.92 turns per second, so any gesture slower than that still drifts
    forward while sounding like it is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
    [SDResampleDemo.ino]
2026-09-22 SDResampleDemo: scale scrub with playback speed, floored at 1x
    A fixed scrub contribution is a shrinking fraction of the motion already
    happening: at 20x, a scrub worth +/-1 step perturbs the cursor by five
    percent and is essentially inaudible. Multiplying it by the speed magnitude
    keeps it a constant proportion of whatever is playing, so the gesture feels
    the same at any speed.
    It also makes the turn rate needed to overcome forward playback
    speed-independent - roughly a quarter turn per second whether at 1x or 20x -
    since both sides of the sum now scale together.
    The floor at 1x is load-bearing rather than a nicety. The primary tape-scrub
    case parks knob1 in its pause deadband, where the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
    [SDResampleDemo.ino]
2026-09-22 RV112FF: discard one conversion per channel to let the ADC settle
    The RA6M5's SAR converter multiplexes a single sample-and-hold capacitor
    across every analog pin. Switching the mux and converting immediately leaves
    that cap still partly charged to the previous channel's voltage, and a pot
    wiper is a high-impedance source, so it settles slowly. The reading is pulled
    toward whatever was measured just before it.
    With two of these pots a sketch reads four channels back to back every
    control tick, so each pot's reading is contaminated by the other's. Measured
    on the bench in SDResampleDemo, where one pot's rpm() drives a tape-scrub
    effect in real time: turning the *other* pot biased the reporte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
2026-09-22 SDResampleDemo: hold-to-play transport on touch pad 2, and a scrub deadband
    Adds touch2 (D21) - this sketch previously only had touch1 for the knob's
    fast/slow gate. Held means running, released means stopped.
    "Stopped" is a speed of zero rather than a mode, because zero was already a
    fully supported state everywhere downstream: Resampler.h's advance() freezes
    index and frac exactly when step is 0 (that is the whole implementation of
    pause, with no special case in the audio ISR), and the direction-aware refill
    already had an explicit paused branch. Stopping is just declining to add
    knob1's contribution to the sum. Scrub deliberately survives, because it is a
    separate term - a stopped tape s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
2026-09-22 SDResampleDemo: rewind on play, and show the requested speed when stopped
    Starting the transport now returns the playback cursor to the top of the
    file, so every press of the pad plays from the beginning rather than resuming
    wherever scrubbing left it - the tape deck's rewind, folded into play. The
    trigger is edge-detected rather than level, so it fires once per press
    instead of on every control tick while held.
    rewindToStart() takes the same care loadFile() does around the shared
    playback state: the audio interrupt reads resampler.index and the ring buffer
    continuously, so it is disabled across the whole swap, and the buffer is
    re-primed before it comes back so playback does not wake into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
    [SDResampleDemo.ino]
2026-09-22 Add OPEN_ITEMS.md: outstanding issues and features
    Collects everything discussed but not yet done - tape transport follow-ups,
    the remaining ADC noise work, BLE/CodeLess loose ends, web page redeploys and
    two SDResampleDemo limitations - so the backlog is reviewable offline instead
    of living in a conversation. Links to CodelessPipe_design.md rather than
    repeating it.
2026-09-22 CapTouch: debounce isTouched() over consecutive scans
    The threshold comparison was a bare test of a single sample, so one noisy
    reading flipped isTouched() for exactly one scan. That is invisible to
    anything that merely displays or colours from it - a one-scan blip among
    fifty a second - which is why the SerialPlotterDemo looked perfectly clean on
    the same hardware that was misbehaving elsewhere. It is not harmless to
    anything edge-triggered: SDResampleDemo latches its transport on a rising
    edge and picked up spurious latches with nobody touching the pad. The
    glitches were always there; only the consumer changed.
    isTouched() now only changes state once the same answer has come back
    _debounc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
    [CapTouch.cpp, CapTouch.h]
2026-09-22 SDResampleDemo: latching transport, and an RGB LED transport indicator
    Pressing touch1 while touch2 is held latches the transport on, so playback
    continues after the finger lifts; the next press of touch2 clears the latch.
    Clearing it never interrupts playback, because the press that clears it is
    also holding the transport up by itself - so the latch engages and releases
    without a gap. Both triggers are edge-detected, and rewind fires on the
    rising edge of *running* rather than of the pad, so engaging or releasing the
    latch mid-playback does not jump back to the top.
    touch1 keeps its existing job of gating the speed knob's fast/slow sweep; the
    chord only means "latch" when touch2 is also do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
2026-09-22 SDResampleDemo: independent pitch control via granular time-stretch
    Speed and pitch were coupled by resampling alone - play faster, sound higher,
    exactly like a tape. Decoupling them needs one extra primitive:
    pitch shift = resample by r + time-stretch by 1/r
    speed change = time-stretch alone
    The resampler already did the first half. This adds the second as a two-tap
    crossfading granular shifter - the cheapest useful time-stretcher there is,
    with no FFT and no correlation search. The read position is held at a
    slowly-ramping offset behind the nominal playback position; when that offset
    has ramped a whole grain it wraps, and a second tap half a grain out of phase
    crossfades over the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
2026-09-22 SDResampleDemo: cue a file at boot, widen and recalibrate the pitch dial
    Boot now cues the first file on the card the demo can actually play, so the
    board is usable standing on its own - hold the transport pad and it makes a
    sound, with no phone, browser or BLE connection involved. Files that fail to
    load are logged and skipped rather than ending the search, which matters on a
    real sample card full of stereo, 24-bit and float files this demo cannot
    open; stopping at the first *name* would leave it silent for no visible
    reason. This does not bring back the SD activity the demo used to avoid:
    stopped means step 0, so loop()'s refill takes its paused branch and nothing
    touches the card until pl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
    [SDResampleDemo.ino]
2026-09-22 SDResampleDemo: pitch on the dashboard; park the latching bug with its data
    Adds PIT: to the stats line and a Pitch tile to the web page, dimmed at
    unity. Without it the UI showed only speed, so there was no way to see what
    the pitch knob was doing - which cost a test earlier today, when speed was
    set to 1.0 believing it was pitch.
    Removes the NOISE_DEBUG instrumentation and the temporary D31 reference
    channel used to chase the spurious transport latching. That investigation is
    parked for the carrier board and written up in OPEN_ITEMS.md, because the
    measurements rule out every software fix available:
    - the spurious events are full-strength capacitive signals, more than twice
    the tou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
    [SDResampleDemo.ino]
2026-09-23 NoiseMeter: measure touch, ADC noise and crosstalk, with toggleable fixes
    A Serial Plotter diagnostic whose traces all read zero on a perfect board:
    spurious touch excursions, per-pin ADC noise RMS, and crosstalk onto one
    pot while the other turns. Summary mode (one point per second) for
    comparing fixes; live mode for watching.
    Keyboard-toggled experiments: double read, longer ADC sampling time
    (ADSSTRL), discharge before sampling (ADDISCR), a running DAC, and
    DAC/ADC synchronization (DAADSCR) - none of which the Arduino core sets.
    Also corrects RV112FF's explanation of its throwaway read: the core's
    analogRead() scans every channel ever read on the unit, in fixed order,
    so the extra read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
    [NoiseMeter.ino, RV112FF.cpp]
2026-09-23 NoiseMeter: lifelike noise sources - SD card reads and the RGB LED
    Adds toggles f (read the first file on the SD card in 2KB chunks as fast
    as loop() runs, like SDResampleDemo's refill) and g (onboard WS2812 purple
    at 10%), alongside the existing d (DAC running). All three start off. A
    card that won't mount holds the STAT LED on for a second instead of
    blinking.
    [NoiseMeter.ino]
2026-09-23 NoiseMeter: restart the crosstalk measurement when an experiment changes
    Toggling b or c shifts every pin's readings slightly; mid-turn, that step
    was being counted as crosstalk against the pre-toggle starting point, or
    as a knob turning. Now any recognized command discards the current
    frame's readings and forgets the starting points and which knob was moving.
    [NoiseMeter.ino]
2026-09-23 CapTouch: match scan results to pads by order, fixing cross-pad spikes
    scan() credited each result to the channel number noted at that
    channel's Status 2. The hardware reaches the next channel's Status 2
    before the previous result is read, so if loop() was held up by an
    interrupt at the wrong moment, one pad's result was filed under the
    other. It also stopped polling as soon as CTSUSTRT cleared, which could
    leave the last result unread for the next scan to misfile.
    Now instances are kept sorted by channel and the Nth result goes to the
    Nth instance; a stale result is drained before each scan starts, and the
    loop waits briefly after the scan ends for any result still owed.
    Measured with Noi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
    [CapTouch.cpp]
2026-09-23 RA6M5AnalogTuning: one-call ADC tuning that removes crosstalk between pots
    New local library. begin(pin) wakes that pin's ADC unit, then sets a
    longer sampling time (64 states, 1.28us; ADSSTRn/ADSSTRL) and
    discharge-before-sample (ADDISCR) on every ADC unit that's on. Measured
    with NoiseMeter: crosstalk between the two RV112FF pots drops from
    230-280 counts to about 1. Compiles to a no-op returning false on any
    chip but the RA6M5, so sketches can call it unconditionally.
    Added to the Makefile's default LIBRARIES; CLAUDE.md documents it and
    the convention for keeping chip-specific code out of general libraries.
    [Basic.ino, RA6M5AnalogTuning.cpp, RA6M5AnalogTuning.h]
2026-09-23 RV112FF: make the throwaway settling read configurable
    setSettlingReads(n), default 1 (the existing behaviour, and the standard
    portable remedy for sample-and-hold crosstalk). Boards that fix the
    crosstalk in hardware - e.g. via RA6M5AnalogTuning - can set 0 and skip
    the overhead. Drops the RA6M5-core-specific explanation from the library;
    that now lives in RA6M5AnalogTuning.h.
    [RV112FF.cpp, RV112FF.h]
2026-09-23 Pot sketches: tune the ADC and drop RV112FF's throwaway read
    AudioKnobsDemo, AudioKnobsWebBLEDemo and SDResampleDemo call
    RA6M5AnalogTuning::begin(A2) in a marked RA6M5-specific section of
    setup(), and set both pots' settling reads to 0 when it succeeds.
    OPEN_ITEMS: the pot crosstalk is resolved, and the parked spurious-latch
    item is very likely the CapTouch result-swap bug fixed in 0ace123, since
    it only happened with touch2 held.
    [AudioKnobsDemo.ino, AudioKnobsWebBLEDemo.ino, SDResampleDemo.ino]
2026-09-23 RV112FF: add setOversampling(); SDResampleDemo oversamples its scrub knob
    setOversampling(n) averages n back-to-back readings per wiper (default 1).
    It cuts fast random ADC noise by about sqrt(n) without adding lag - unlike
    a longer smoothTau or differentiation window.
    SDResampleDemo uses 4 on pot2. Its rpm() drives the scrub directly, and at
    rest its noise was crossing the 0.5 RPM deadband ~1.5 times a second,
    heard as crumbs of garbled audio while stopped. Measured over a hands-off
    minute: 91 crossings before, 0 after; per-second max rpm median 0.52 ->
    0.20.
    [RV112FF.cpp, RV112FF.h, SDResampleDemo.ino]
2026-09-23 Document the 2026-09-23 noise investigation
    NOISE_DEBUGGING.md records the whole day - NoiseMeter's design, the
    datasheet and core findings, each measurement, what fixed the crosstalk,
    the touch spikes and the scrub crumbs, and what didn't help - as raw
    material for the article. OPEN_ITEMS' ADC section is closed out, and
    CLAUDE.md notes the pots' VREF supply and wiper-pin capacitors.
2026-09-23 Record the wiper filter capacitors' value (100nF)
2026-09-23 SDResampleDemo: halve the scrub gain to two seconds per turn
    SCRUB_SCALE 1/15 -> 1/30. With the scrub knob's ADC noise fixed, it's
    precise enough to want finer control. Tried on the bench and preferred.
    Trade-off noted in the comment: a backward scrub now has to reach about
    half a turn per second to overcome 1x forward playback.
    [SDResampleDemo.ino]
2026-09-24 pcb: routing touch-ups and zone refill
    [cassette-carrier.kicad_pcb]
2026-09-24 pcb: shrink the board to 120 mm wide
    Scale the outline, side bumps, hub silkscreen, mounting holes, pots and
    touch pads by 0.84 about the middle of the bottom edge, so the board keeps
    cassette proportions at 120 x 76.8 mm. The trapezoid window narrows but
    keeps its height (it follows the Thing Plus's top edge); J1, SW1 and C1/C2
    slide inward with the side bumps at their old height. Touch pads use a new
    TouchPad_33.6x16.8 footprint (still M3 antenna holes). The routes hanging
    off the moved parts were ripped up (13 connections left to route), the
    touch-trace In2 keepouts removed for redrawing, and the hub sprocket art
    moved to the back silkscreen to leave room for artwork there.
    Co-Authored-B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
    [cassette-carrier.kicad_pcb, cassette-carrier.kicad_sch]
2026-09-25 pcb: finish routing the 120 mm board, tape window silkscreen
    Route the connections left by the shrink (pots, audio filter, EN), with
    a new In2 GND strap joining the two ground-pour halves without crossing
    the touch traces. Redraw the In2 no-pour strips along the new touch
    traces, and restore the left audio channel's /AUDIO_L net (it had been
    merged into GND). Add a front-silkscreen outline of a cassette's tape
    window between the hubs, sized from the patent drawing.
    Apply the Touch net class only to the electrode side of R4/R5: on the
    header side (/D20, /D21) its 1.0 mm clearance could never be met by the
    0.1 in pin spacing.
    DRC: 0 errors, 0 unconnected.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
    [cassette-carrier.kicad_pcb]
2026-09-25 pcb: tape window silkscreen follows the patent drawing
    Replace the single window outline with the patent drawing's nested
    frame and pane (28.4 x 14.0 and 25.1 x 11.2 mm, measured from Fig. 2 at
    the board's hub-spacing scale), centred between the two hubs now that
    the part labels have moved down out of the way.
    [cassette-carrier.kicad_pcb]
2026-09-25 pcb: refill zones before the fab export
    [cassette-carrier.kicad_pcb]
2026-09-25 Add PowerOffLatchTest: probe the Thing Plus EN latch-up
    Grounding EN on a running Thing Plus RA6M5 leaves it half on: the VREF
    regulator (U6) back-feeds the 3.3V rail through the MCU's analog pins and
    keeps itself enabled via its pull-up to that rail. This sketch tried to
    break the latch from software by pulling VREF_EN low when the LVD1 voltage
    monitor trips. It can't: the MCU releases the pin at power-on reset
    (~2.6V), and U6 turns straight back on.
    Kept as an experiment: it also measures the time between the LVD1 trip and
    reset (~147us), stored in Standby SRAM, which survives a reset where main
    RAM doesn't.
    [PowerOffLatchTest.ino]
2026-09-26 pcb: switch the LiPo line instead of EN, clear the BLE antenna, add QR codes
    Grounding EN on a running Thing Plus latches it half-on (its VREF
    regulator back-feeds the 3.3V rail), so SW1 now switches the battery
    instead: a new JST-PH socket (J2, SparkFun polarity: pin 1 +) feeds VBAT
    through SW1, and EN is left unconnected. The battery path is 1 mm wide on
    In2.
    The window trapezoid is 6.25 mm wider on each side, so no copper pour sits
    within 4 mm of the BLE module's antenna, mirrored so the flipped lid board
    matches.
    A QR code for the WebBLE page sits between the touch pads as
    mask-on-copper, readable on both faces: F.Mask and B.Mask openings over
    GND squares on F.Cu and B.Cu, grounded to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
    [cassette-carrier-bom.csv, cassette-carrier.kicad_pcb, cassette-carrier.kicad_sch]
2026-09-27 Rename CapTouch to RA6M5CapTouch and look up touch channels by port pin
    The library is RA6M5 register code, and its old channel table was keyed
    by the Thing Plus's Arduino pin numbers, so on another RA6M5 board (the
    Portenta C33, say) it would have set up the wrong pins. It now maps each
    Arduino pin to its chip port through the core and looks that up in the
    RA6M5's fixed port-to-channel table (all 20 channels, from the manual's
    pin list), and sets up TSCAP by its fixed port, P207. Building for any
    chip other than the RA6M5 is now a compile error.
    The class keeps its name, so sketches only change their #include. On the
    Thing Plus the lookup gives the same channels as before (D20 TS05, D21
    TS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
    [AudioKnobsDemo.ino, AudioKnobsWebBLEDemo.ino, NoiseMeter.ino, RA6M5CapTouch.cpp, RA6M5CapTouch.h, SDResampleDemo.ino, SerialPlotterDemo.ino, WS2812TouchDemo.ino]
2026-09-27 SDResampleDemo: manage the SD card, play+latch and reset from the web page
    The WAV Remote page can now upload files to the card (with an overwrite
    prompt), rename and delete them, play a file with the transport latched,
    stop it, and reset speed and pitch to their defaults - all sized for touch.
    On the board this adds LATCH:, STOP, RESET:SPEED/PITCH, PUT:, REN: and DEL:
    commands and a LAT: telemetry field. Uploads send raw data with an ACK every
    128 bytes and a 384-byte window, since the module-to-chip UART has no flow
    control and a 512-byte receive buffer; data lands in a temp file that only
    replaces the real one when complete. Tested end to end over BLE with bleak
    from a Mac: MTU 65, about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
    [SDResampleDemo.ino]
2026-09-27 wav-remote: use writeValue() on iOS, stream uploads, keep the log across reloads
    Bluefy drops writeValueWithoutResponse() silently, which hung uploads at
    0 bytes; iOS now uses plain writeValue(), the fix AudioKnobsWebBLEDemo
    already relies on, while desktop Chrome keeps writeValueWithoutResponse().
    Uploads read the file 4KB at a time instead of all at once, in case the
    reload seen in Bluefy is the page running out of memory, and writes time
    out instead of hanging. The link log is kept in sessionStorage so it
    survives a reload and shows how far things got.
2026-09-27 wav-remote: send upload packets as exact-size copies, not buffer views
    On Bluefy, commands reached the board but upload data never did. Packets
    are subarray() views into a 4KB read buffer; a WebBLE bridge that
    serialises the whole underlying buffer would send 4KB per write, which is
    too big for one BLE write and gets dropped. Copying each packet to an
    exact-size array rules that out. Reproduced against a mock that behaves
    that way: the old page drops every data packet, this one uploads byte-exact.
2026-09-27 wav-remote: hold-to-record on phones, with review before saving
    On a touchscreen device whose browser allows the mic, Upload becomes Hold
    to record: press to start, release to stop, capped at 10 seconds, with a
    live recording indicator, timer and level meter. The take is resampled to
    16kHz mono 16-bit (the upload runs at ~1.8KB/s, so each second costs about
    18 seconds to send) and written as a WAV by the page itself, since phone
    browsers only record compressed audio. Then play it back, discard it, or
    save it as the first free userNNN.wav through the existing upload path; a
    take is kept until the board confirms the save.
2026-09-27 wav-remote: close the mic between takes, play takes via <audio>
    In Bluefy on iPhone, take playback came out of the earpiece: while the mic
    is open iOS keeps audio in record-and-play mode. The mic (tracks and audio
    context) now opens on each press and closes on release, and takes play
    through an <audio> element, which also ignores the ring/silent switch.
    Costs about 0.1s at the start of each take while the mic opens.
2026-10-05 SDResampleDemo: play up to 1024x from filtered copies cached on the card
    Reading the WAV itself at high speed both outruns the SD card (~20x) and
    aliases. MipCache now builds a ladder of half-band-filtered copies of each
    file in /sd/cache/<name>/ (1/2 .. 1/1024 rate), in the background, and
    playback reads whichever copy keeps it near one sample per tick. Copy
    changes crossfade between two voices over 20ms. The cache is checked
    against a fingerprint of the WAV, rebuilt if stale, and kept in step by the
    BLE upload/rename/delete commands; orphans are cleared at boot.
    Interpolation is now a windowed sinc whose cutoff tracks the read rate
    (SincInterpolator.h), so no copy is ever read with aliasi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
2026-10-05 SDResampleDemo: loop() profiler, dropped-tick count; BLE card test tool
    - PROFILE command prints, per loop() stage, how often it did real work,
    how long that took, and its share of the CPU, timed on the DWT cycle
    counter (the LED stage on micros(), since FastLED zeroes the counter).
    - The status line's "late" becomes "dropped": audio ticks that should
    have run by now (per micros(), at the timer's real ~48008Hz) but didn't.
    Timing gaps inside the ISR proved unreliable - FastLED resets CYCCNT,
    and micros() can jump a millisecond when read from a high-priority ISR.
    - tools/ble_card_test.py (make ble-card-test) drives upload, overwrite,
    rename and delete over BLE from the laptop, usi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
    [SDResampleDemo.ino]
2026-10-05 SDResampleDemo: speed knob runs smoothly through zero, no dead band
    The speed curve was a pure exponential from 0.1x to 1024x, which can't
    reach zero, so a dead band filled the middle of the dial and speed jumped
    from 0 straight to 0.1x at its edges. It's now R0 * (e^(k*t) - 1), mirrored
    for reverse: linear near zero, exponential further out, slowing smoothly
    to exactly 0 in the middle. k and R0 are solved at startup to keep 1024x at
    the end of the sweep and 1x where it sat before, so the feel above ~0.2x is
    unchanged. Stopping is the touch-pad transport's job now.
    Speed shows four decimals below 1x on Serial, in the BLE stats and on the
    web page, so very slow speeds don't read as 0.00x.
    C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
    [SDResampleDemo.ino]
2026-10-05 SDResampleDemo: read BLE input without blocking loop()
    ble.readOutput() is Serial2.readString(), which waits out its 20ms
    timeout on every arrival, stalling loop() - knobs included - for 20ms+
    per command, status line or probe echo. pumpBLEInput() keeps the same
    rule (a burst is over once the link has been quiet for 20ms) but checks
    it each pass instead of waiting for it.
    Acting on each line the instant its newline arrived was tried first and
    broke the Binary mode handshake and re-advertising after disconnect: the
    module needs its burst finished before it's answered.
    Also matches the module's +BINREQ exactly. indexOf() also matched the
    echo of the sketch's own AT+BINREQACK, so every handsh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
    [SDResampleDemo.ino]
2026-10-05 SDResampleDemo: connect over BLE first time, not every other time
    CodeLess Binary mode lasts exactly one connection - traced on the wire:
    a grant asked for on one connection takes effect when it ends, and the
    module asks the board to drop back to command mode after the next one
    (refusing just makes it ask forever). The page used to sit on the first
    connection waiting for a LIST reply that could never come there, and only
    reconnected after its retries ran out.
    - wav-remote.html: connect; if the board isn't talking within 0.7s, ask
    for Binary mode, hang up quietly after 0.5s and reconnect, retrying
    once. The old LIST-retry reconnect stays as a safety net. Comments that
    blamed the altern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
2026-10-05 SDResampleDemo: advertise every 100ms, so the board shows up fast
    CodeLess advertises about every 690ms by default, and phones and laptops
    only listen in short windows, so the board took anywhere from an instant
    to 20 seconds to appear in a device picker - and the page's reconnect
    waits for an advertisement too. AT+ADVSTART=100 (the fastest CodeLess
    allows) at boot, after a disconnect, and after every module restart: the
    module restarts each time it leaves Binary mode, and comes back at its
    default interval.
    +READY is now handled before anything else, in any link state: while the
    module reboots, an unanswered probe can make the board think the pipe is
    open, and +READY was then treated as an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
    [SDResampleDemo.ino]
2026-10-05 wav-remote: sort the file list alphabetically, ignoring case
    The board lists files in the card's directory order - roughly creation
    order. Sort them on the page with localeCompare at "base" sensitivity.
2026-10-05 SDResampleDemo: play 8/24/32-bit PCM, float and extensible WAVs
    WavReader converts every supported format to the 16-bit samples
    everything downstream already uses, as it reads: 8-bit (unsigned), 16,
    24 and 32-bit PCM (top 16 bits - the DAC only has 12), 32 and 64-bit
    float, plain or WAVE_FORMAT_EXTENSIBLE headers. Stereo and compressed
    files are refused with a clear message; the format is logged on load.
    The header parser also honours odd chunks' pad bytes and trims a data
    size larger than the file.
    While a file's cache builds, the speed cap now always allows native
    speed - a 192kHz file needs 4 samples per tick at 1x, and was capped to
    half speed.
    tools/make_format_test_wavs.py writes 20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
2026-10-06 SDResampleDemo: switch copies with a hard cut, no crossfade
    With the interpolator now filtering both sides of a copy change the same
    way, the two copies differ by -54dB or less at the moment of a change
    (measured on the board), and a hard cut was inaudible on pure tones, a
    bright sawtooth, a sine sweep and a drum loop. Dropping the 20ms fade
    means the audio interrupt only ever renders one voice: worst case down
    from 79% to ~44% of a tick, leaving room for post-processing. Two voices
    remain - one plays while the other is opened and primed - but switching
    is now a single swap.
    make_test_wav.py gains --saw (a bright sawtooth) and --exact (cut at
    exactly --seconds, so the loop point jumps), for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
    [MipCache.h, SDResampleDemo.ino, SincInterpolator.h, Voice.h]
2026-10-06 SDResampleDemo: play stereo WAVs, left on A0 and right on A1
    Mono and stereo files now play at every supported bit depth, rate and
    header style; mono still plays the same signal on both DACs, and files
    with more than two channels are refused.
    - RingBuffer counts frames, with the channel count set per file; each
    voice's buffer doubles to 32768 samples (16384 stereo frames).
    - WavReader reads frames (readFramesAt/totalFrames) and accepts stereo.
    - MipCache builds interleaved stereo copies, filtering each channel on
    its own; the channel count joins info.txt (format 3, so caches rebuild).
    - readSinc() works each tap's weight out once for both channels, so
    stereo costs a multiply-add per t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
2026-10-06 CLAUDE.md: SDResampleDemo, RA6M5FastSD, and what they taught us
    Adds the SD slot (and the core driver's two bugs), the bench card, the
    CodeLess one-connection Binary mode and 100ms advertising findings,
    stereo on the jack, FastLED's interrupt masking and cycle-counter reset,
    the core's -Os/-fno-builtin flags, FspTimer's tick-dropping re-enable,
    the tools/ helpers, RA6M5FastSD in the library lists, and a short
    overview of SDResampleDemo.
2026-10-06 Add scrub knob model for the RV112FF pots
    Parametric OpenSCAD knob for scrubbing audio: a knurled 44mm base disc
    with six spherical fingertip divots, a knurled tapered center knob, and
    a D-shaft socket per the RV112FF datasheet. The Customizer parameter set
    and an exported STL are included.
    [scrub_knob.scad, scrub_knob.stl]
2026-10-06 Add make knob target; export the scrub knob with its saved presets
    The Customizer saves tweaks to scrub_knob.json rather than the .scad
    file, so the export command (in the Makefile and the model's header
    comment) now loads that parameter set with -p/-P.
    [scrub_knob.scad]
2026-10-09 OPEN_ITEMS: refresh the list and add the planned SDResampleDemo features
    Drops items finished since 2026-09-21 (WAV formats, stereo, noise work)
    and ones judged moot, and captures the new feature list: knob modes,
    scrub tuning, calibration storage, per-file settings and the web UI
    reorganization.
2026-10-09 License the project: LGPL libraries, GPL software, CERN-OHL-S hardware, CC BY-SA docs
    Adds a top-level LICENSE explaining the split, the four license texts in
    LICENSES/, COPYING/COPYING.LESSER in each library folder so each can be
    published on its own, and an SPDX line plus authorship (specified by
    Mykle Hansen, implemented by Claude) at the top of every source file.
    The KiCad schematic and board title blocks carry the copyright and
    CERN-OHL-S notice, and their generators match. Vendored Faust headers and
    the compiler-generated synth.h are left as they were; LICENSE covers them.
    [cassette-carrier.kicad_pcb, cassette-carrier.kicad_sch, scrub_knob.scad]
2026-10-10 Drop the stale "public domain" notices; the SPDX header lines now say the license
    Missed in the licensing commit: 18 header comments still said the code
    was in the public domain, contradicting their new license lines.
    [AudioKnobsDemo.ino, AudioKnobsWebBLEDemo.ino, Basic.ino, DACAudioTest.ino, HelloWorld.ino, HelloWorldBLE.ino, NoiseMeter.ino]
2026-10-10 RV112FF: calibrated means complete; SDResampleDemo saves and restores it
    RV112FF's isCalibrated() and read() now wait for a complete calibration:
    a full turn of the shaft since either wiper's observed range last grew,
    which carries each wiper through both extremes - about two turns from
    power-on. The calibration snapshot records whether it was complete
    (format version 2), and restoring a complete one makes the pot usable
    at once.
    SDResampleDemo restores both pots' calibration from the Data Flash at
    boot, saves any pot that had none the first time the transport stops
    after it completes (so in practice once, ever), and gains a RECAL
    command to forget both and learn again. Tested on the bench: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
2026-10-10 SDResampleDemo: CAL prints each knob's saved and live calibration
2026-10-10 SDResampleDemo: scrub by position, overriding the transport, fitted to each file
    The scrub knob now sets where the cursor should be - from its change in
    angle, not its speed - and the cursor is steered onto that target, so
    the knob's position maps exactly onto the file. While it's turning it
    owns the cursor outright and the transport waits underneath, resuming
    once the knob has been still for 150ms. One turn is fitted to each file
    as it loads: the nearest power-of-two fraction or multiple of its length
    to one second of audio, so whole turns line up with the loop.
    A scrub starts only after the knob moves a clear degree from where it
    last came to rest, then follows through a 0.3-degree backla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
2026-10-10 SDResampleDemo: glide the scrub's speed between control ticks
    The audio interrupt used to jump to each new step loop() worked out,
    100 times a second, so a scrub was a staircase of tiny pitch steps -
    heard as a warble. While the scrub knob drives, it now glides to each
    step over one control interval. The speed knob still jumps: it didn't
    warble, and the glide's few milliseconds were audible as lag there.
    A copy change arrives at its new step at once, before priming the new
    copy: gliding down from 200x carried the cursor through several loops
    of a short file while the copy was read, far past the primed stretch,
    and playback underran forever.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
    [SDResampleDemo.ino]
2026-10-10 SDResampleDemo: reload the buffer if the cursor is ever stranded outside it
    A copy change hands the cursor to a copy read in around where it was a
    moment earlier. If the cursor moves further than that while the copy is
    read - a slow card, or a bug like the one the scrub glide briefly had -
    it lands outside the buffered stretch, and the refill can never reach it:
    playback stayed silent until a rewind or a new file. loop() now checks
    every pass and reloads the buffer around the cursor instead. Tested by
    moving the cursor 100,000 samples away mid-playback with a temporary
    command: forward it recovered with no underruns, backward with one tick.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
    [SDResampleDemo.ino]
2026-10-10 SDResampleDemo: no fragment when a file is picked while stopped; steady speed knob
    loadFile() started the tape at 1x whatever the transport was doing, then
    turned the audio back on and checked the cache - tens of milliseconds
    that played before the next control tick stopped it. It now starts at
    zero unless the transport is running.
    knob1 gets the same 0.3-degree backlash as the scrub knob: its reading
    jitters by a fraction of a degree at rest, which made the speed flicker
    between 1.00x and 0.9999x on the web page. At rest the requested speed
    now holds exactly.
    [SDResampleDemo.ino]
2026-10-10 SDResampleDemo: per-file speed and pitch, and come back to the cued file at boot
    Each WAV keeps its own speed and pitch in a small text file under the
    card's settings/ folder (FileSettings.h), saved two seconds after the
    last change and at once when another file is picked. settings/current.txt
    remembers the cued file, which is cued again at boot. Settings follow a
    rename, go with a delete, survive an upload over the same name, and
    orphans are cleared at boot. Pitch is now per file rather than global.
    The pitch knob re-anchors at the current pitch instead of always at
    unity - it used to snap PITCH: (and now a restored pitch) back to
    unshifted on the next tick in pitch mode. The Serial status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
    [FileSettings.cpp, FileSettings.h, SDResampleDemo.ino]
2026-10-10 SDResampleDemo: time-stretch on knob2 in pitch mode
    In pitch mode knob1 now sets the pitch you hear, and knob2 turns the
    same full-range speed dial knob1 does in speed mode while that pitch is
    held. The pitch shifter's grains read at the held pitch whatever the
    speed (grainTapRate), so it works through zero - a granular freeze -
    and backward. While stretching, the cached copy is chosen by the
    grains' read rate rather than the speed, keeping the treble up to
    about 8x. Speed mode is unchanged: tape-style speed with any shift kept
    as a ratio on top, and scrub on knob2.
2026-10-10 SDResampleDemo: relative pitch knob, two octaves per turn
    The pitch knob was a dial covering 5 octaves either side of the file's
    own pitch, at one octave per turn. At high speeds the pitch you hear is
    far outside that, so entering pitch mode anchored the dial at its end,
    the first turn snapped there, and getting back took many turns. It's
    now relative, like the other knobs: two octaves per turn from wherever
    the pitch is, out to 10 octaves either way.
    [SDResampleDemo.ino]
2026-10-10 SDResampleDemo: choose the copy by the grains' rate in both knob modes
    Speed mode chose its cached copy by the speed alone, so a large upward
    pitch shift read the original WAV hundreds of samples per tick with no
    filtering and aliased, while pitch mode (which already chose by the
    grains' rate) was correctly near silent. Switching modes switched the
    aliasing on and off with no change in speed or pitch.
    levelRateFor() now applies the one rule everywhere, including the copy
    rewindToStart() starts on.
    [SDResampleDemo.ino]
2026-10-11 SDResampleDemo: mode on the RGB LED, transport on the STAT LED
    The RGB LED carried both the knob mode (colour) and the transport
    (brightness and blinking), so the mode was invisible while stopped. It
    is now always lit in the mode's colour, and the blue STAT LED shows the
    transport: dark stopped, blinking while held, steady when latched.
    The RGB LED now only updates when the mode changes, so blinking no
    longer costs a dropped audio tick per update.
2026-10-11 SDResampleDemo: knob modes as a table, six LED colours
    The speed/pitch toggle (a bool) becomes a row of MODES: a name, an LED
    hue and brightness, and a function for each knob. loop() reads both
    knobs the same way every tick and hands each movement to the current
    row; the mode-specific code that was inline there is now turnPitch(),
    stretchTime() and scrubKnob(). touch1 steps through the modes.
    Two modes are built (behaviour unchanged) and four are placeholders, to
    try the colours: green, aqua, purple, pink, orange, yellow - clear of the
    board's red and blue LEDs, with green, aqua and yellow dimmed to match.
2026-10-11 SDResampleDemo: mode 3, the window - start and end points
    Knob1 moves the start of the stretch of file that plays and knob2 its
    end; the other modes treat that window as the whole tape (loop, rewind,
    scrub). The ends stop at the file's ends and can't come closer than
    20ms - push one into the other and both move.
    Looping only ever happened in fileOffsetFor(), which now maps a voice's
    position round its window rather than the file. When the window moves
    under a playing voice, moveVoiceWindow() cuts the read-ahead back to a
    short runway and re-anchors the mapping there, so there's no dropout.
    Saved per file with speed and pitch. WINDOW:<s>,<e> and RESET:WINDOW
    set it over Serial or BLE.
    Co-A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
    [FileSettings.cpp, FileSettings.h, SDResampleDemo.ino, Voice.h]
2026-10-11 SDResampleDemo: crossfade the window's seam
    The join from the window's end back to its start clicked on every lap.
    Its last 5ms (at most a quarter of the window) now fade into the lead-in
    to its start, so the lap ends where the first sample picks up; a window
    at the very start of the file fades its first frames in from what
    follows its end instead. Done as the audio is read from the card
    (readLooped(), fadeSeam()), so the audio interrupt is unchanged. The
    whole file, with nothing either side, loops as before.
2026-10-11 SDResampleDemo: select modes and files with the knobs while D20 is held
    Holding the left pad on its own turns the knobs into selectors: knob1
    steps through the modes every 60 degrees, knob2 through the card's WAVs
    every 30, each way, round and round. A file picked plays from its start
    while the pad stays held (or on, if the transport was already latched).
    The mode now steps on a tap - on release, if nothing was selected - so
    holding the pad to select doesn't also advance it.
    [SDResampleDemo.ino]
2026-10-11 SDResampleDemo: take out the three placeholder modes
    They were there to try the LED colours. Each further mode will be added
    on its own feature branch; the colours picked for them (pink, orange,
    yellow) are noted beside the MODES table and in OPEN_ITEMS.
2026-10-12 SDResampleDemo: echo mode, a feedback echo on the output
    The fourth knob mode (pink): knob1 sets the delay time, knob2 one amount
    for both the echo's level and its feedback. EchoDelay.h is a mono,
    half-rate delay line in RAM - 128KB, a millisecond to 2.7 seconds - run
    in the audio interrupt on every tick after the voice is rendered. The
    delay time glides, so the echoes bend in pitch like a tape echo's.
    When the transport stops the echo is damped: the feedback goes at once
    and what's on its way fades over about half a second. Scrubbing a
    stopped tape brings it back, until one delay time after the knob rests.
    ECHO:<seconds>,<amount> and RESET:ECHO set it from Serial or BLE, the
    stats line re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
    [EchoDelay.h, FileSettings.cpp, FileSettings.h, SDResampleDemo.ino]
2026-10-13 SDResampleDemo: tapping both pads three times resets the file's settings
    Three taps of the D20+D21 chord, each 30-400ms long and no more than
    400ms apart, put the current file's speed, pitch, window and echo back
    to their defaults; the RGB LED flashes white. The reset acts as the
    third chord lands, so no other pad gesture waits on it, and the chord
    still latches the transport as before. RESET:ALL does the same from
    Serial or BLE.
    [SDResampleDemo.ino]
2026-10-13 SDResampleDemo: trial with touch debouncing turned off
    The library's two-scan debounce costs 10ms per press and release. It was
    added against spurious latches that turned out to be the scan race fixed
    in 0ace123, so it should no longer be needed. Both pads now run with
    setDebounceSamples(1); OPEN_ITEMS says what to watch for and what to do
    when the trial ends.
    [SDResampleDemo.ino]
2026-10-13 SDResampleDemo: redesign the web page as Tweacman
    The companion page is now a one-line status bar (app name, link state
    or the cued track and playing/stopped, a play/stop button), a
    full-screen Connect button until there's a board, and three tabs at the
    bottom, so the page as a whole never scrolls:
    - Tweaks: a card per knob mode, its two settings side by side like the
    knobs. Each has an editable value, a slider and a reset that lights
    up when the setting isn't at its default; speed and stretch have a
    reverse button. The board's current mode is highlighted, and tapping
    a card or taking hold of one of its sliders puts the board in that
    mode. "Reset all tweaks" above and below the ca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
    [SDResampleDemo.ino]
2026-10-15 SDResampleDemo: filter mode, an MS-20-style resonant band-pass
    Mode 5 (orange): a high-pass and a low-pass in series, played like the
    MiniKorg 700's Traveler - knob1 moves the bottom cutoff, knob2 the top, five
    octaves per turn, each pushing the other along when they meet. Both keep a
    little resonance (the edge bump); the low-pass's rises as the band narrows,
    until it screams, held steady by soft clipping in the resonance loop. Wide
    open it's skipped entirely; narrowed it costs about 12% of the audio
    interrupt. Plain C++ - the same filter in Faust measured 925 cycles per
    stereo sample against 570, Faust's per-call overhead at one sample a call.
    When the sound stops, the echo and the filter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
    [BandFilter.h, EchoDelay.h, FileSettings.cpp, FileSettings.h, SDResampleDemo.ino]
2026-10-15 SDResampleDemo: the echo and filter fade out smoothly to the end
    The stop fade was a straight line in level, which is only 30dB down at 97%
    of the way and then drops to nothing - heard as a cut. It now follows
    (1 - t) cubed: 60dB down by 90%, arriving at nothing gently. The filter's
    resonance is also kept until the fade has finished, instead of being taken
    away at -40dB, which stopped the scream short. filter_render's scream test
    fades the same way and reports the level through each tenth of the fade.
    [BandFilter.h, SDResampleDemo.ino]
2026-10-15 RA6M5CapTouch: drop debouncing; isTouched() follows each scan
    The two-scan debounce was added against spurious latches whose real cause
    was the scan race fixed 2026-09-23. SDResampleDemo has run without it
    since 2026-10-13 with no phantom touches or releases, so it goes: the
    setDebounceSamples()/getDebounceSamples() API, its state and comments,
    SDResampleDemo's trial lines, and the trial's OPEN_ITEMS entry. Each press
    and release now registers a scan sooner.
    [RA6M5CapTouch.cpp, RA6M5CapTouch.h, SDResampleDemo.ino]
2026-10-15 SDResampleDemo web page: a card for filter mode
    An orange card on the Tweaks tab with the filter's two cutoffs, Low and
    High, from the stats line's FLL:/FLH: and set with FILTER:<low>,<high>.
    Sliders run evenly in octaves from 20Hz to 20.5kHz, as the knobs do, and
    values read in Hz or kHz (typed in Hz). As on the board, the cutoffs can
    meet but not cross: dragging one into the other pushes it along.
2026-10-15 SDResampleDemo web page: stack the filter's sliders, Traveler-style
    The filter card's Low and High sliders sit one above the other on the same
    20Hz-20kHz scale, like the MiniKorg 700's two Traveler levers, so a
    frequency is at the same place on both and the band is what lies between
    the thumbs. Each row is its value and reset, then a slider the width of
    the card.
2026-10-15 SDResampleDemo web page: High above Low on the filter card, Low mirrored
    High's row is on top; Low's is below it, mirrored, with its slider on the
    left and its value, reset and name to the right.
2026-10-17 SDResampleDemo: gentler speed dial above 1x, doubling every half turn
    From 1x the speed now doubles every 180 degrees (2x at half a turn, 4x at
    a turn, 1024x at five turns) instead of roughly every 50 degrees, which
    reached about 140x in one turn and was too twitchy at high speeds. Below
    1x the curve is unchanged. The dial is now worked in degrees from the
    middle (speedForDial/dialForSpeed), replacing knobAngle/angleToSpeedRatio.
    [SDResampleDemo.ino]
2026-10-17 SDResampleDemo: crossfade into and out of the pitch shifter's bypass
    The shifter switched instantly between its grains and the single tap,
    which jumps the sound by up to a grain: a glitch every time a time-stretch
    passed through the held pitch (1x by default). Now shiftMix glides between
    them over 10ms, reading both only while it does.
    [SDResampleDemo.ino]
2026-10-17 SDResampleDemo: RESET:CACHE rebuilds the current file's cached copies
    [SDResampleDemo.ino]
2026-10-17 SDResampleDemo: USB disk mode - the SD card as a drive on the computer
    DISK:ON (a button on the web page's Files tab) stops playback, unmounts
    the card and opens UsbDiskGate, which until then tells the computer
    there's no card in the drive; ejecting it there, or unplugging the cable,
    hands it back. Uses the core's UsbMsd library, with a workaround for its
    512-byte bulk packets, which this board's full-speed port can't carry and
    which otherwise stop the board coming up on USB at all. Names starting
    with a dot (macOS's ._ files) are no longer listed or played.
    Measured with the stock library: ~115KB/s writing, ~550KB/s reading.
    [SDResampleDemo.ino, UsbDiskGate.h]
2026-10-17 SDResampleDemo: USB disk mode fixes - card start-up, unplugging
    - Start the card up in loop() before opening the gate, rather than letting
    the gate start it from inside the USB interrupt.
    - Watch the cable's VBUS sense directly: the core's driver never tells
    TinyUSB the cable has gone, so tud_mounted() stayed true and disk mode
    never ended on battery. On unplug, tell TinyUSB, which also stops Serial
    waiting forever on a computer that's no longer there.
    - Replies are DISKMODE:ON/OFF: the module echoes in command mode, and
    DISK:ON coming back was taken for the command again.
    - No page button for leaving without an eject (the computer isn't told);
    DISK:OFF stays as an emergency exit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
    [SDResampleDemo.ino, UsbDiskGate.h]
2026-10-17 SDResampleDemo: USB disk mode ends when the computer goes
    Unplugging is seen as the USB bus suspending for two seconds: the core's
    driver never reports an unplug to TinyUSB, and the VBUS sense stays high
    with the cable out on battery (measured). A sleeping computer counts as
    gone too, which is safe for the card - the gate shuts it out. Calling
    tud_task() from loop() after raising an unplugged event, and a
    tud_disconnect()/tud_connect() reconnect, both hung the board and are
    gone. OPEN_ITEMS: try it on Windows.
2026-10-17 SDResampleDemo: one natural-sorted file order for the page and the knob
    The file knob stepped through the card's raw directory order while the
    web page re-sorted the same names alphabetically, so the two disagreed.
    WavList.h now reads and sorts the WAVs on the board (natural order,
    case-blind, dotfiles still skipped); LIST sends them in that order, the
    page shows them as they come, and the knob and the first-file cue use
    the same list.
    [SDResampleDemo.ino, WavList.h]
2026-10-18 wav-remote: offer to open in Bluefy/WebBLE where there's no Web Bluetooth
    In a browser without Web Bluetooth (Safari or Chrome on iOS), the
    Connect button is now greyed out and labelled "No Bluetooth". On iOS
    the page also offers links that reopen it in Bluefy
    (bluefy://open?url=..., found by testing - Bluefy doesn't document it)
    or WebBLE (webble://host/path, from its release notes), plus App Store
    links for both. These are tap-to-open links, not an automatic redirect:
    a page can't tell whether an app is installed, and Safari shows an
    "address is invalid" alert for a missing one.
2026-10-25 SDResampleDemo: filter mode played by width and centre
    Knob1 now sets the band's width and knob2 its centre, in place of the
    bottom and top cutoffs. The band is half its width either side of the
    centre; an edge that runs off the end of the range stops there, and the
    width can grow until both edges reach their ends, so wide open is always
    reachable without re-centring. Turning the centre while wide open keeps
    it open. Underneath it's still a bottom and a top cutoff, so the saved
    settings, FILTER:, the BLE stats and the web page are unchanged; the
    centre and width are worked back out from them when a file loads.
2026-10-25 SDResampleDemo: the web page's filter card shows centre and width
    The filter card is now an ordinary card, Width beside Centre like the
    knobs, in place of the stacked Traveler-style Low and High. Width's
    slider tops out at wide open wherever the centre is, and shows the band's
    real width after clipping, or "Open". The board takes BAND:<centre>,<width>
    and reports FLC:/FLW: in the stats in place of FLL:/FLH:.
    A band at full width now opens exactly: off the middle of the range,
    rounding could leave an edge a hair short of its end and the filter still
    running.
    [SDResampleDemo.ino]
2026-10-26 SDResampleDemo: the filter's width reads steadily on the page
    The page decided whether the filter was open from the centre rounded to
    a whole Hz and the knob's width rounded to 0.01 octave - and away from
    640Hz those roundings outran its 0.01-octave margin, so Width flickered
    between Open and 9.99 as the centre turned. FLW: now reports the band's
    real width, after clipping at the ends of the range, which is exactly
    10.00 when open; the page works the knob's width back out from it for
    the slider and the BAND: command.
    make_test_wav.py --pink makes PINK.WAV, seamlessly looping pink noise to
    hear the filter by.
    [SDResampleDemo.ino]
2026-10-26 SDResampleDemo: filter width is its own setting, on a curve, closing both ways
    The width is now the space between the band's two edges, kept as set: the
    centre slides both edges together, and one pushed off the end of the range
    stops there without changing the width, which is what the page shows and
    what sets the dry/wet mix and resonance (BandFilter::setCutoffs() takes it).
    It runs 0 to 10 octaves, 10 being wide open at any centre.
    The width knob closes either way from wide open, over a turn and a half,
    on a squared curve - a quarter turn takes it to about seven octaves, plain
    to hear - and stops at wide open on the way back. The page's slider uses
    the same curve.
    Saved per file as filter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
2026-10-26 SDResampleDemo: the filter's centre slides the band out of hearing
    The centre now reaches 15 octaves either way from 640Hz, on a curve - five
    octaves a turn in the middle as before, a cube taking over further out,
    two turns each way - so even the widest band can be slid right out of
    hearing in either direction, to silence.
    BandFilter takes the band's edges anywhere. Its real cutoffs stay within
    20Hz-20kHz; the dry/wet mix follows how far the edges have come into
    hearing (so at full width, moving the centre brings a shelf in, where
    before it did nothing); and an edge past the far end turns the sound down
    12dB an octave, as the filter's own slope would if the cutoff could
    follow. Measured on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
2026-10-26 SDResampleDemo: note how the filter's knob design was settled, and what was tried
2026-10-26 AudioKnobsDemo: plot each knob's wipers, angle and pitch to the Serial Plotter
    Twenty lines a second: each knob's two wiper readings, its shaft angle
    and the pitch it plays, all on one 0-360 axis - the wipers scaled from
    the ADC's range, the pitch logarithmic from 50Hz to 10kHz. The wiper
    lines start at boot, so a pot can be watched calibrating.
    RV112FF gains wiper(), the smoothed reading its angle is decoded from,
    for plotting.
2026-10-26 RV112FF: minCalibrationRange is a setter, not a constructor argument
    Since calibration came to mean a complete turn, this is only a noise
    floor - how far each wiper must swing before an angle is worked out at
    all - so it rarely needs changing. setMinCalibrationRange() keeps it
    available, with a comment on the one case for lowering it: a wiper that
    can't swing that far never calibrates, without saying why. The
    constructor is now (pinA, pinB, smoothTau, rpmSmoothTau); nothing in
    this repo passed more than the pins.
    [RV112FF.cpp, RV112FF.h]
2026-10-26 RV112FF: read at 16 bits, and open RV112FF and MultiTurnKnob to any architecture
    analogReadResolution() only scales the result, by Arduino convention, so
    asking for 16 bits is exact on a 12-bit ADC and keeps every bit of a
    14- or 16-bit one, where the old fixed 12 threw the extras away. Teensy
    4 doesn't follow the convention - it stays at 12 bits, unscaled - so it
    is asked for 12; classic AVR has no analogReadResolution() and gets a
    clear #error.
    Nothing in either library needs the Renesas core, so both now declare
    architectures=*. The MultiTurnKnob example's USR_BTN reset is skipped on
    boards without one, and both examples say any analog pins will do.
    Tested: all six RA6M5 sketches build;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
    [RV112FF.cpp, RV112FF.h, SerialPlotterDemo.ino]
2026-10-26 RV112FF: support classic AVR at its fixed 10 bits (untested on hardware)
    Classic AVR boards have no analogReadResolution() - their ADC is always
    10 bits - so instead of stopping at an #error, the library skips that
    call there and divides by 1023. The comments say each read() takes about
    half a millisecond on AVR, and that this is untested on real hardware.
    Both examples compile for Teensy 2 (ATmega32U4) with no warnings.
    [RV112FF.cpp, RV112FF.h]
2026-10-26 RV112FF, MultiTurnKnob: comments stand alone, outside this project
    The libraries' comments no longer point at this project - its other
    libraries, its demos' polling rate, the RA6M5's Data Flash, notes in the
    Bela project it was ported from - since a reader using the library
    elsewhere can't follow them. The bench crosstalk figures now name the
    chip they were measured on, and MultiTurnKnob no longer mentions an
    RV112FF begin() that doesn't exist. Comments only; builds are unchanged.
    [RV112FF.cpp, RV112FF.h, SerialPlotterDemo.ino]
2026-10-26 MultiTurnKnob: isCalibrated(), instead of -1 for "not ready"
    -1 degrees is a real accumulated position - one degree backward of
    zero - so read() returning -1 before calibration was ambiguous, and
    every sketch had to compare for exactly -1.0f. read() now holds still
    until the pot is calibrated, and isCalibrated() says when it is.
    AudioKnobsDemo, AudioKnobsWebBLEDemo and SDResampleDemo use it. Both
    libraries' author and maintainer are now "Mykle Hansen".
    Tested on the bench: AudioKnobsDemo stays silent until each knob
    calibrates, then tracks smoothly through several turns backward past
    its starting point.
2026-10-29 SDResampleDemo: battery fuel gauge readout on the page's Info tab
    FuelGauge.h reads the board's MAX17048 (charge, voltage, CRATE drain
    rate) every 5s; the stats line carries BAT:/BV:/BCR: and the page shows
    them with the time left.
2026-10-30 SDResampleDemo: sets and a setlist for live performance
    Each folder at the card's root is a set; WAVs at the root stay playable as
    the default set. The page's new Set tab picks a set and runs a setlist
    through it: each track plays once, stopped at its window's edge in the audio
    interrupt, and while the deck is stopped and nobody is playing, the set's gap
    counts down and the next track starts, latched. Playing - the deck running,
    a pad touched, a scrub - has the setlist stand by. Latching by hand (the
    D20+D21 chord, or the page's play) sets a track looping until it's stopped;
    holding D21 loops too. Next and Prev act at once; Prepare builds a whole
    set's cached copies ahead of time.
    Settings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
2026-10-31 Note the on-stage touch pad failure; zsh completion for make SKETCH=
    OPEN_ITEMS.md: both touch pads went dead together at the 2026-10-30
    gig and later recovered - symptoms, the two theories, and what to add
    to find out next time.
    tools/make_completion.zsh: completes SKETCH= with every sketch in the
    repo, library examples included, rather than only the top-level names.
2026-11-01 RA6M5CapTouch: non-blocking scans, measurement count, stuck-scan recovery
    startScan()/update() run a scan without waiting for it: the hardware
    pauses at each pin for its settings and for the previous result to be
    read, so update() just answers whatever is pending. Tracking that by
    two counts (results read, settings written) rather than by watching
    for Status 2 to change also closes a latent gap where a slow loop()
    could miss a pin's settings step. scan() is now startScan() plus a loop
    on update(), so existing sketches are unchanged.
    setMeasurementCount() sets the hardware's repeats per measurement,
    re-centring the baselines on the first scan that uses the new count;
    overflowed() reports a p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
    [CapTouchPlotter.ino, RA6M5CapTouch.cpp, RA6M5CapTouch.h]
2026-11-01 CapTouchPlotter: plot readings per repeat, and back off a '+' that overflows
    Each scan is divided by the measurement count it actually ran with, so
    the traces keep their height (and a scan begun before a key press no
    longer spikes the plot); a '+' whose first scan overflows the counter
    steps back down.
2026-11-01 Add CapTouchTheremin: play pitch and volume by hovering over the touch pads
    D20 sets pitch over three octaves and D21 volume, by how close a hand
    is - a log curve on what the hand adds to each pad's reading spreads
    the range over the playable distance. Knob 1 sets how many of the
    latest scans are averaged (1-64, noise against lag), knob 2 the bottom
    note (C2-C5), and the USR button snaps pitch to semitones or a
    pentatonic scale. Scans run non-blocking, ~2300 a second; a plain C++
    wavetable oscillator plays from a 48kHz timer interrupt (4% CPU). Reads
    SDResampleDemo's saved pot calibration if present, without writing it.
    Tested unattended over Serial only: silent with hands away, steady
    rest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
    [CapTouchTheremin.ino]
2026-11-01 CapTouchTheremin: pitch on the right pad (D21), knob 2 clockwise-up, wider pitch spread
    From the first play: the pads were the wrong way round for a theremin,
    knob 2 ran backwards, and the pitch topped out about halfway through
    the pad's sensing range, so PITCH_FULL doubles to 8000.
    [CapTouchTheremin.ino]
2026-11-01 CapTouchTheremin: PITCH_FULL 14000, measured on the bench pads
    A hand right at the pitch pad adds about 14500 counts, so the pitch
    range now runs all the way there instead of stopping at 8000.
