myklemykle/tweacman/(notices)

Notices in the files:
pcb/cassette-carrier.kicad_pcb:
License: CERN-OHL-S-2.0. Footprints derived from SparkFun KiCad libraries (CC BY 4.0).
parts and their libraries:
SparkFun Thing Plus RA6M5, long (2.70 in) variant with the BLE module overhanging the PCB end. Pad geometry from SparkFun-KiCad-Libraries (CC BY 4.0); outline, LED, switch and module positions from SparkFun's Thing Plus RA6M5 dimension drawing. Origin = PCB centre, USB-C toward +y.
